tom-ainc/kitchen_bench_extension/51f2XC2JslL._SX522_.jpg

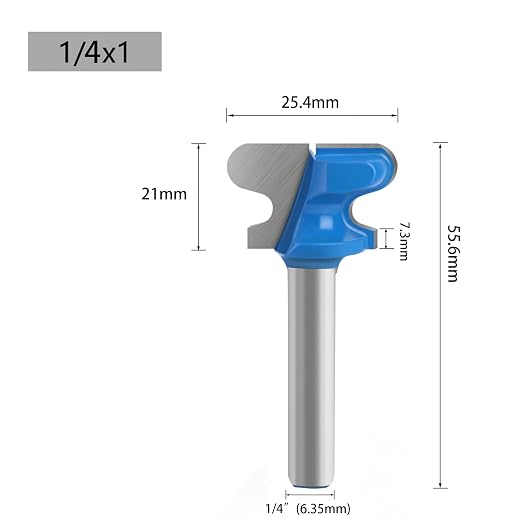
51f2XC2JslL._SX522_.jpg
