tom-ainc/kitchen_bench_extension/golf_project/golf_out/v0004_pose_clip_on_bracket/renders/r001/sheet.png

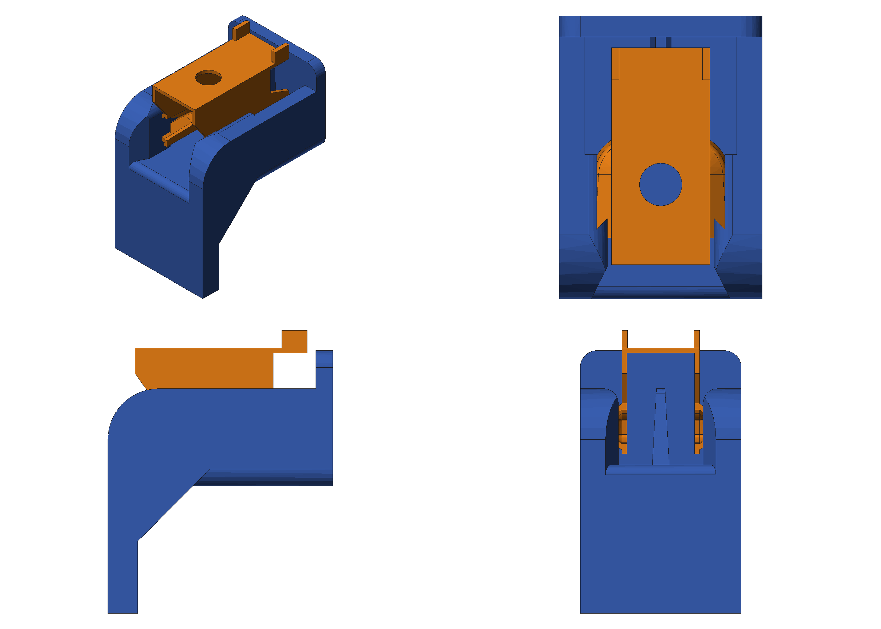
golf_project/golf_out/v0004_pose_clip_on_bracket/renders/r001/sheet.png
