tom-ainc/kitchen_bench_extension/golf_project/golf_out/v0008_option2_screws_flush/renders/r001/sheet.png

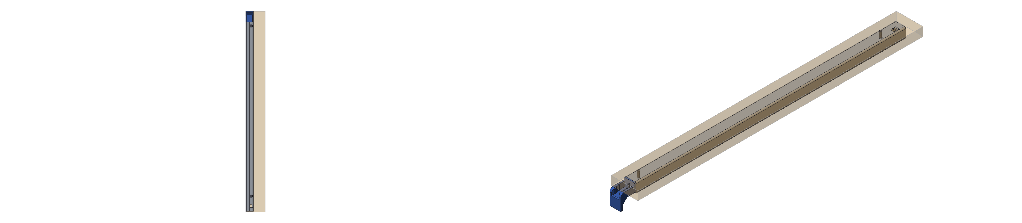
golf_project/golf_out/v0008_option2_screws_flush/renders/r001/sheet.png
