tom-ainc/kitchen_bench_extension/golf_project/golf_out/v0009_option1_closeup/renders/r001/sheet.png

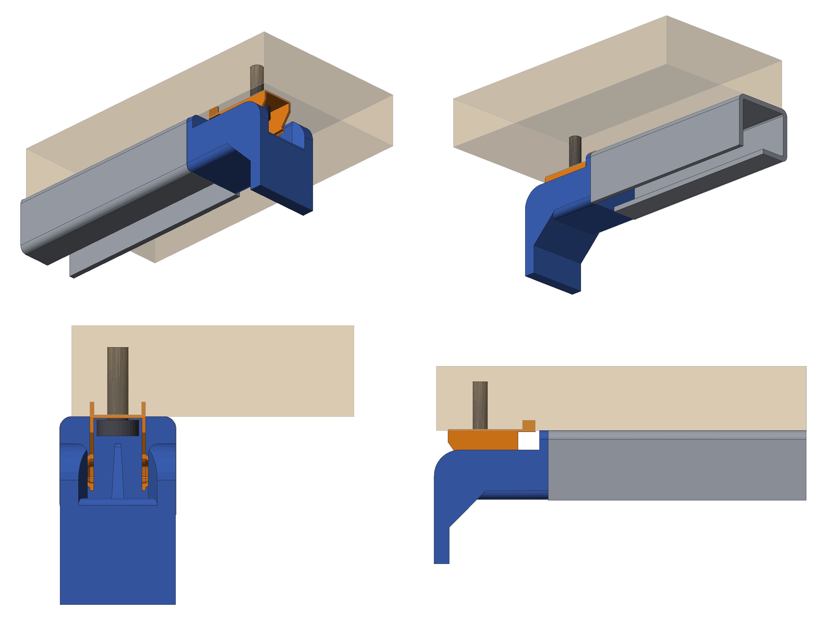
golf_project/golf_out/v0009_option1_closeup/renders/r001/sheet.png
