tom-ainc/kitchen_bench_extension/golf_project/golf_out/v0011_drawbar_boxes_opt1_notch/renders/r001/sheet.png

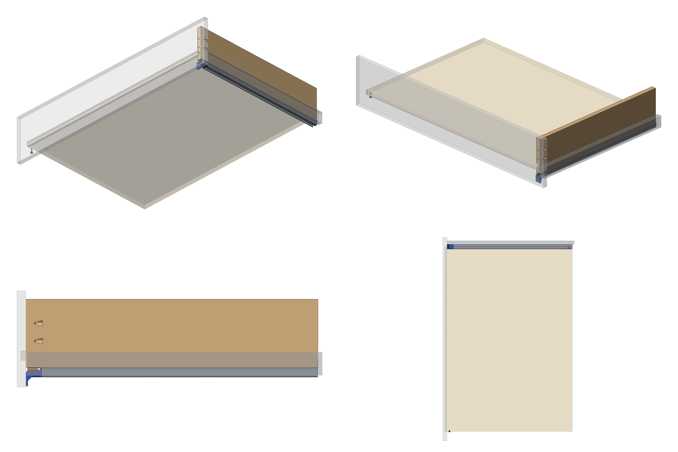
golf_project/golf_out/v0011_drawbar_boxes_opt1_notch/renders/r001/sheet.png
