tom-ainc/kitchen_bench_extension/golf_project/golf_out/v0016_pack_base_clip/renders/r001/sheet.png

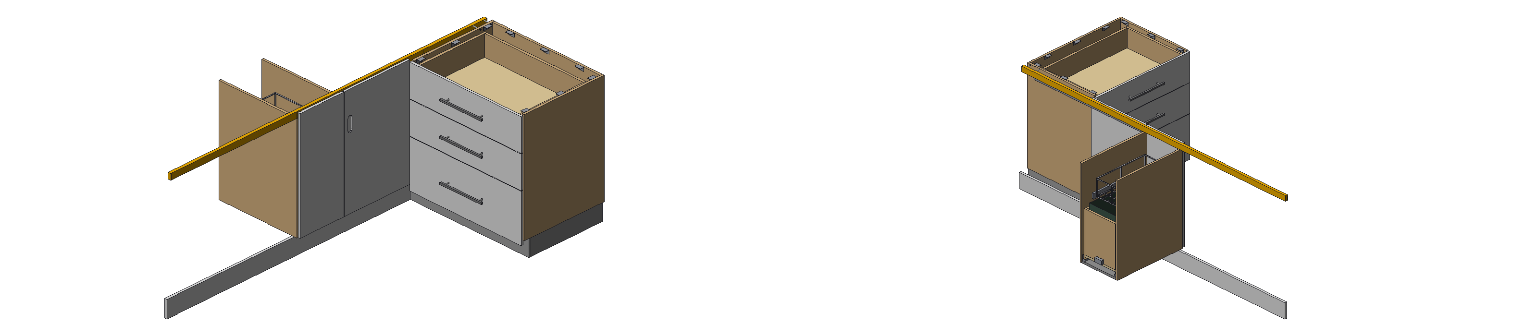
golf_project/golf_out/v0016_pack_base_clip/renders/r001/sheet.png
