tom-ainc/kitchen_bench_extension/golf_project/golf_out/v0017_detail_opt1_front/renders/r001/view_1__1.0__1.2__0.9_.png

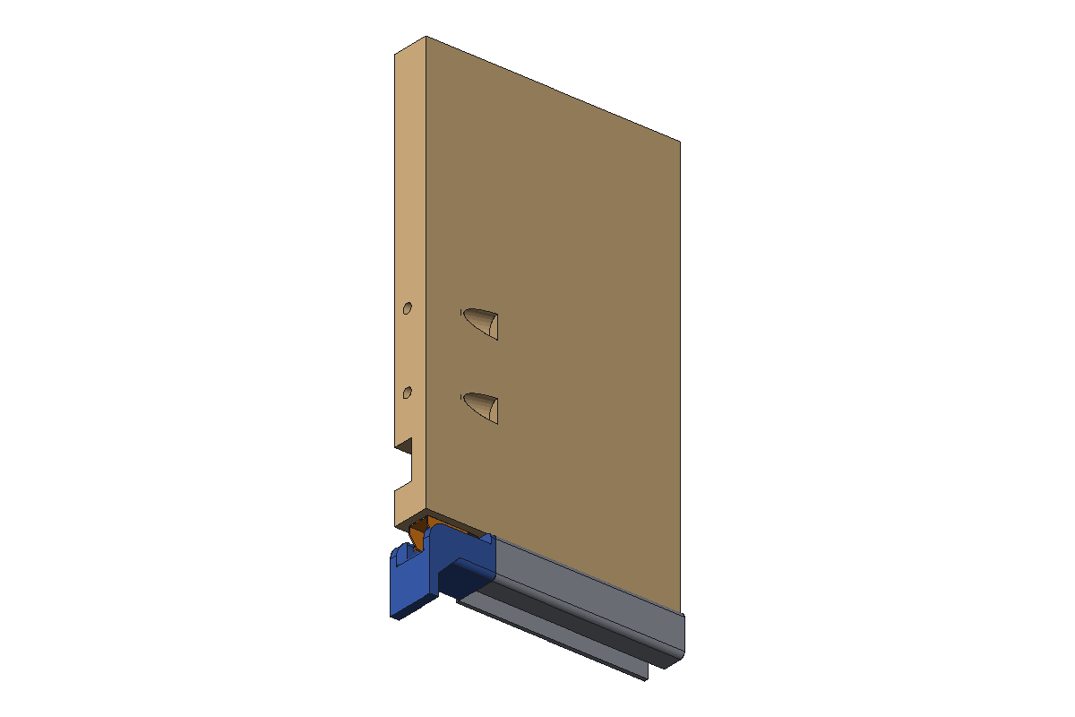
golf_project/golf_out/v0017_detail_opt1_front/renders/r001/view_1__1.0__1.2__0.9_.png
