tom-ainc/kitchen_bench_extension/golf_project/golf_out/v0023_cove_pull_r9_5/renders/r002/view_1_right.png

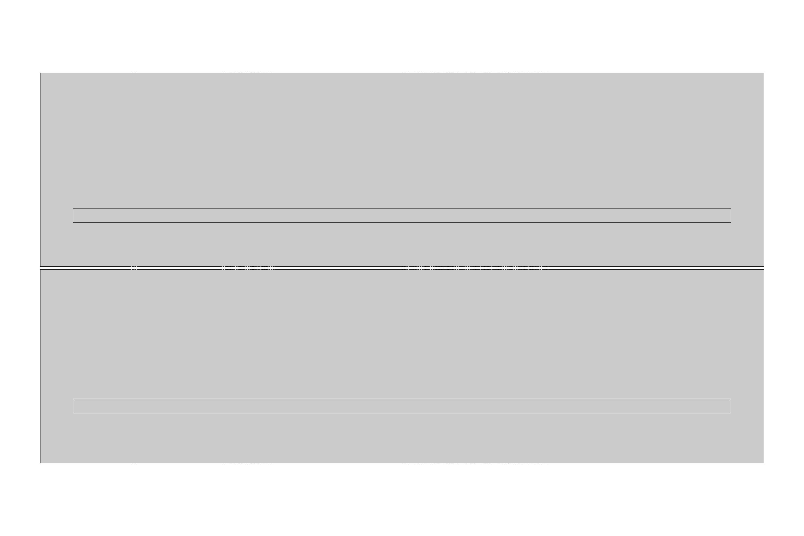
golf_project/golf_out/v0023_cove_pull_r9_5/renders/r002/view_1_right.png
