tom-ainc/kitchen_bench_extension/golf_project/golf_out/v0027_pull_back_cove_view/renders/r001/view_1_front.png

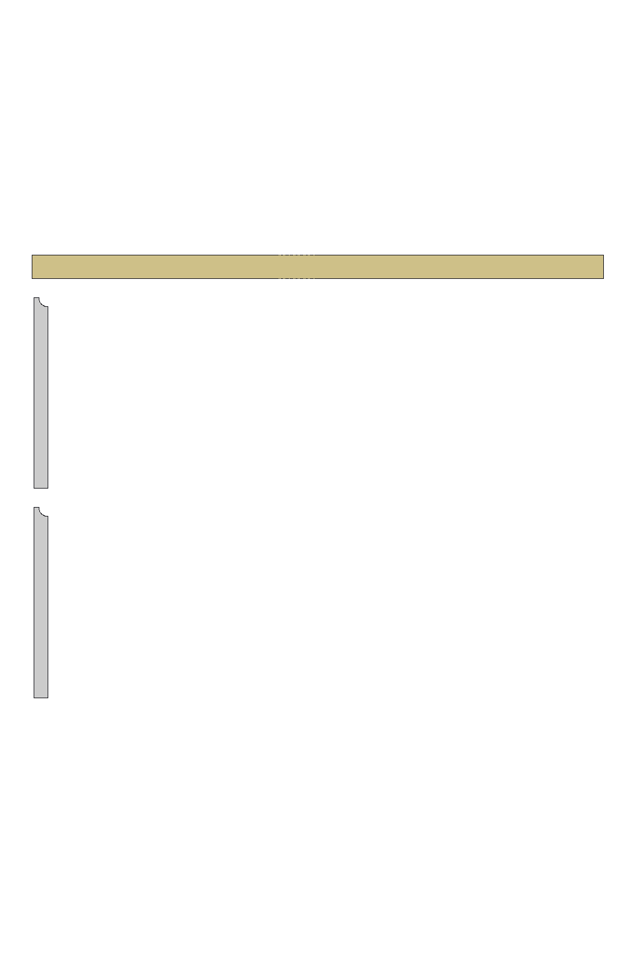
golf_project/golf_out/v0027_pull_back_cove_view/renders/r001/view_1_front.png
