tom-ainc/kitchen_bench_extension/golf_project/golf_out/v0028_pull_groove/renders/r001/sheet.png

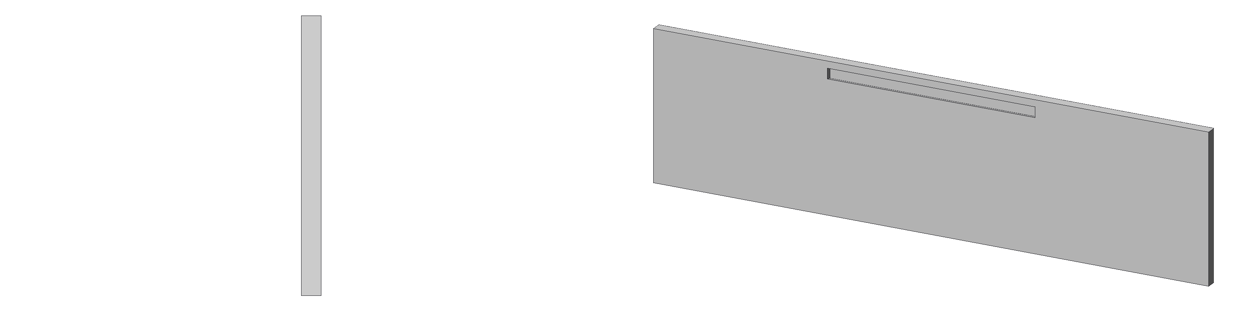
golf_project/golf_out/v0028_pull_groove/renders/r001/sheet.png
