tom-ainc/kitchen_bench_extension/golf_project/golf_out/v0035_pull_rebate/renders/r001/view_2_right.png

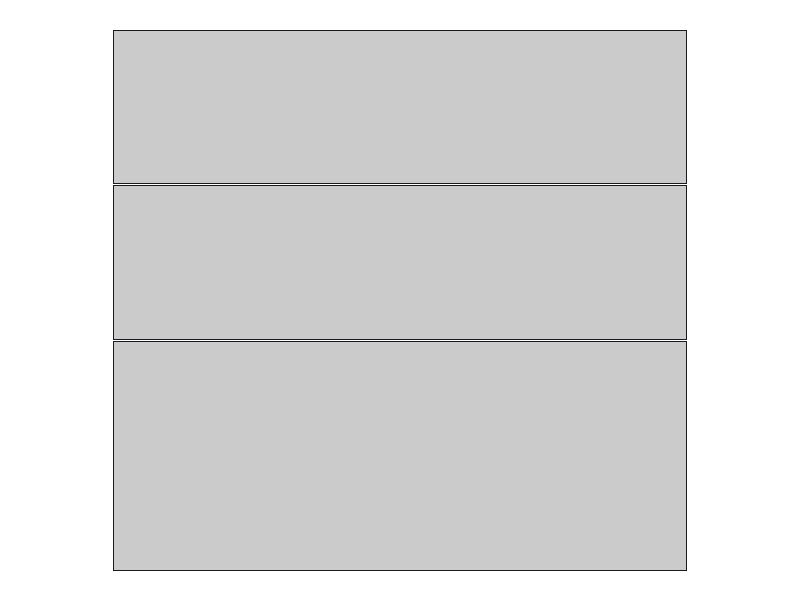
golf_project/golf_out/v0035_pull_rebate/renders/r001/view_2_right.png
