tom-ainc/kitchen_bench_extension/golf_project/golf_out/v0056_pocket_bore_through_face/renders/r001/view_1_bottom.png

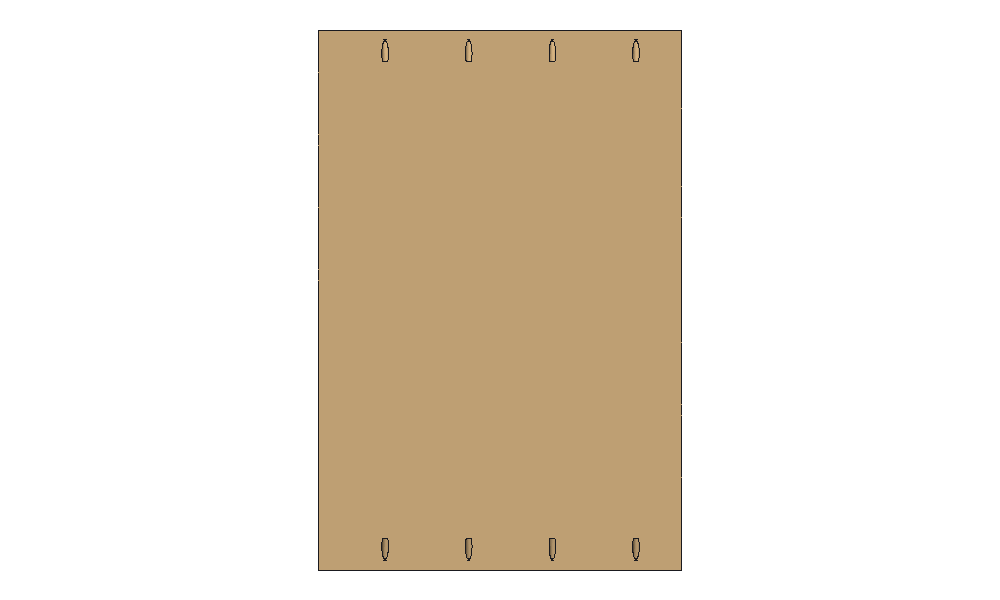
golf_project/golf_out/v0056_pocket_bore_through_face/renders/r001/view_1_bottom.png
