tom-ainc/kitchen_bench_extension/golf_project/golf_out/v0057_pocket_bore_clears_face/renders/r001/sheet.png

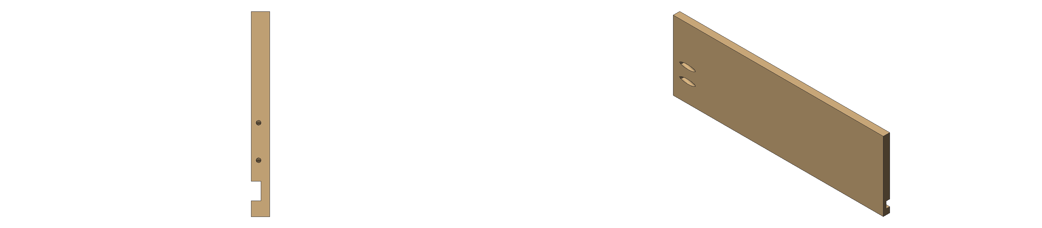
golf_project/golf_out/v0057_pocket_bore_clears_face/renders/r001/sheet.png
