tom-ainc/kitchen_bench_extension/golf_project/golf_out/v0059_ext/renders/r001/view_1__1.0__1.0__-0.8_.png

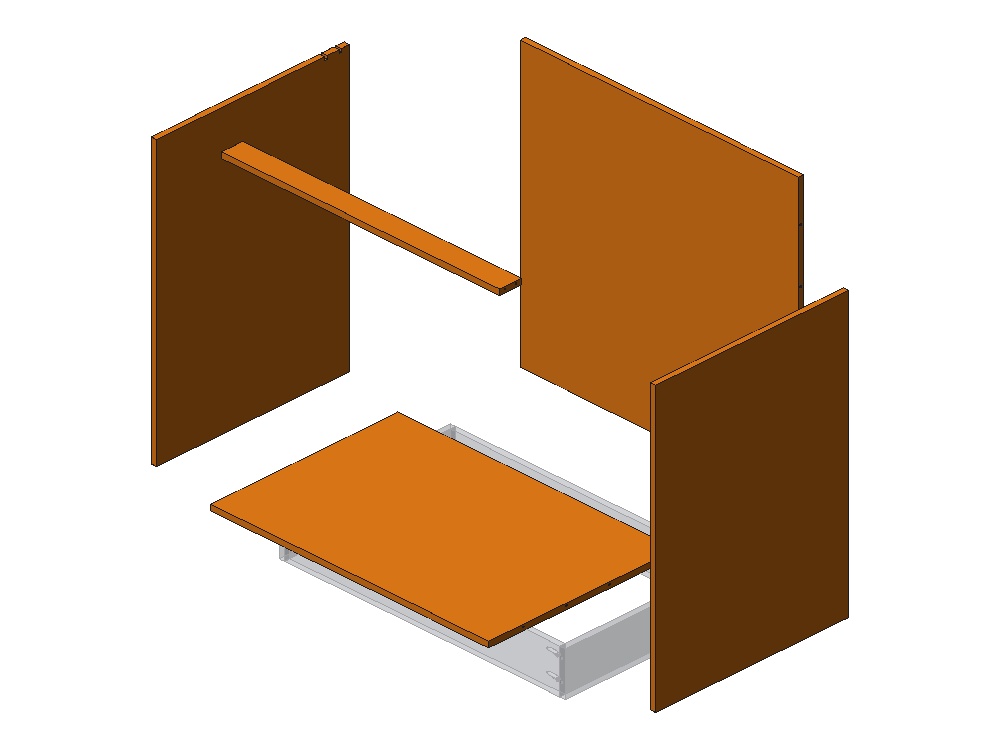
golf_project/golf_out/v0059_ext/renders/r001/view_1__1.0__1.0__-0.8_.png
