tom-ainc/kitchen_bench_extension/golf_project/golf_out/v0102_ext/renders/r003/view_1_iso.png

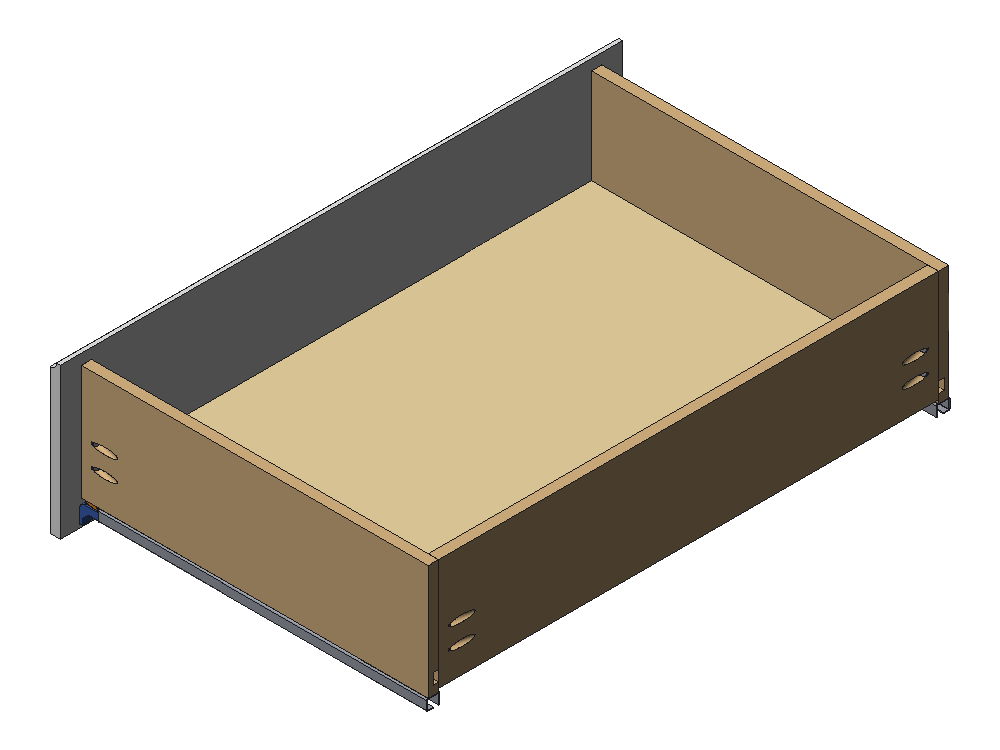
golf_project/golf_out/v0102_ext/renders/r003/view_1_iso.png
