tom-ainc/kitchen_bench_extension/golf_project/golf_out/v0128_ext/renders/r001/view_1__1.0__-1.0__-0.8_.png

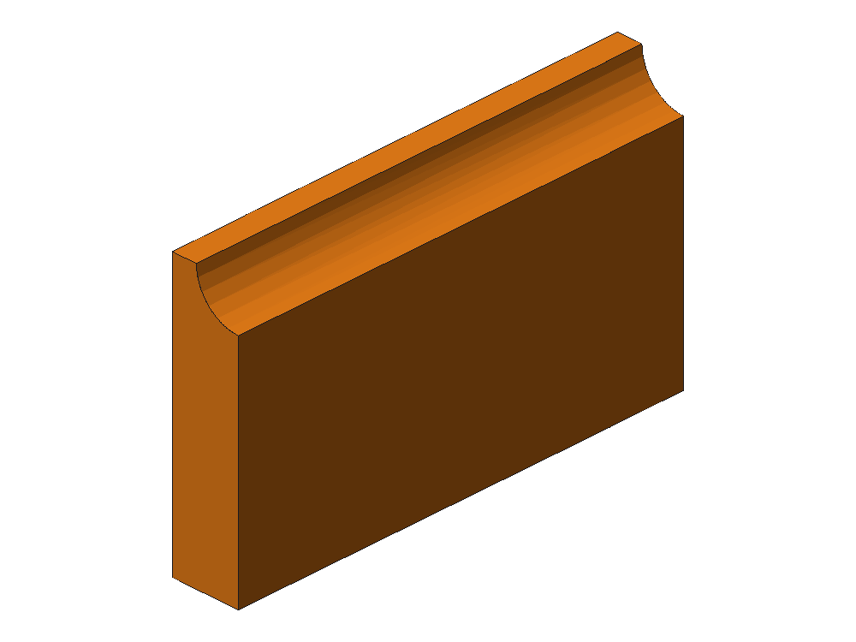
golf_project/golf_out/v0128_ext/renders/r001/view_1__1.0__-1.0__-0.8_.png
