tom-ainc/kitchen_bench_extension/golf_project/golf_out/v0133_overview_renders/renders/r005/view_1__1.0__0.55__-0.6_.png

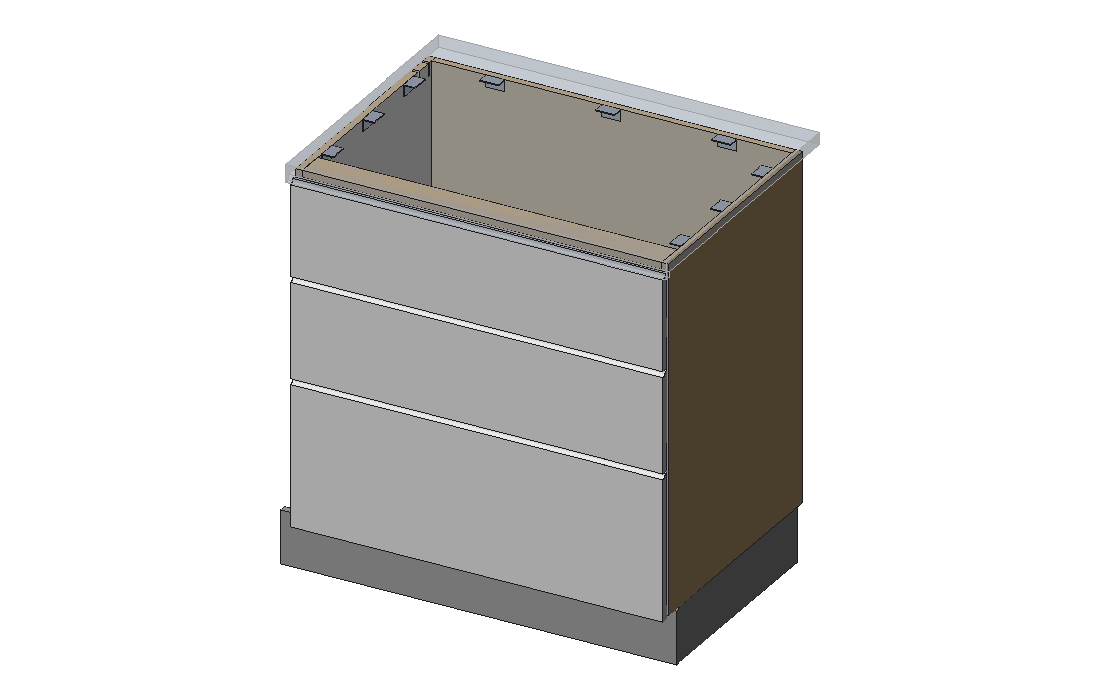
golf_project/golf_out/v0133_overview_renders/renders/r005/view_1__1.0__0.55__-0.6_.png
