tom-ainc/kitchen_bench_extension/golf_project/golf_out/v0135_mitre_pull/renders/r001/sheet.png

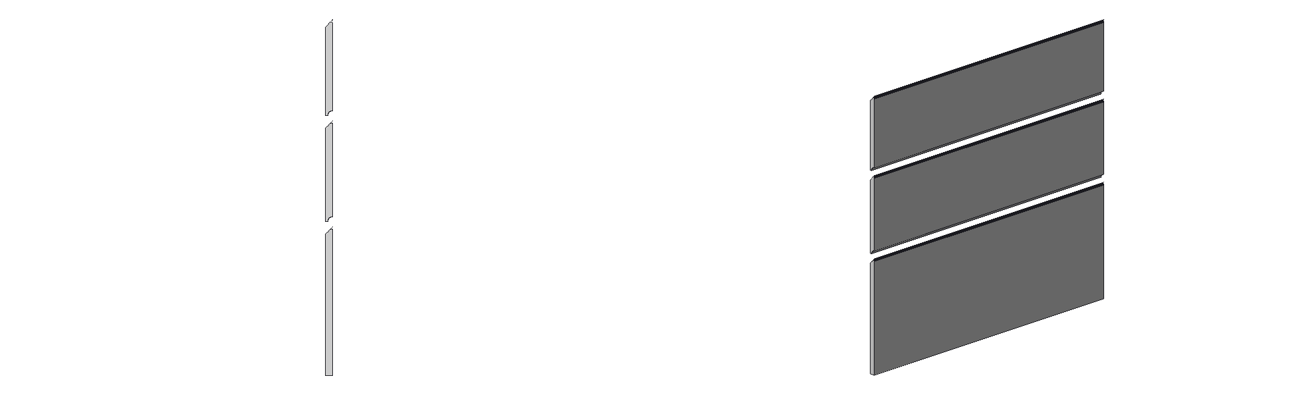
golf_project/golf_out/v0135_mitre_pull/renders/r001/sheet.png
