tom-ainc/kitchen_bench_extension/golf_project/golf_out/v0137_mitre_single_cutter/renders/r001/sheet.png

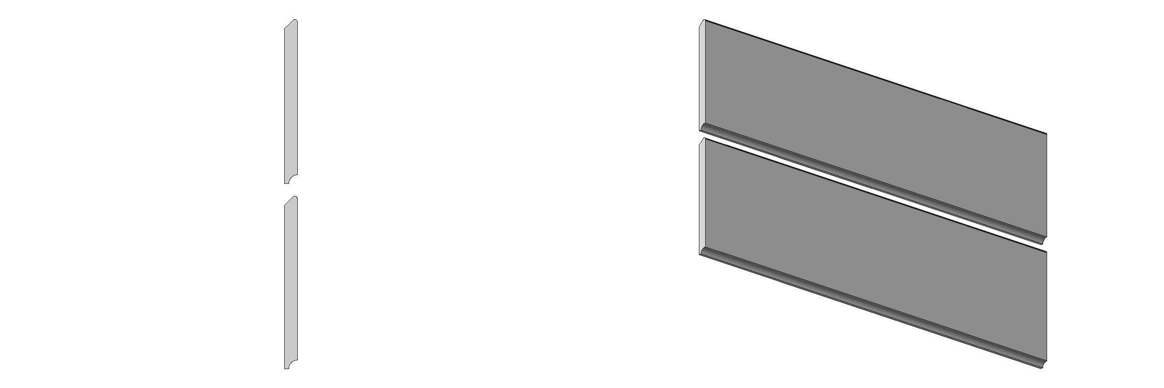
golf_project/golf_out/v0137_mitre_single_cutter/renders/r001/sheet.png
