tom-ainc/kitchen_bench_extension/golf_project/golf_out/v0138_mitre_d1_215/renders/r001/view_1__1.0__-0.6__-0.1_.png

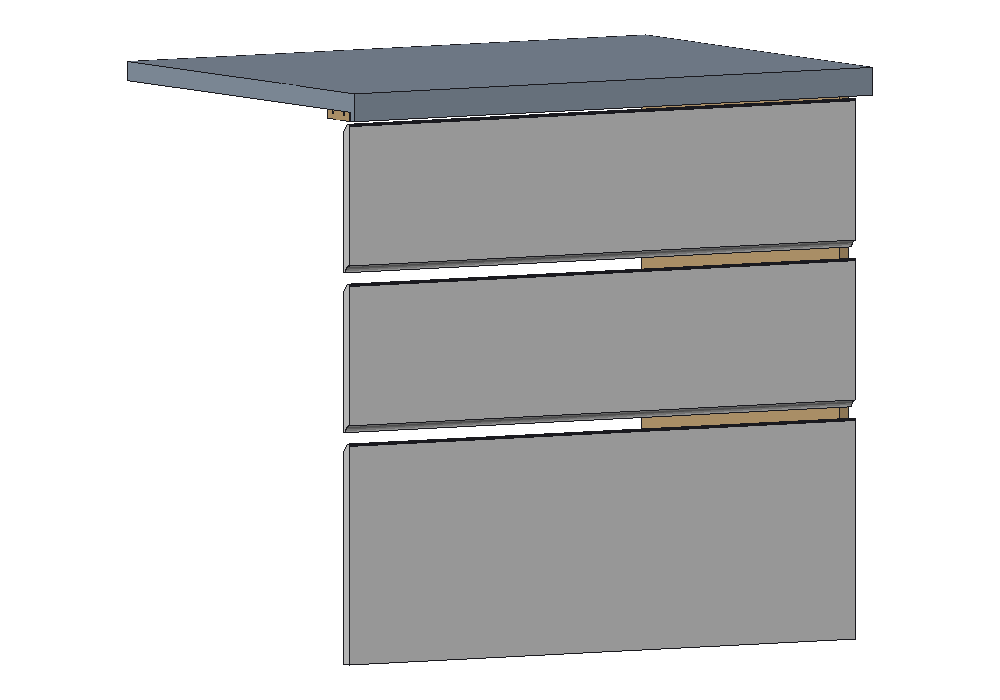
golf_project/golf_out/v0138_mitre_d1_215/renders/r001/view_1__1.0__-0.6__-0.1_.png
