tom-ainc/kitchen_bench_extension/golf_project/golf_out/v0140_mitre_all_cover1/renders/r001/sheet.png

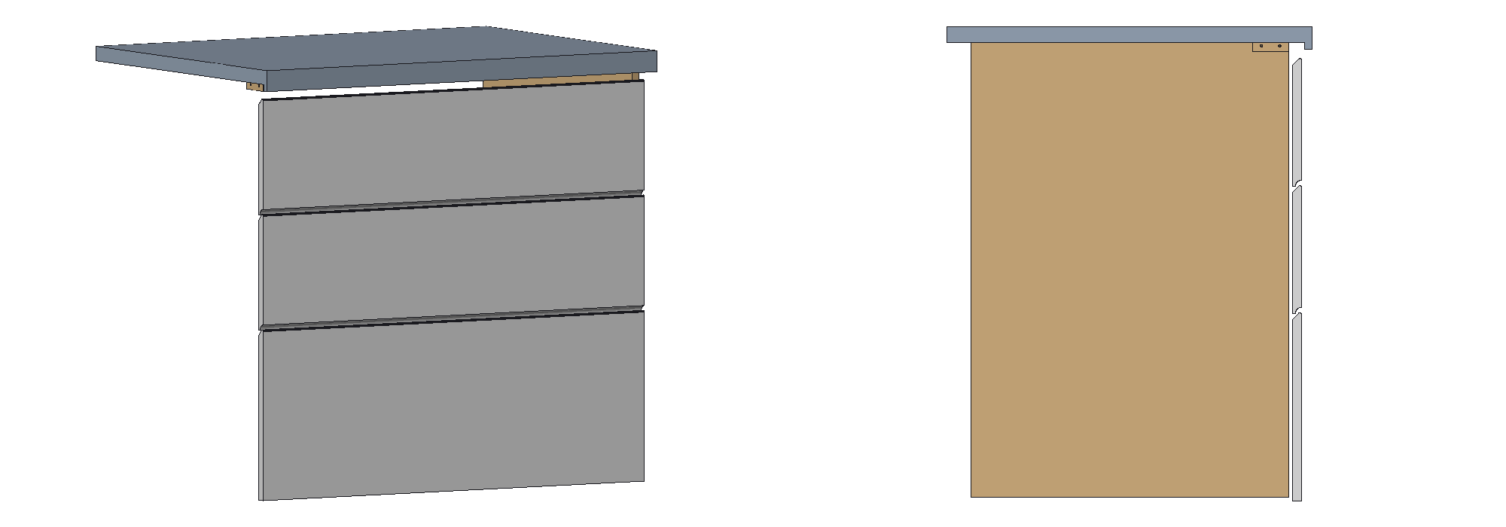
golf_project/golf_out/v0140_mitre_all_cover1/renders/r001/sheet.png
