tom-ainc/kitchen_bench_extension/golf_project/golf_out/v0154_ext/renders/r004/view_1__1.0__1.0__-0.5_.png

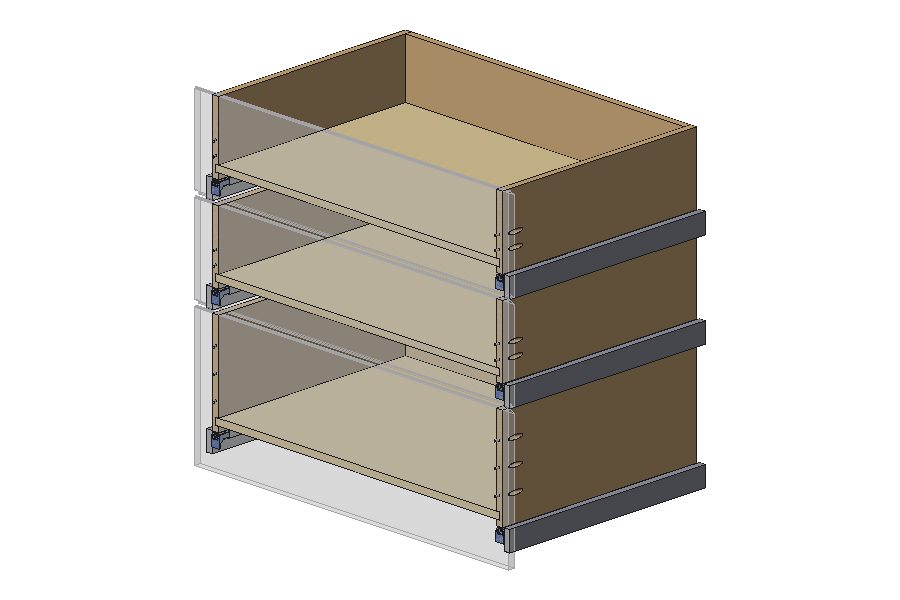
golf_project/golf_out/v0154_ext/renders/r004/view_1__1.0__1.0__-0.5_.png
