tom-ainc/kitchen_bench_extension/golf_project/golf_out/v0155_ext/renders/r001/view_1__0.35__-1.0__-0.55_.png

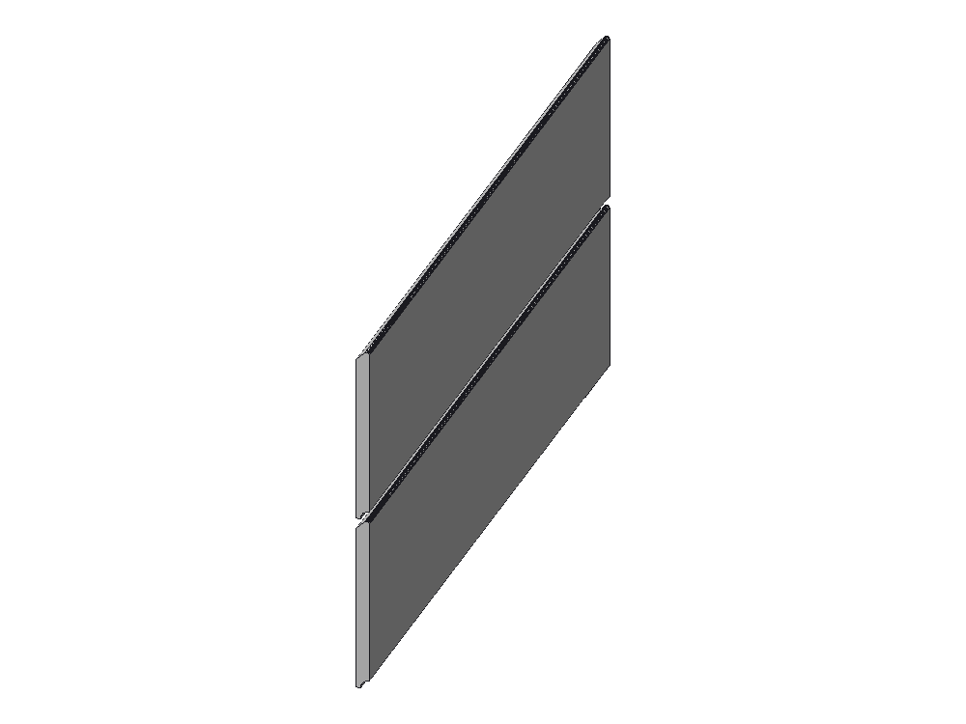
golf_project/golf_out/v0155_ext/renders/r001/view_1__0.35__-1.0__-0.55_.png
