tom-ainc/kitchen_bench_extension/golf_project/golf_out/v0157_bit_edge/renders/r001/view_2__0.35__-1.0__-0.55_.png

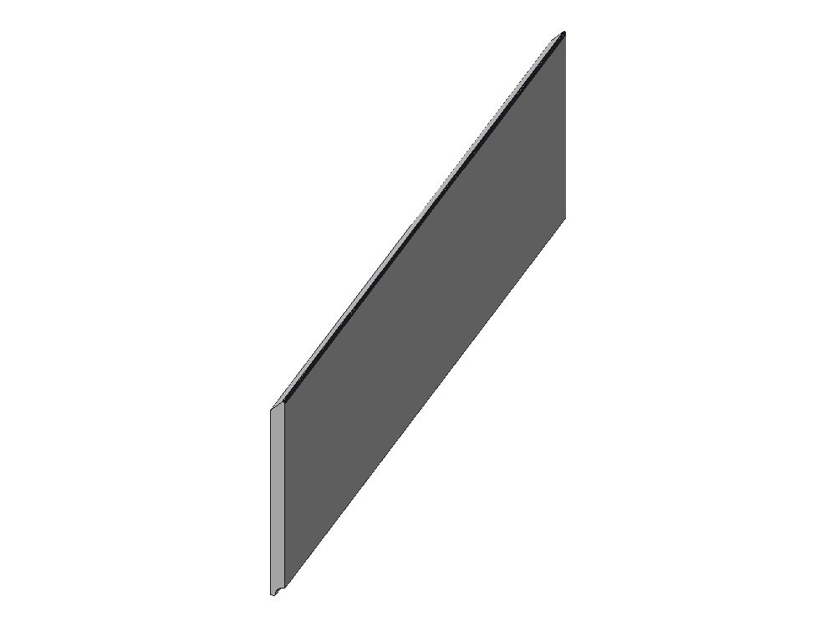
golf_project/golf_out/v0157_bit_edge/renders/r001/view_2__0.35__-1.0__-0.55_.png
