tom-ainc/kitchen_bench_extension/golf_project/golf_out/v0163_top_strip/renders/r001/view_1__1.0__0.55__-0.6_.png

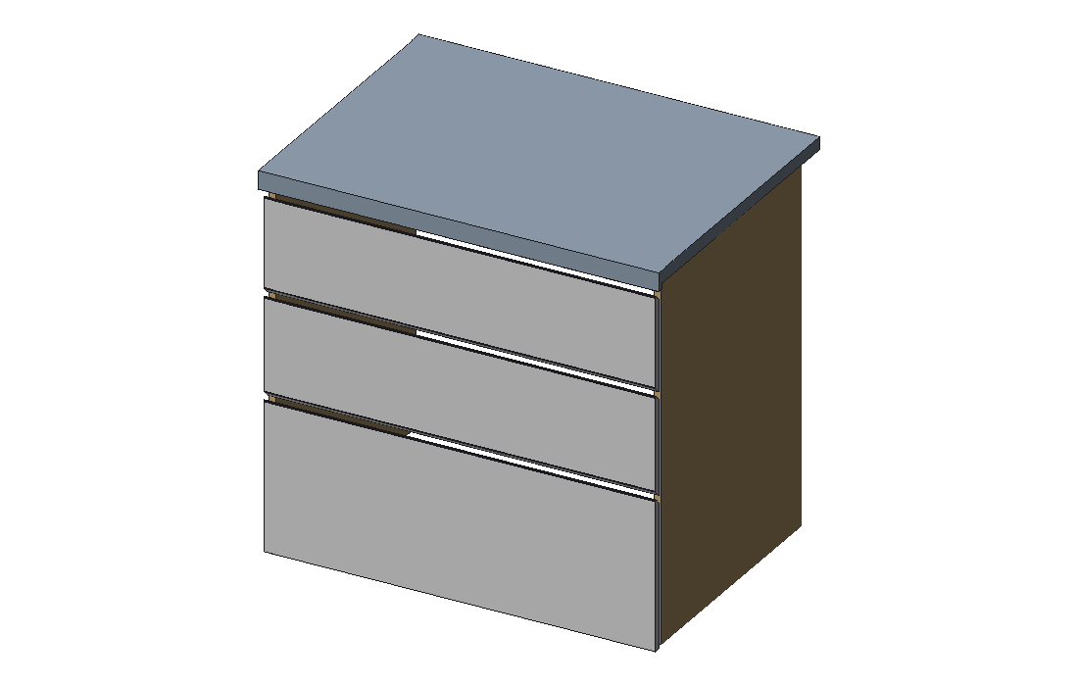
golf_project/golf_out/v0163_top_strip/renders/r001/view_1__1.0__0.55__-0.6_.png
