tom-ainc/kitchen_bench_extension/golf_project/golf_projects/kitchen_bench_extension-1/golf_out/v0034_ext/renders/r003/view_2__1.0__-1.0__-0.6_.png

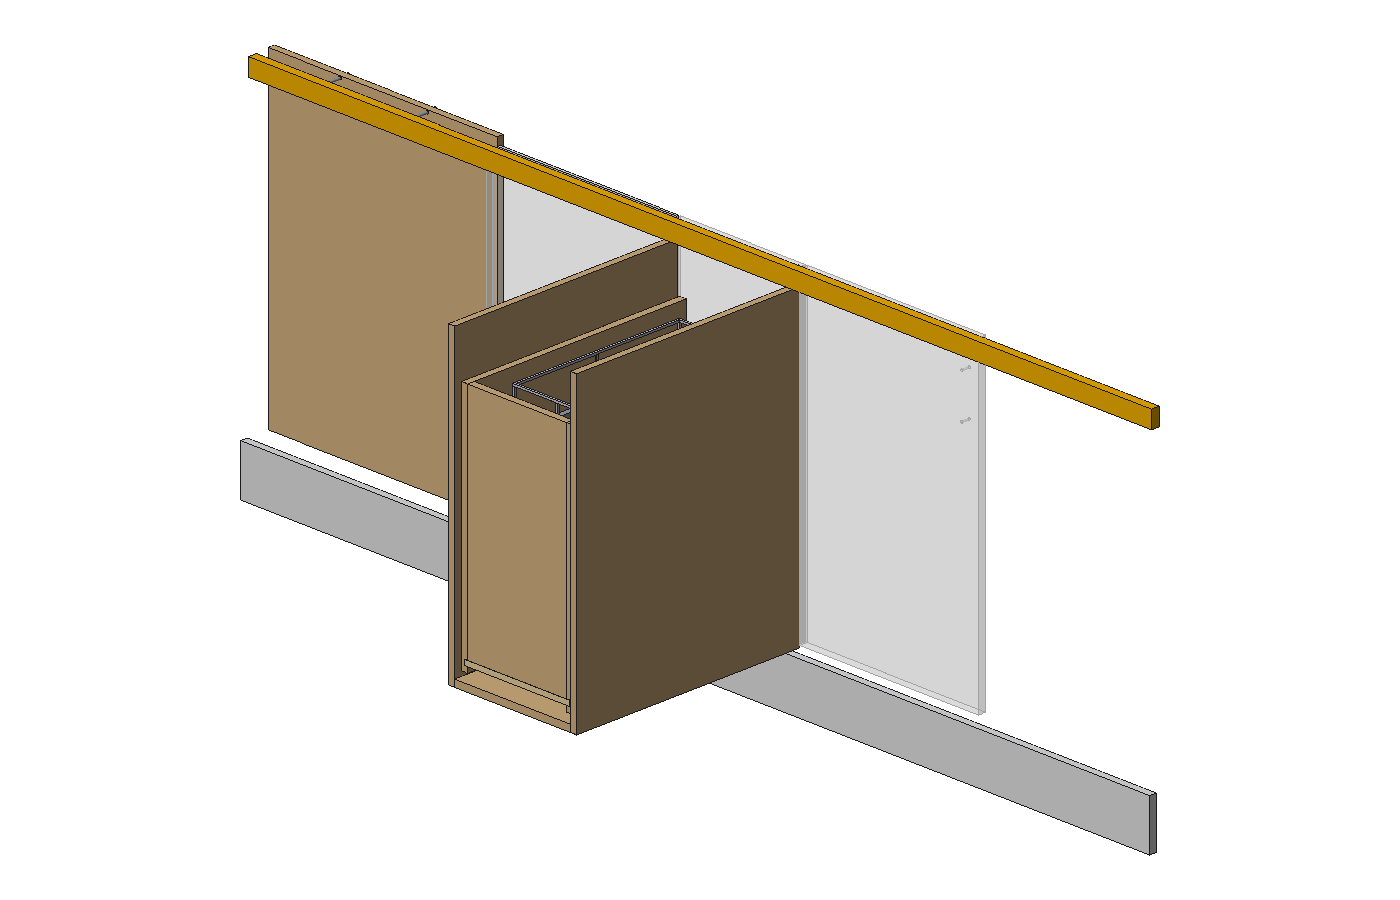
golf_project/golf_projects/kitchen_bench_extension-1/golf_out/v0034_ext/renders/r003/view_2__1.0__-1.0__-0.6_.png
