tom-ainc/kitchen_bench_extension/golf_project/golf_projects/kitchen_bench_extension-1/golf_out/v0034_ext/renders/r004/view_1_top.png

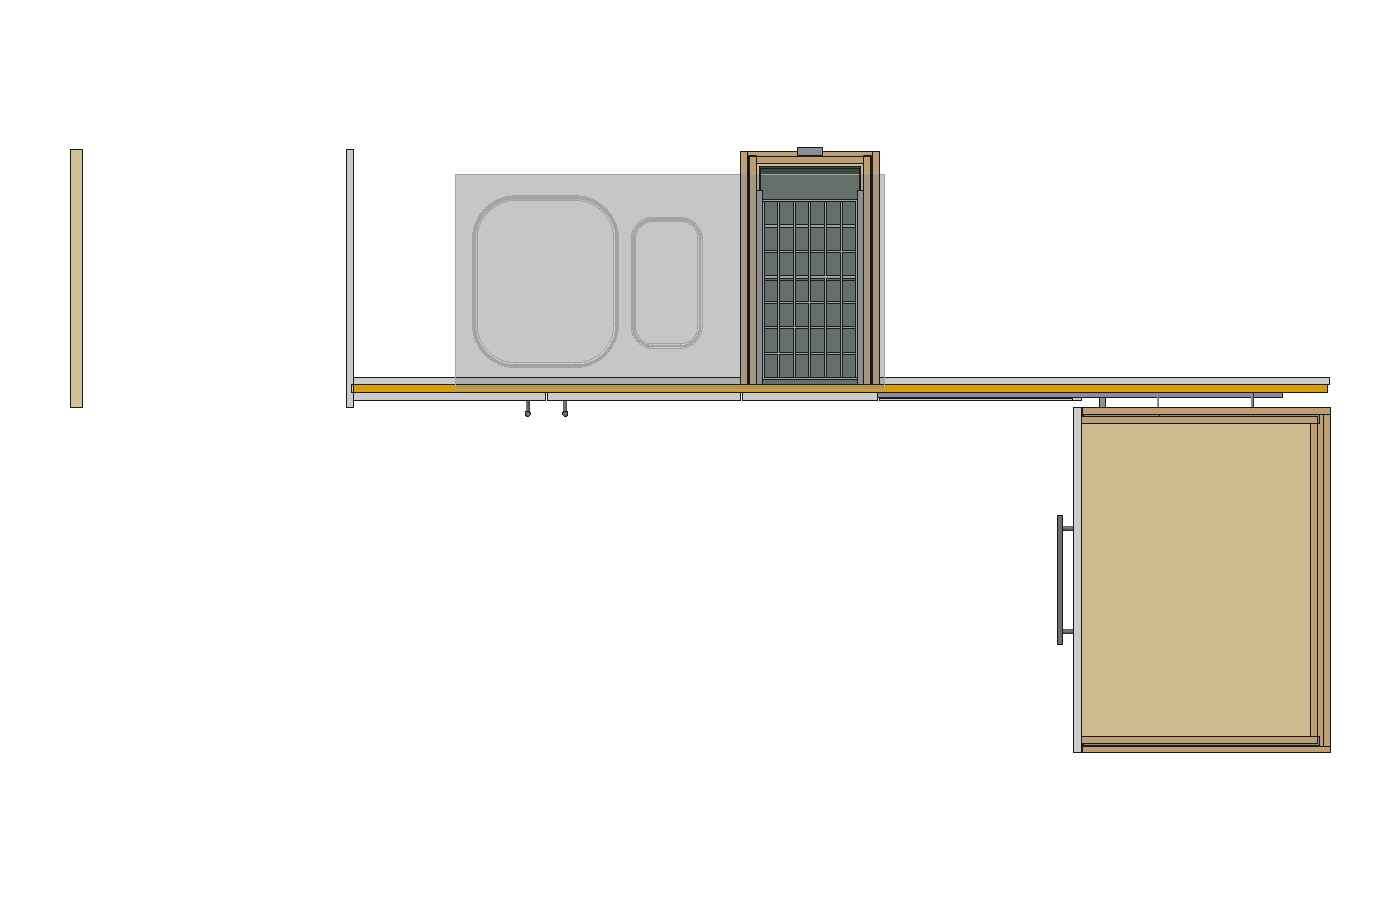
golf_project/golf_projects/kitchen_bench_extension-1/golf_out/v0034_ext/renders/r004/view_1_top.png
