tom-ainc/kitchen_bench_extension/golf_project/golf_projects/kitchen_bench_extension-1/golf_out/v0036_ext/renders/r001/view_2_left.png

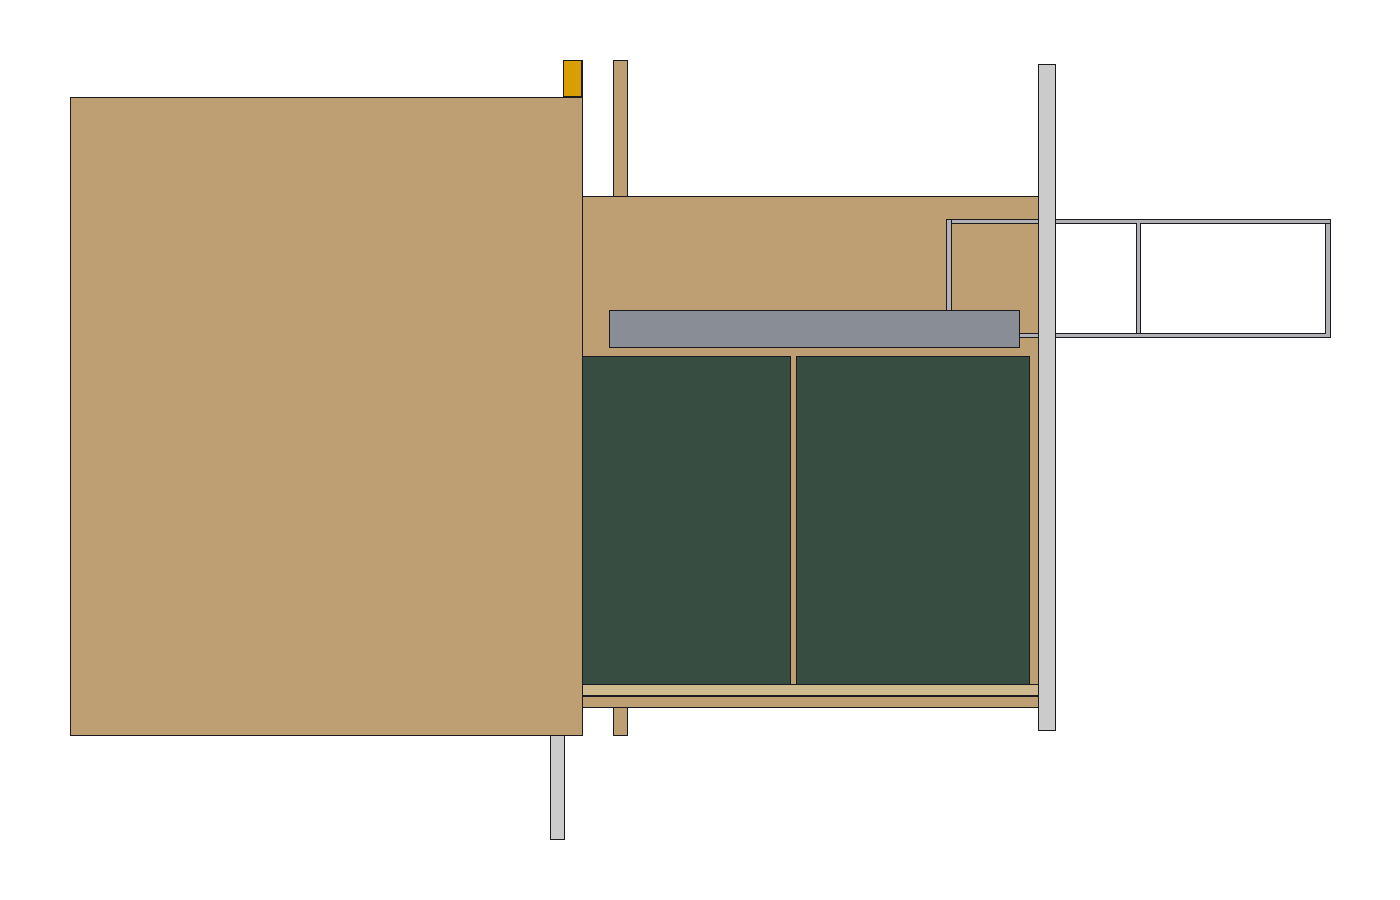
golf_project/golf_projects/kitchen_bench_extension-1/golf_out/v0036_ext/renders/r001/view_2_left.png
