tom-ainc/kitchen_bench_extension/golf_project/golf_projects/kitchen_bench_extension-1/golf_out/v0042_ext/renders/r001/view_1__0.0__-1.0__0.0_.png

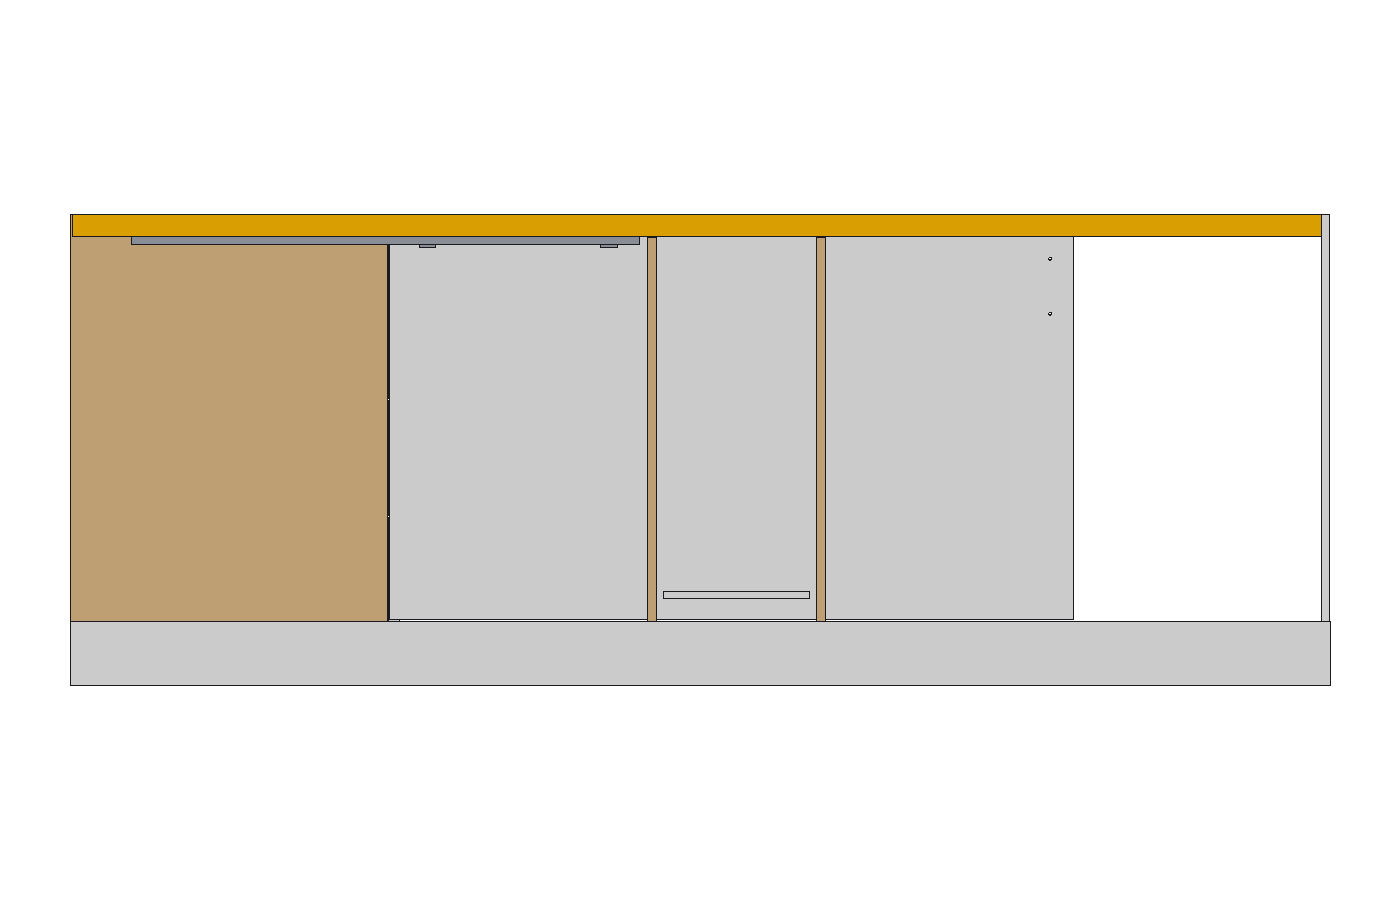
golf_project/golf_projects/kitchen_bench_extension-1/golf_out/v0042_ext/renders/r001/view_1__0.0__-1.0__0.0_.png
