tom-ainc/kitchen_bench_extension/golf_project/golf_projects/kitchen_bench_extension-1/golf_out/v0043_ext/renders/r001/view_2__-1.0__-1.0__-0.5_.png

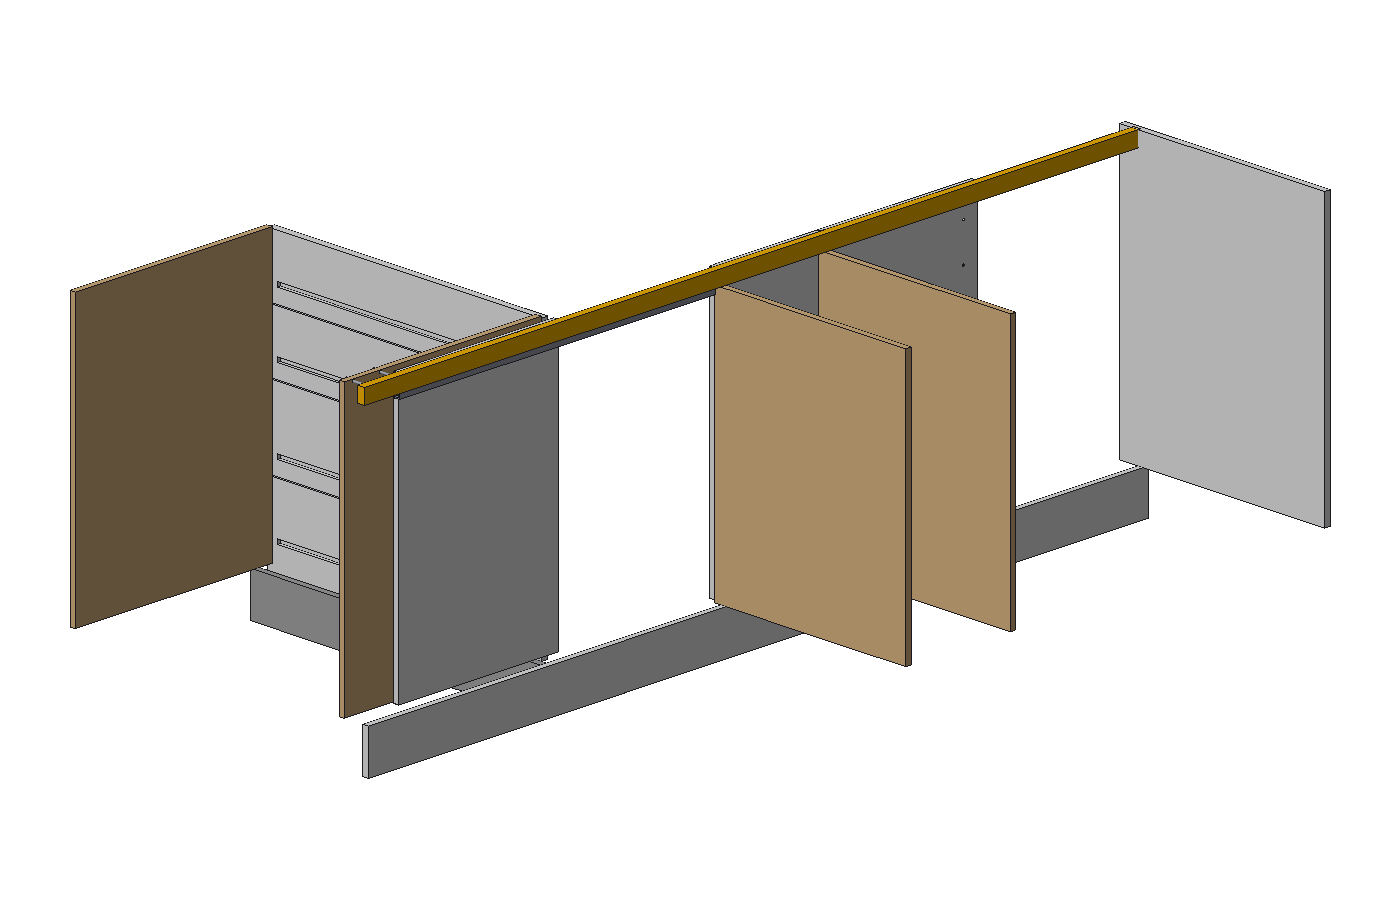
golf_project/golf_projects/kitchen_bench_extension-1/golf_out/v0043_ext/renders/r001/view_2__-1.0__-1.0__-0.5_.png
