tom-ainc/kitchen_bench_extension/golf_project/golf_projects/kitchen_bench_extension-1/golf_out/v0049_ext/renders/r001/view_1_iso.png

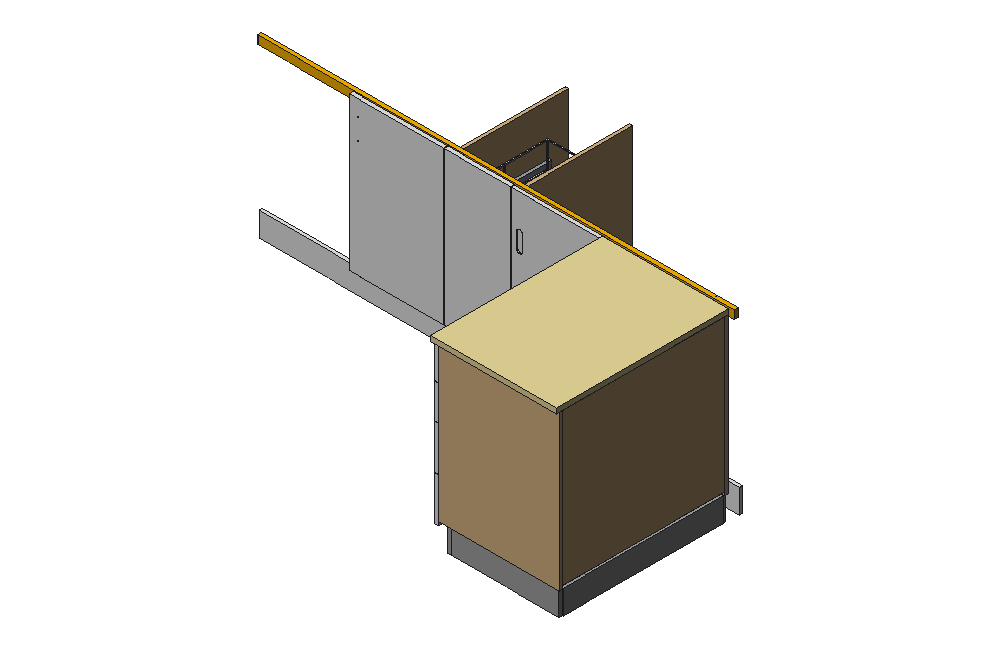
golf_project/golf_projects/kitchen_bench_extension-1/golf_out/v0049_ext/renders/r001/view_1_iso.png
