tom-ainc/kitchen_bench_extension/golf_project/golf_projects/kitchen_bench_extension-1/golf_out/v0055_alto_86_204/renders/r005/view_1__1.0__1.0__-0.5_.png

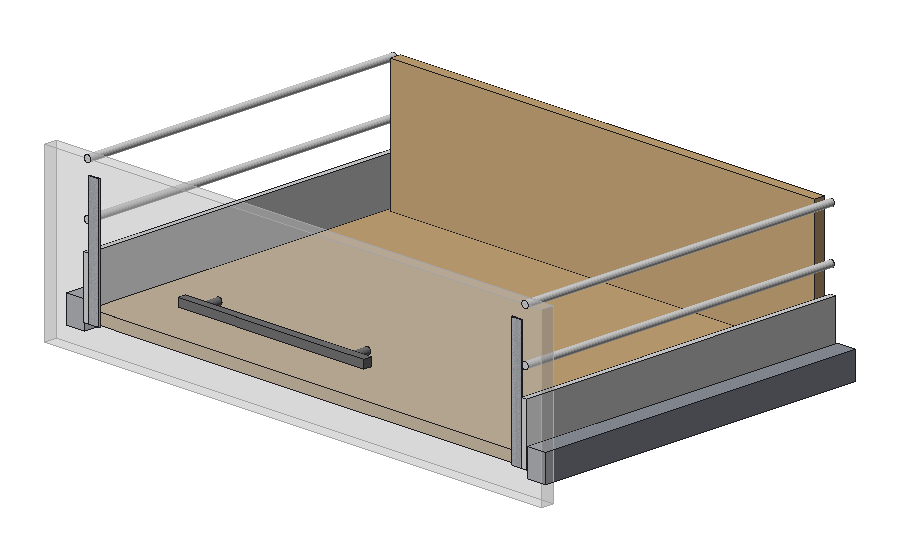
golf_project/golf_projects/kitchen_bench_extension-1/golf_out/v0055_alto_86_204/renders/r005/view_1__1.0__1.0__-0.5_.png
