tom-ainc/kitchen_bench_extension/media/2.0 pre_router_jig.jpg

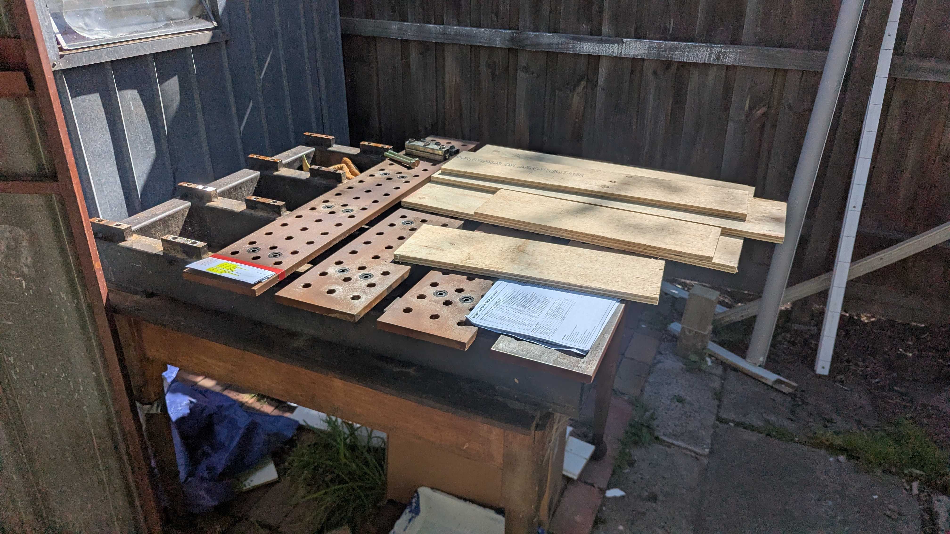
media/2.0 pre_router_jig.jpg
