tom-ainc/kitchen_bench_extension/media/3.1 router_jig.jpg

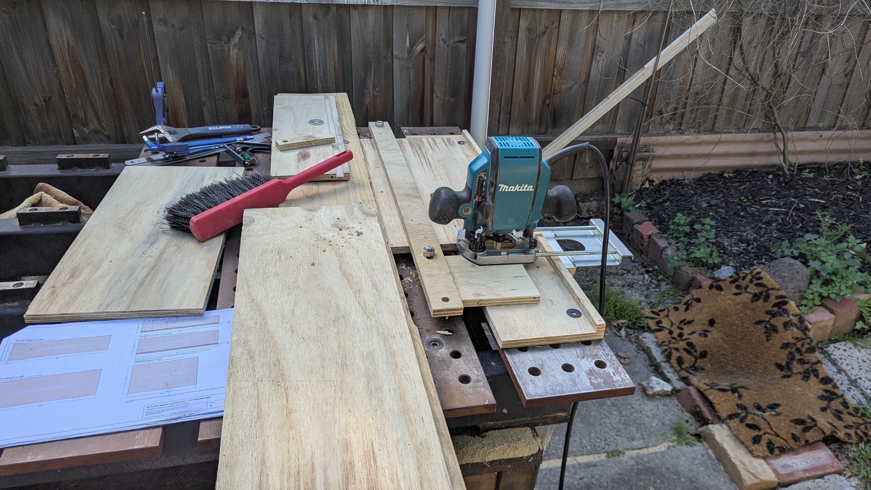
media/3.1 router_jig.jpg
