tom-ainc/kitchen_bench_extension/media/3.2 router_jig.jpg

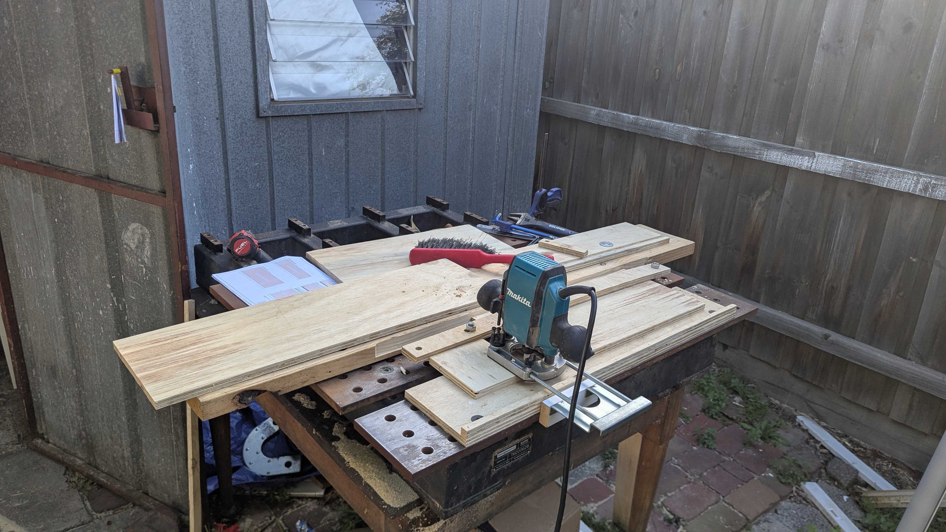
media/3.2 router_jig.jpg
