tom-ainc/kitchen_bench_extension/media/6.0 carcas_oiled.jpg

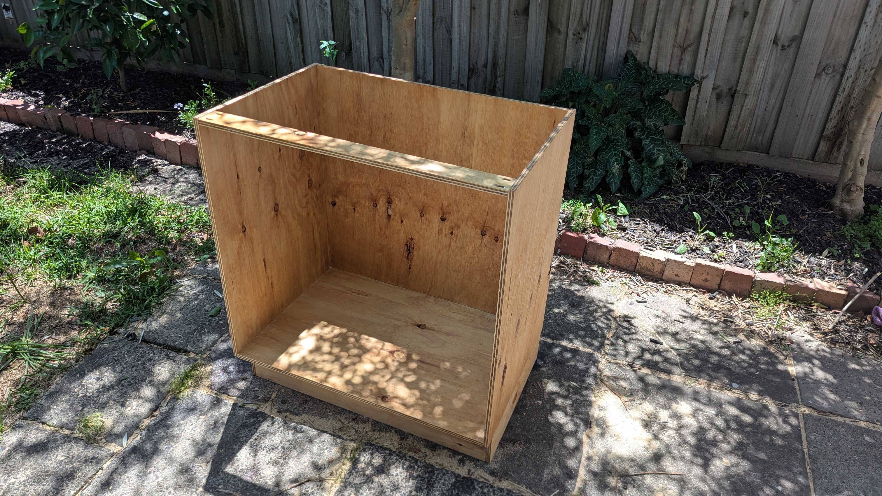
media/6.0 carcas_oiled.jpg
