tom-ainc/kitchen_bench_extension/runner front view.jpeg

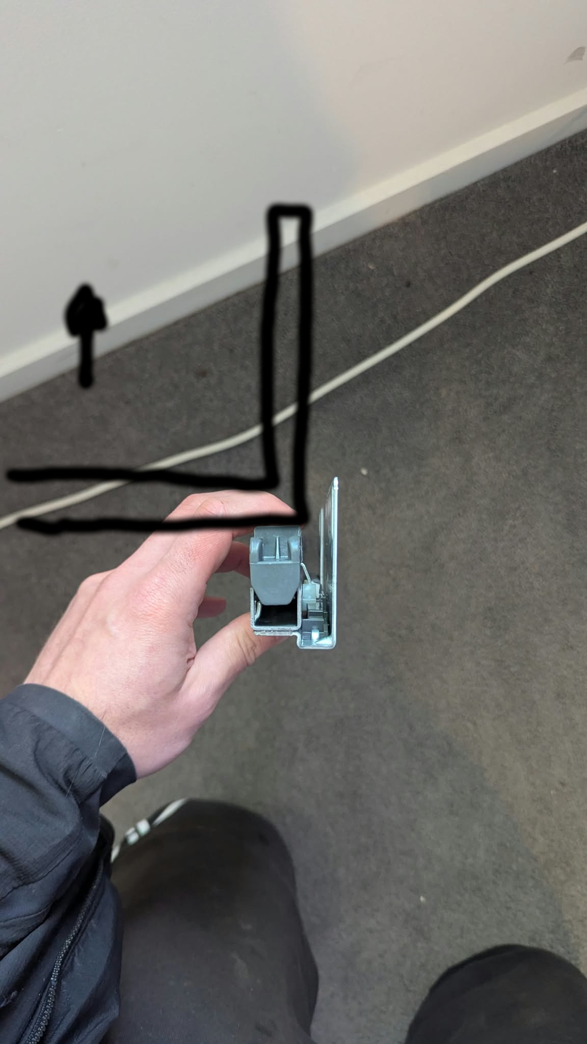
runner front view.jpeg
