tom-ainc/kitchen_bench_extension/runner side view.jpeg

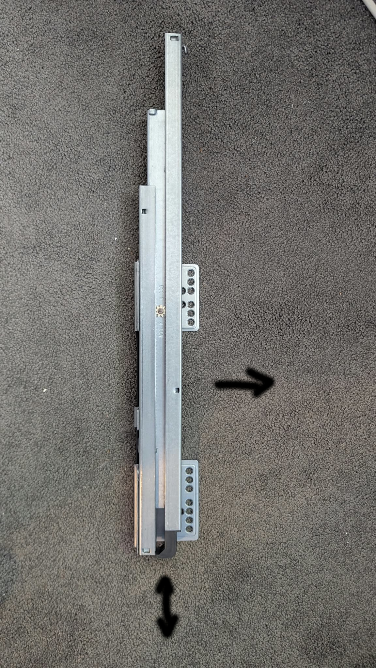
runner side view.jpeg
