tom-ainc/kitchen_bench_extension/golf_project/golf_out/v0009_option1_closeup/parts/assembly.step

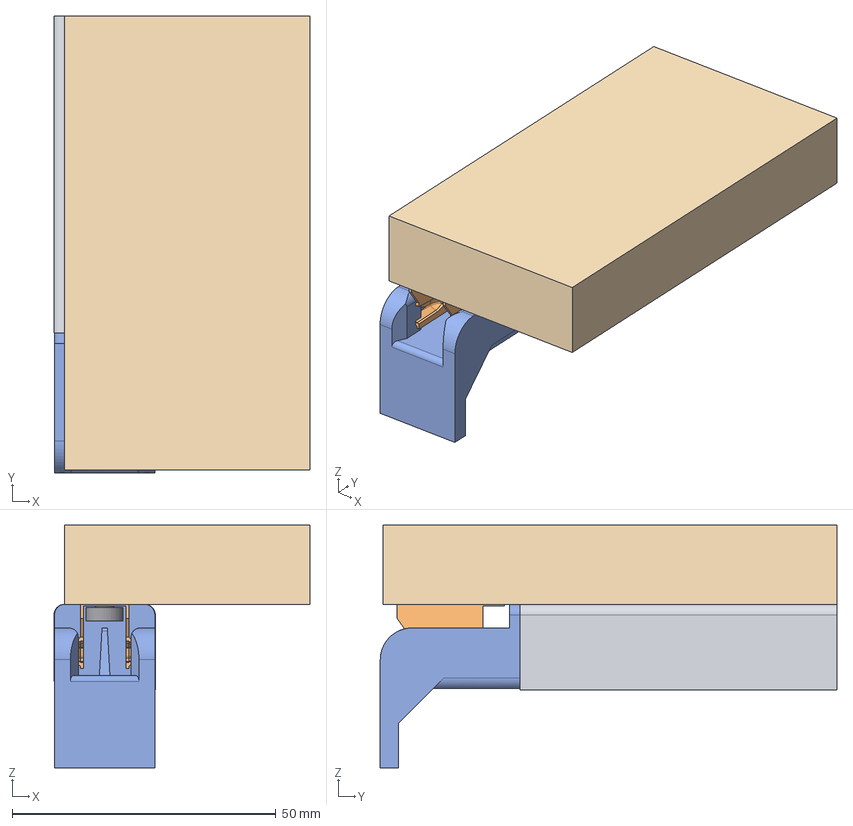
[picture p141: CAD file, 2026-11-10]
golf_project/golf_out/v0009_option1_closeup/parts/assembly.step
48.5 x 86.5 x 46.0 mm
base_15mm_ply
drawbar_L
front_bracket_L
screw_1
snap_clip
