tom-ainc/kitchen_bench_extension/golf_project/golf_out/v0018_detail_opt1_front_v2/parts/assembly.step

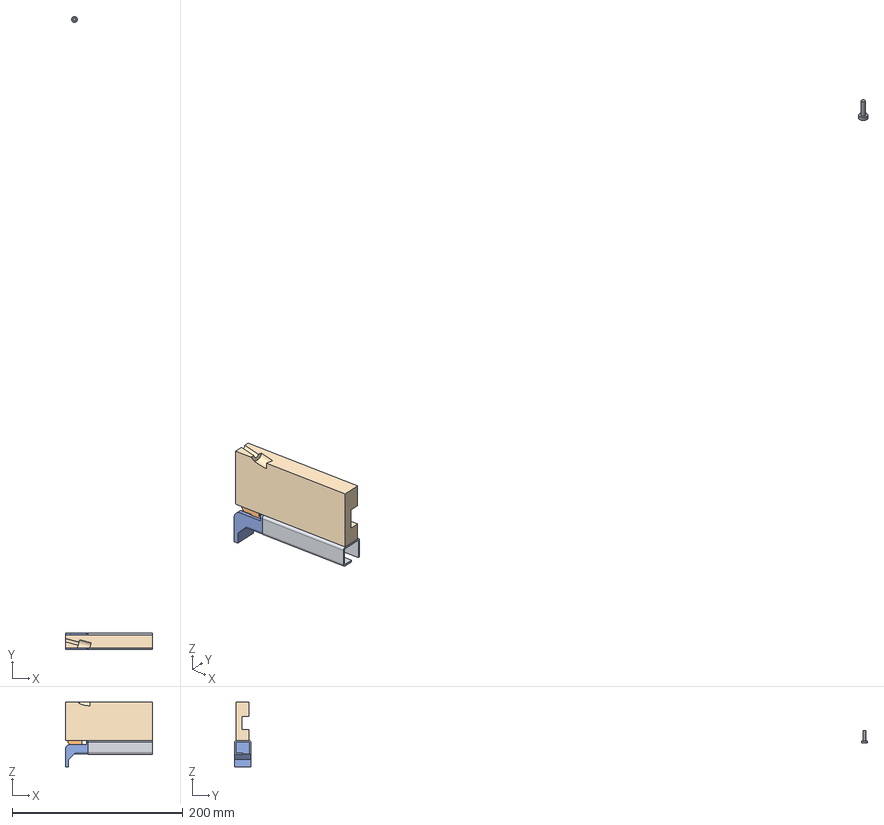
[picture p142: CAD file, 2026-11-10]
golf_project/golf_out/v0018_detail_opt1_front_v2/parts/assembly.step
102.1 x 740.9 x 76.0 mm
drawer1_side_L
drawer1_snap_clip_L
drawer1_drawbar_L
drawer1_drawbar_bracket_L
drawer1_fixing_screw_1
drawer1_fixing_screw_2
