tom-ainc/kitchen_bench_extension/golf_project/golf_out/v0058_ext/parts/assembly.step

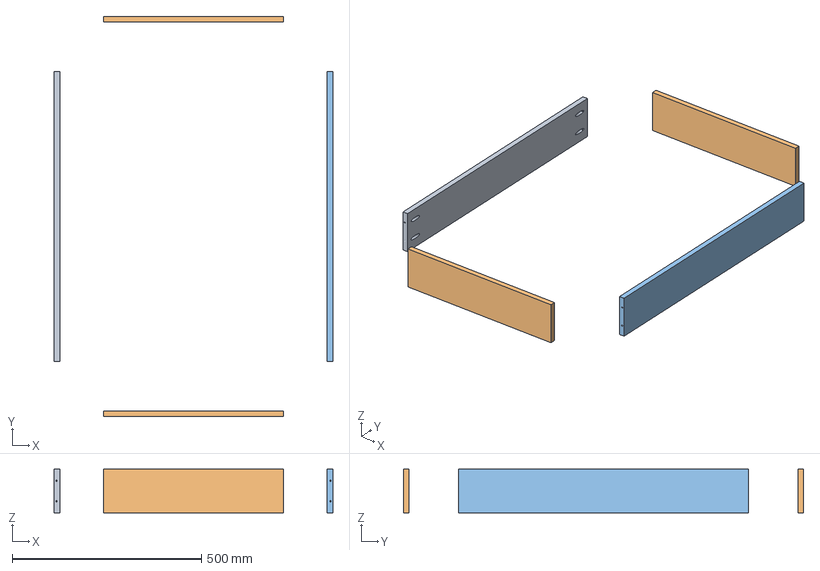
[picture p143: CAD file, 2026-11-10]
golf_project/golf_out/v0058_ext/parts/assembly.step
736.0 x 1057.0 x 115.0 mm
plinth_rail_front
plinth_return_free_end
plinth_rail_joint_end
plinth_rail_rear
