tom-ainc/kitchen_bench_extension/golf_project/golf_out/v0060_ext/parts/assembly.step

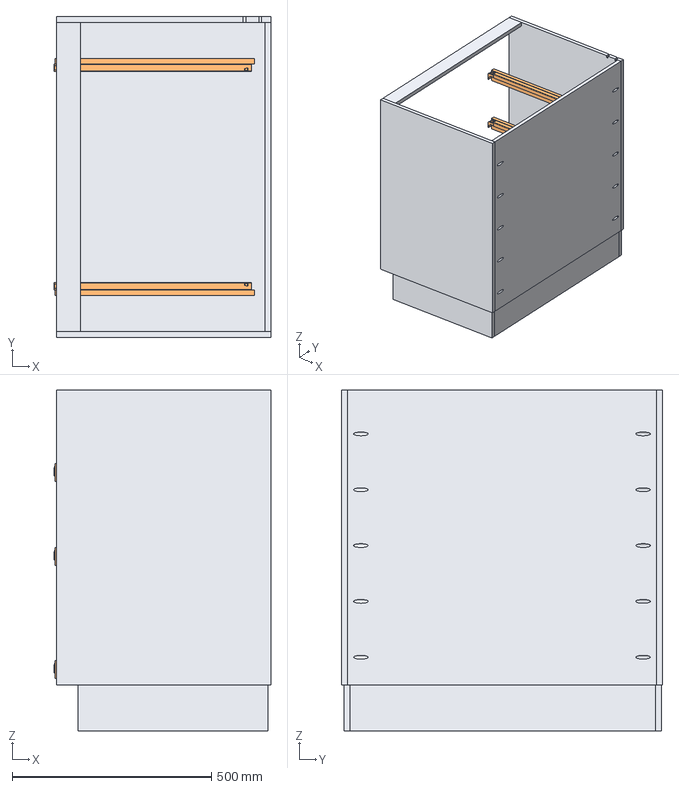
[picture p144: CAD file, 2026-11-10]
golf_project/golf_out/v0060_ext/parts/assembly.step
543.0 x 805.0 x 855.0 mm
side_free_end
carcass_bottom
carcass_back
top_rail_front
side_joint_end
drawer1_runner_L
drawer1_runner_R
drawer2_runner_L
drawer2_runner_R
drawer3_runner_L
drawer3_runner_R
drawer1_drawbar_L
drawer1_drawbar_bracket_L
drawer1_drawbar_R
drawer1_drawbar_bracket_R
drawer2_drawbar_L
drawer2_drawbar_bracket_L
drawer2_drawbar_R
drawer2_drawbar_bracket_R
drawer3_drawbar_L
drawer3_drawbar_bracket_L
drawer3_drawbar_R
drawer3_drawbar_bracket_R
plinth_rail_front
plinth_return_free_end
plinth_rail_joint_end
plinth_rail_rear
