tom-ainc/kitchen_bench_extension/golf_project/golf_out/v0073_ext/parts/assembly.step

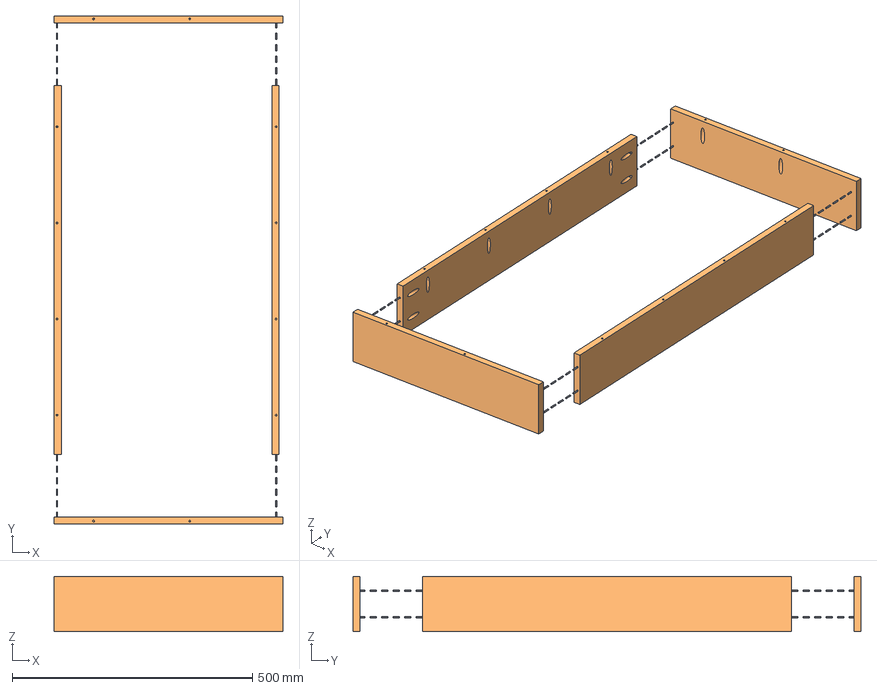
[picture p145: CAD file, 2026-11-10]
golf_project/golf_out/v0073_ext/parts/assembly.step
476.0 x 1057.0 x 115.0 mm
av_assembly_lines
P1_front_rail
P3_side_rail_free_end
P4_side_rail_joint_end
P2_rear_rail
