tom-ainc/kitchen_bench_extension/golf_project/golf_out/v0074_ext/parts/av_assembly_lines.step

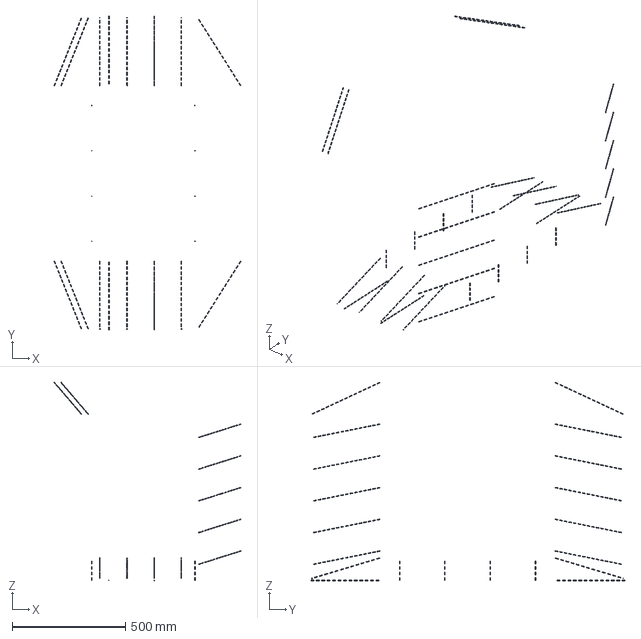
[picture p146: CAD file, 2026-11-10]
golf_project/golf_out/v0074_ext/parts/av_assembly_lines.step
825.7 x 1385.0 x 876.9 mm
