tom-ainc/kitchen_bench_extension/golf_project/golf_out/v0112_ext/parts/av_assembly_lines.step

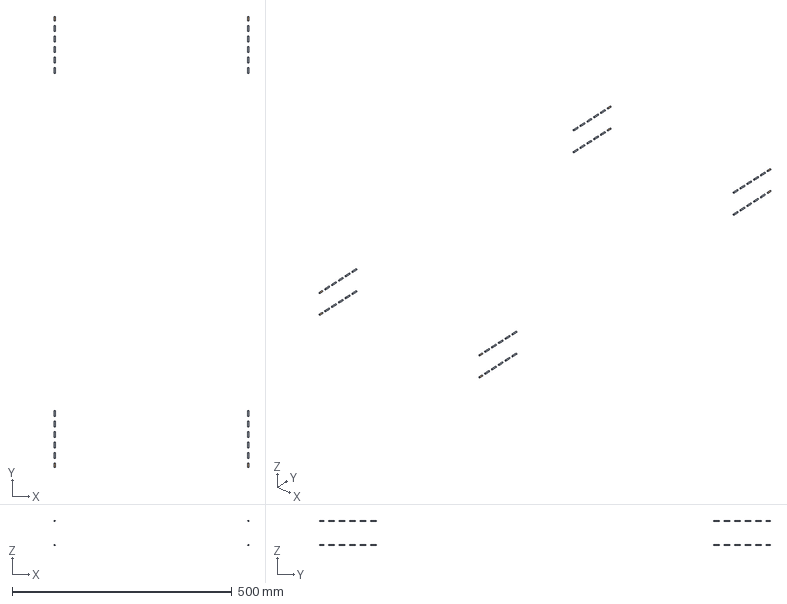
[picture p147: CAD file, 2026-11-10]
golf_project/golf_out/v0112_ext/parts/av_assembly_lines.step
444.0 x 1027.0 x 58.0 mm
