tom-ainc/kitchen_bench_extension/golf_project/golf_out/v0143_ext/parts/assembly.step

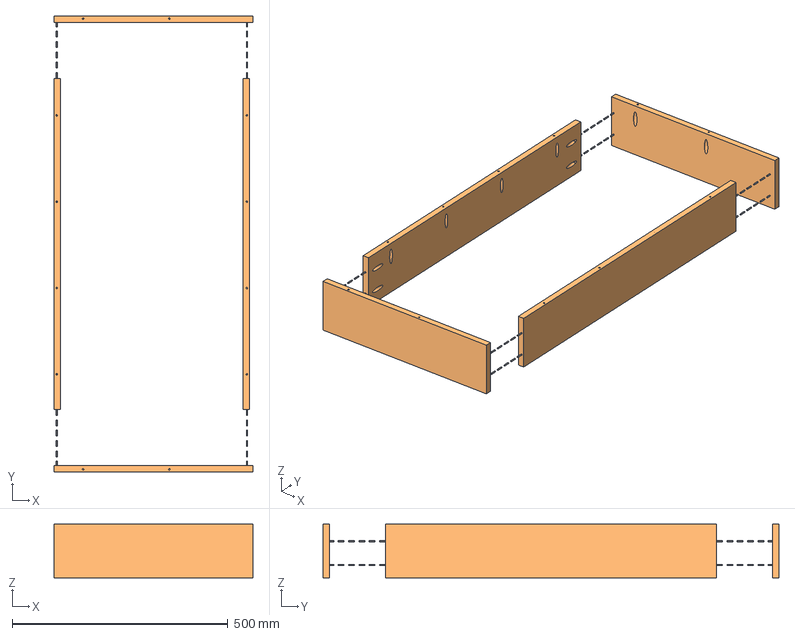
[picture p149: CAD file, 2026-11-10]
golf_project/golf_out/v0143_ext/parts/assembly.step
461.0 x 1057.0 x 125.0 mm
av_assembly_lines
P1_front_rail
P3_side_rail_free_end
P4_side_rail_joint_end
P2_rear_rail
