tom-ainc/kitchen_bench_extension/golf_project/golf_projects/kitchen_bench_extension-1/golf_out/v0007_fronts_140_140_444_final/parts/assembly.step

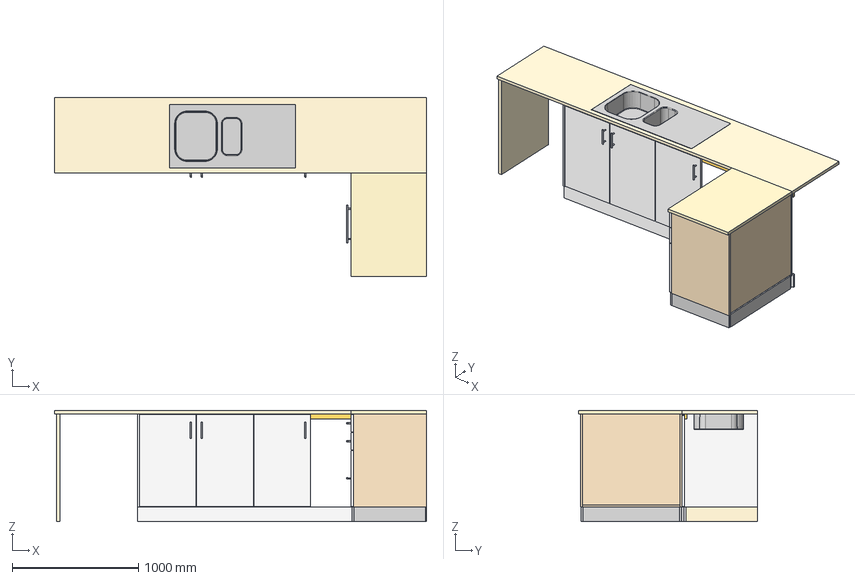
[picture p150: CAD file, 2026-11-10]
golf_project/golf_projects/kitchen_bench_extension-1/golf_out/v0007_fronts_140_140_444_final/parts/assembly.step
2950.0 x 1420.0 x 881.6 mm
side_free_end
carcass_bottom
carcass_back
stretcher_front
stretcher_rear
side_joint_end
drawer1_front
drawer1_side_L
drawer1_side_R
drawer1_back
drawer1_bottom
drawer1_handle
drawer1_pocket_screws
drawer2_front
drawer2_side_L
drawer2_side_R
drawer2_back
drawer2_bottom
drawer2_handle
drawer2_pocket_screws
drawer3_front
drawer3_side_L
drawer3_side_R
drawer3_back
drawer3_bottom
drawer3_handle
drawer3_pocket_screws
benchtop_screws
link_bolts_to_main_run
drawer1_runner_L
drawer1_runner_R
drawer2_runner_L
drawer2_runner_R
drawer3_runner_L
drawer3_runner_R
KickboardExt
plinth_return_free_end
plinth_rail_joint_end
plinth_rail_rear
ref_benchtop
ref_Kickboard
ref_framing
ref_BenchtopExt
ref_sink
ref_door-left
ref_left_support
ref_handle-grip
ref_handle-standoff
ref_handle-standoff_2
ref_door-left_2
ref_side
ref_handle-grip_2
ref_handle-standoff_3
ref_handle-standoff_4
ref_handle-grip_3
ref_handle-standoff_5
ref_handle-standoff_6
ref_door-right
