tom-ainc/kitchen_bench_extension/golf_project/golf_out/v0042_ext/parts/assembly.step

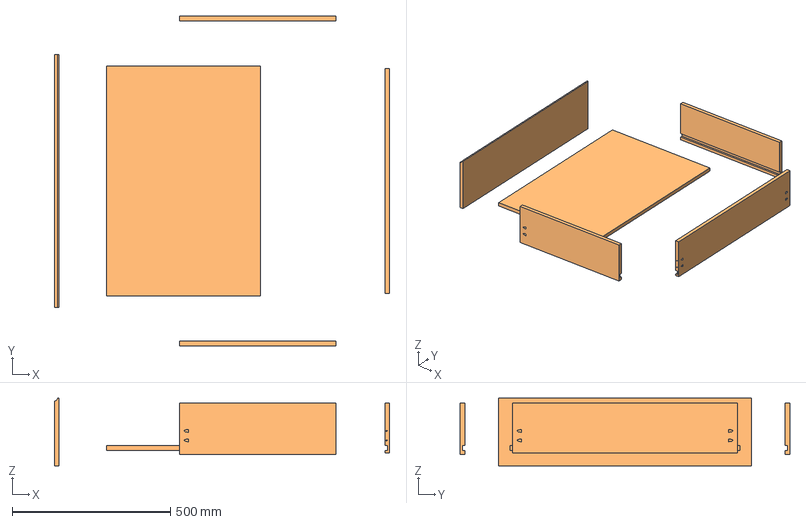
[picture p152: CAD file, 2026-11-10]
golf_project/golf_out/v0042_ext/parts/assembly.step
1060.0 x 1043.0 x 215.0 mm
drawer1_front
drawer1_side_L
drawer1_side_R
drawer1_back
drawer1_bottom
