tom-ainc/kitchen_bench_extension/golf_project/golf_projects/kitchen_bench_extension-1/golf_out/v0003_carcass_plinth/parts/assembly.step

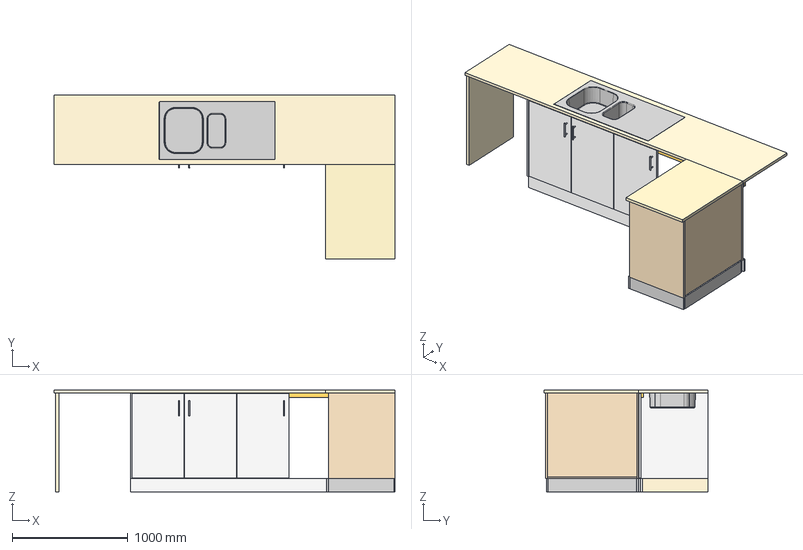
[picture p155: CAD file, 2026-11-10]
golf_project/golf_projects/kitchen_bench_extension-1/golf_out/v0003_carcass_plinth/parts/assembly.step
2950.0 x 1420.0 x 881.6 mm
side_free_end
side_joint_end
carcass_bottom
carcass_back
stretcher_front
stretcher_rear
KickboardExt
plinth_return_free_end
plinth_rail_joint_end
plinth_rail_rear
ref_benchtop
ref_Kickboard
ref_framing
ref_sink
ref_door-left
ref_left_support
ref_handle-grip
ref_handle-standoff
ref_handle-standoff_2
ref_door-left_2
ref_BenchtopExt
ref_side
ref_handle-grip_2
ref_handle-standoff_3
ref_handle-standoff_4
ref_handle-grip_3
ref_handle-standoff_5
ref_handle-standoff_6
ref_door-right
