tom-ainc/kitchen_bench_extension/golf_project/golf_projects/kitchen_bench_extension-1/golf_out/v0009_step1_plinth/parts/assembly.step

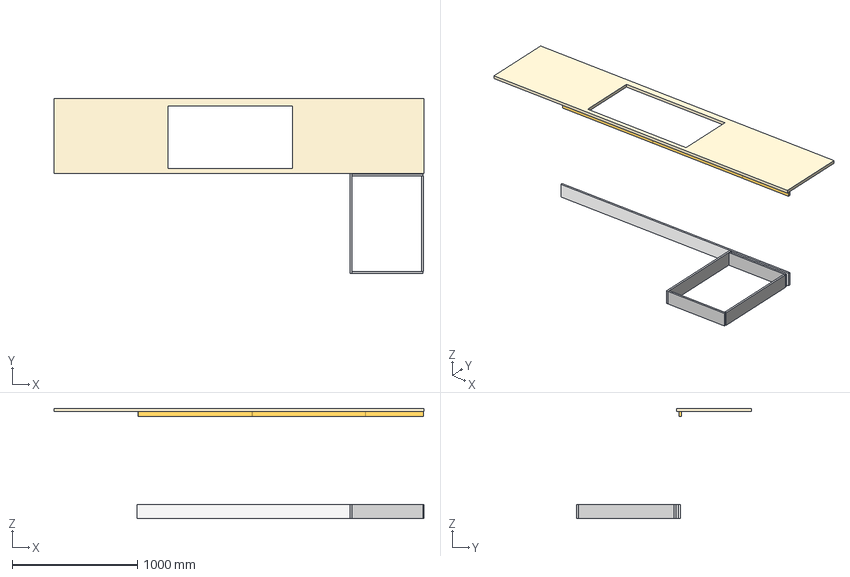
[picture p156: CAD file, 2026-11-10]
golf_project/golf_projects/kitchen_bench_extension-1/golf_out/v0009_step1_plinth/parts/assembly.step
2950.0 x 1399.0 x 880.0 mm
KickboardExt
plinth_return_free_end
plinth_rail_joint_end
plinth_rail_rear
ref_benchtop
ref_Kickboard
ref_framing
