tom-ainc/kitchen_bench_extension/golf_project/golf_projects/kitchen_bench_extension-1/golf_out/v0014_step5_base_slides_in/parts/assembly.step

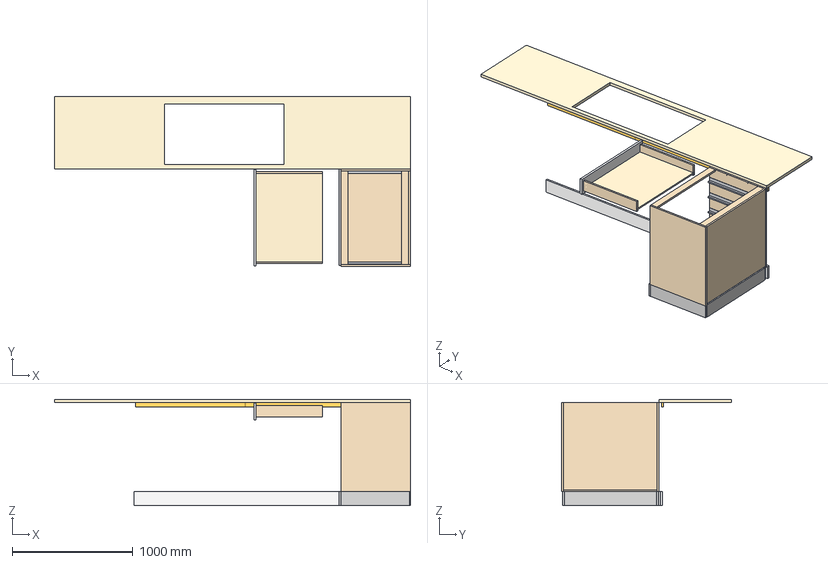
[picture p157: CAD file, 2026-11-10]
golf_project/golf_projects/kitchen_bench_extension-1/golf_out/v0014_step5_base_slides_in/parts/assembly.step
2950.0 x 1405.0 x 880.0 mm
side_free_end
carcass_bottom
carcass_back
stretcher_front
stretcher_rear
side_joint_end
drawer1_front
drawer1_side_L
drawer1_side_R
drawer1_bottom
drawer1_runner_L
drawer1_runner_R
drawer2_runner_L
drawer2_runner_R
drawer3_runner_L
drawer3_runner_R
drawer4_runner_L
drawer4_runner_R
KickboardExt
plinth_return_free_end
plinth_rail_joint_end
plinth_rail_rear
ref_benchtop
ref_Kickboard
ref_framing
