tom-ainc/kitchen_bench_extension/golf_project/golf_out/v0001_import_drawbars_clip/parts/assembly.step

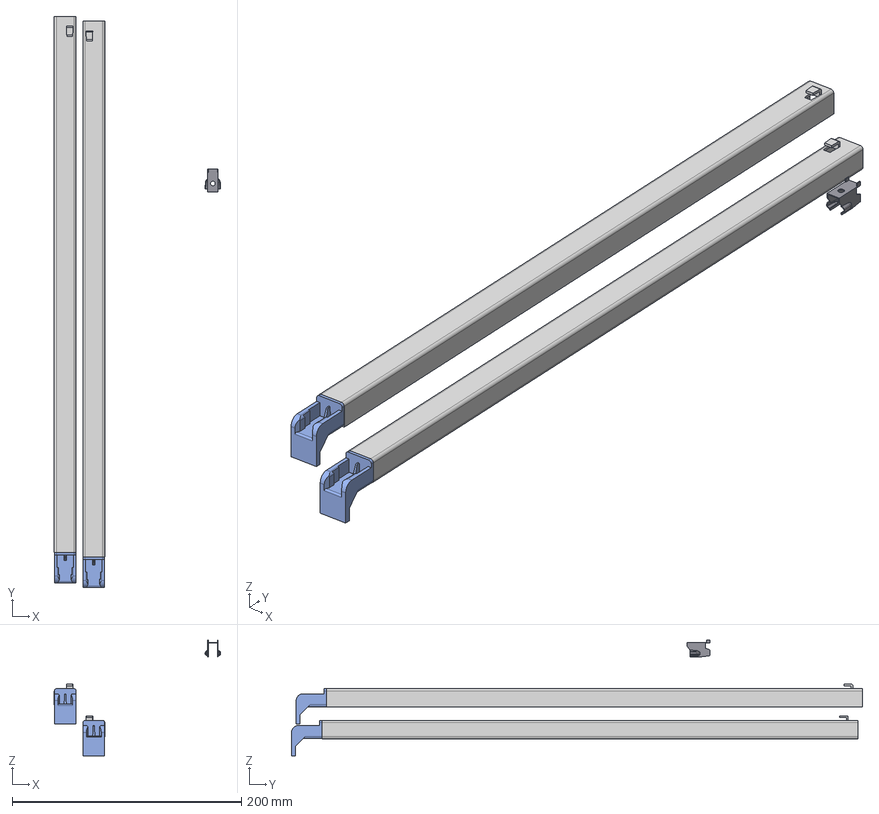
[picture p158: CAD file, 2026-11-10]
golf_project/golf_out/v0001_import_drawbars_clip/parts/assembly.step
145.4 x 498.5 x 101.1 mm
L0
L1
R0
R1
C0
