tom-ainc/kitchen_bench_extension/golf_project/golf_out/v0004_pose_clip_on_bracket/parts/assembly.step

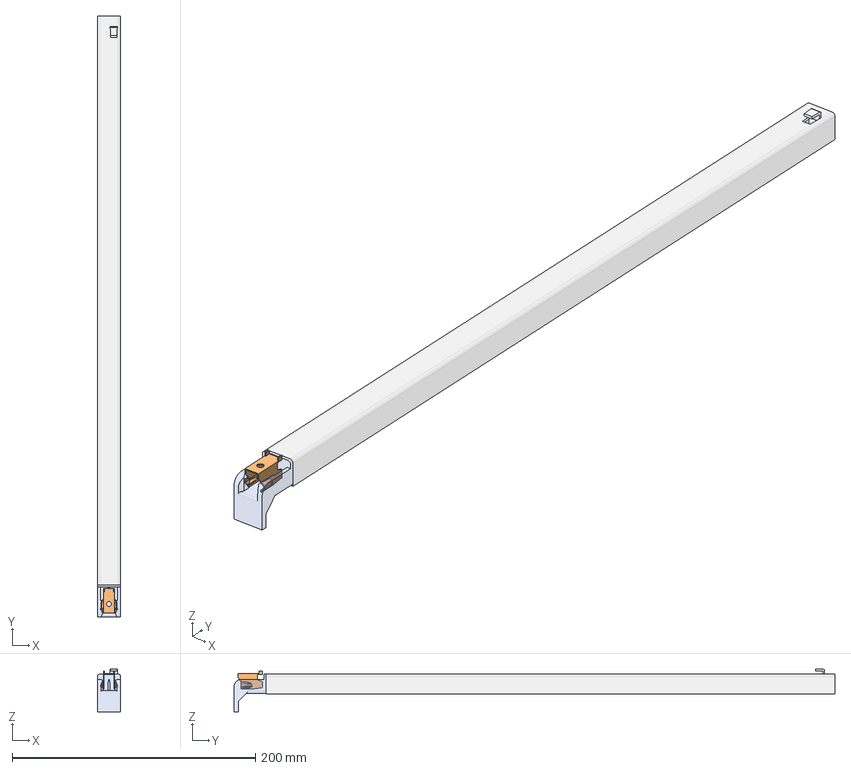
[picture p159: CAD file, 2026-11-10]
golf_project/golf_out/v0004_pose_clip_on_bracket/parts/assembly.step
19.2 x 494.5 x 35.0 mm
bracket
drawbar
clip
