tom-ainc/kitchen_bench_extension/golf_project/golf_out/v0005_option1_clip/parts/assembly.step

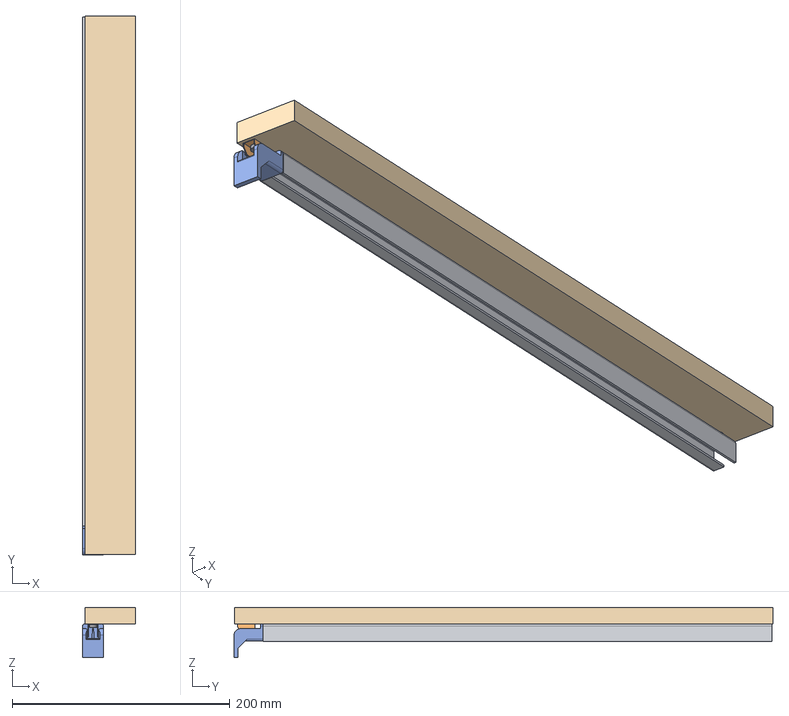
[picture p160: CAD file, 2026-11-10]
golf_project/golf_out/v0005_option1_clip/parts/assembly.step
48.5 x 495.5 x 46.0 mm
base_15mm_ply
drawbar_L
front_bracket_L
screw_1
snap_clip
