tom-ainc/kitchen_bench_extension/golf_project/golf_out/v0084_av1/parts/av_assembly_lines.step

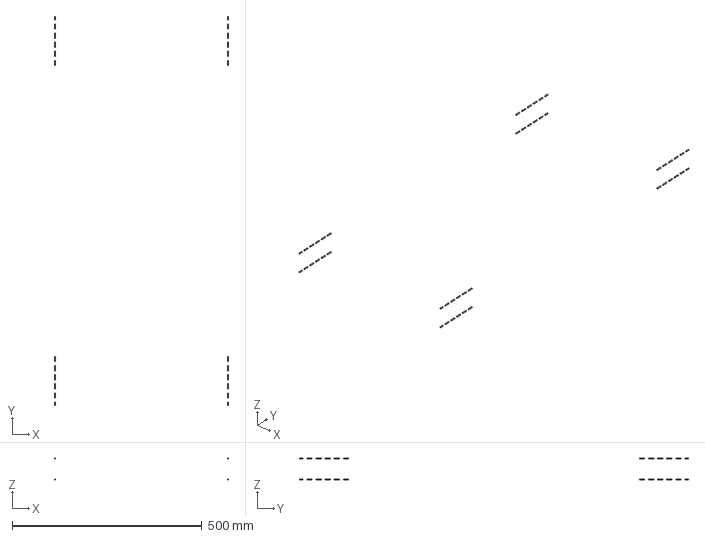
[picture p161: CAD file, 2026-11-10]
golf_project/golf_out/v0084_av1/parts/av_assembly_lines.step
459.0 x 1027.0 x 58.0 mm
