tom-ainc/kitchen_bench_extension/golf_project/golf_out/v0086_av3/parts/av_assembly_lines.step

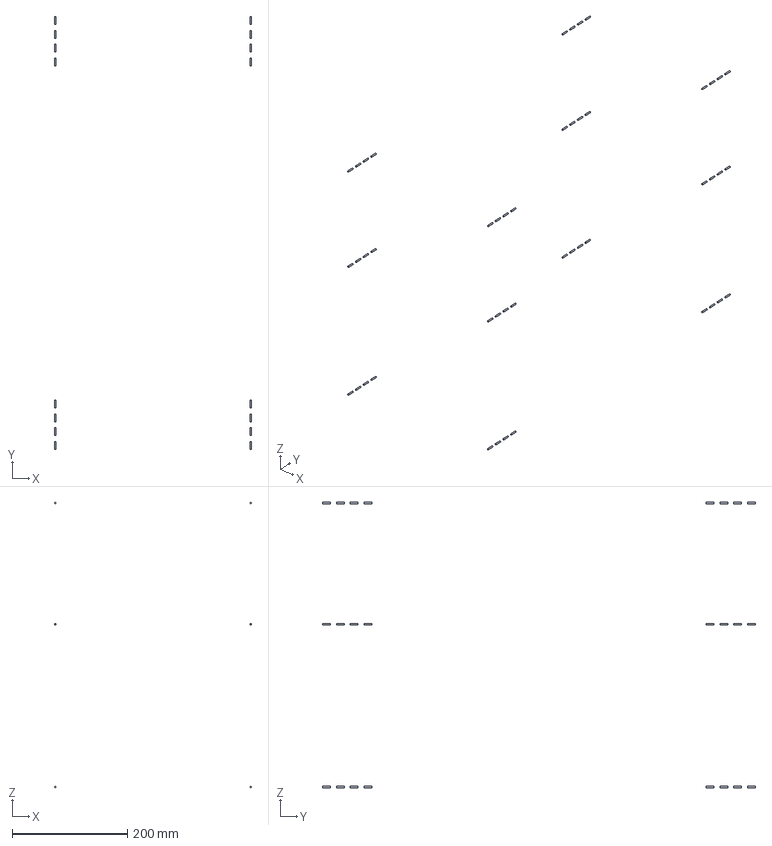
[picture p162: CAD file, 2026-11-10]
golf_project/golf_out/v0086_av3/parts/av_assembly_lines.step
343.0 x 753.0 x 497.0 mm
