tom-ainc/kitchen_bench_extension/golf_project/golf_out/v0144_ext/parts/av_assembly_lines.step

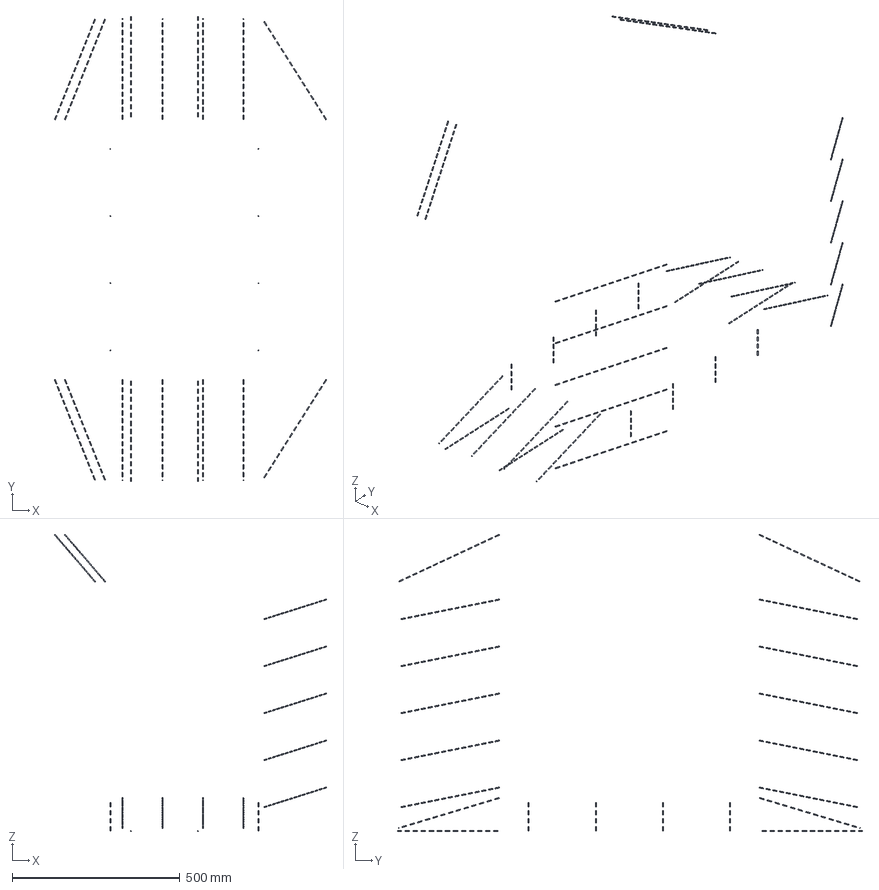
[picture p166: CAD file, 2026-11-10]
golf_project/golf_out/v0144_ext/parts/av_assembly_lines.step
810.7 x 1385.0 x 885.9 mm
