tom-ainc/kitchen_bench_extension/golf_project/golf_out/v0147_ext/parts/assembly.step

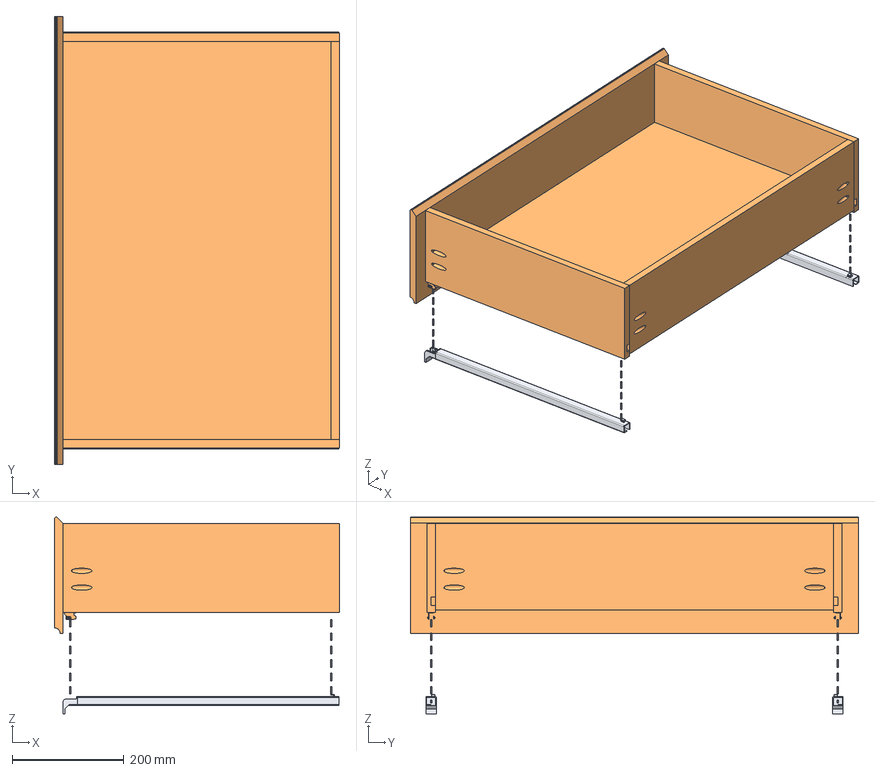
[picture p168: CAD file, 2026-11-10]
golf_project/golf_out/v0147_ext/parts/assembly.step
510.0 x 802.0 x 352.0 mm
drawer1_front
drawer1_side_L
drawer1_side_R
drawer1_back
drawer1_bottom
av_assembly_lines
drawer1_snap_clip_L
drawer1_drawbar_L
drawer1_drawbar_bracket_L
drawer1_snap_clip_R
drawer1_drawbar_R
drawer1_drawbar_bracket_R
