tom-ainc/kitchen_bench_extension/golf_project/golf_out/v0131_av8/parts/av_assembly_lines.step

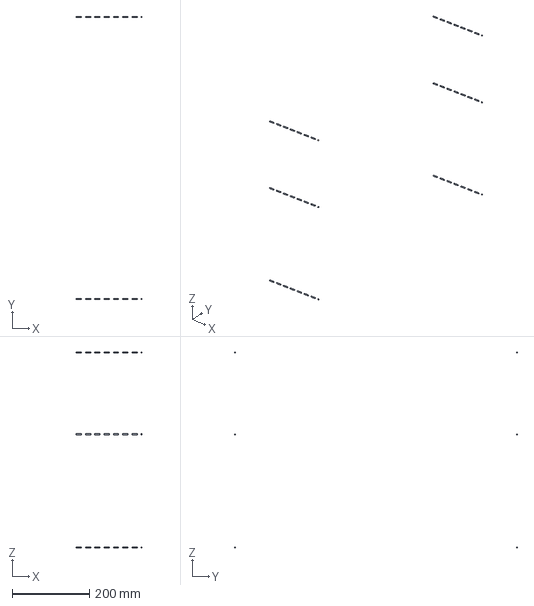
[picture p170: CAD file, 2026-11-10]
golf_project/golf_out/v0131_av8/parts/av_assembly_lines.step
170.0 x 730.8 x 506.0 mm
