tom-ainc/kitchen_bench_extension/golf_project/golf_out/v0146_ext/parts/av_assembly_lines.step

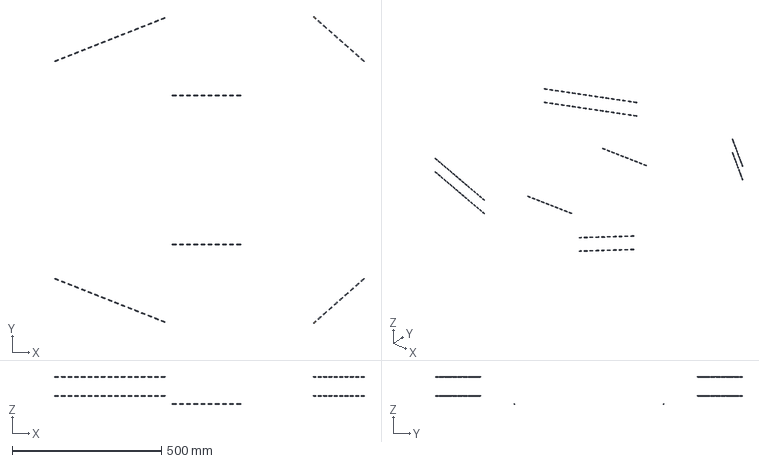
[picture p171: CAD file, 2026-11-10]
golf_project/golf_out/v0146_ext/parts/av_assembly_lines.step
1039.0 x 1030.2 x 94.5 mm
