tom-ainc/kitchen_bench_extension/golf_project/golf_out/v0039_av_step2_carcass/parts/assembly.step

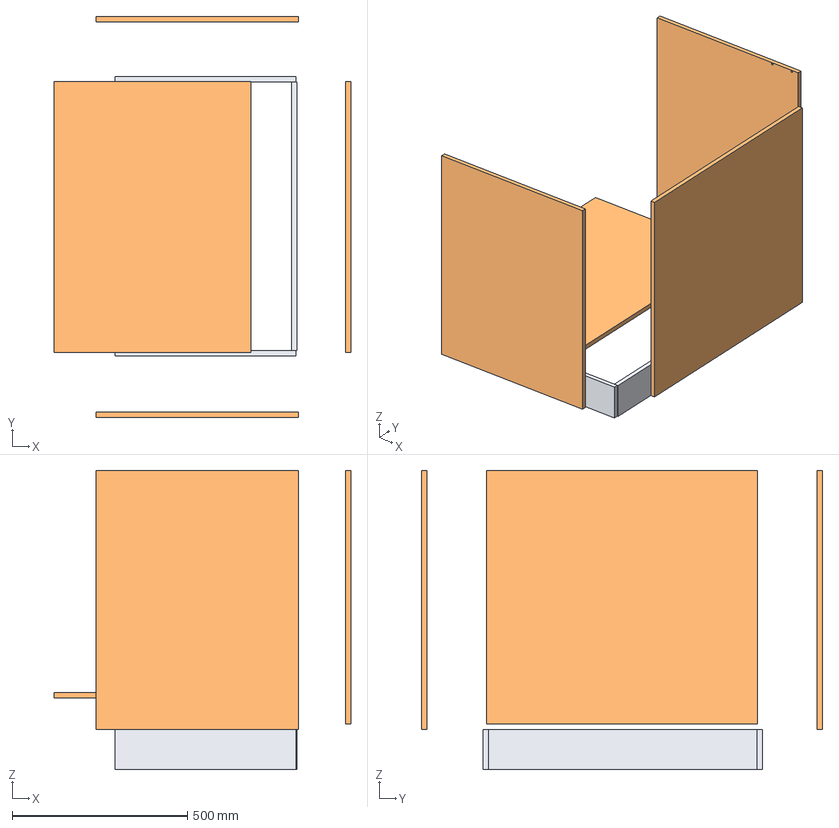
[picture p172: CAD file, 2026-11-10]
golf_project/golf_out/v0039_av_step2_carcass/parts/assembly.step
847.0 x 1145.0 x 855.0 mm
side_free_end
carcass_bottom
carcass_back
side_joint_end
plinth_rail_front
plinth_return_free_end
plinth_rail_joint_end
plinth_rail_rear
