tom-ainc/kitchen_bench_extension/golf_project/golf_out/v0059_ext/parts/assembly.step

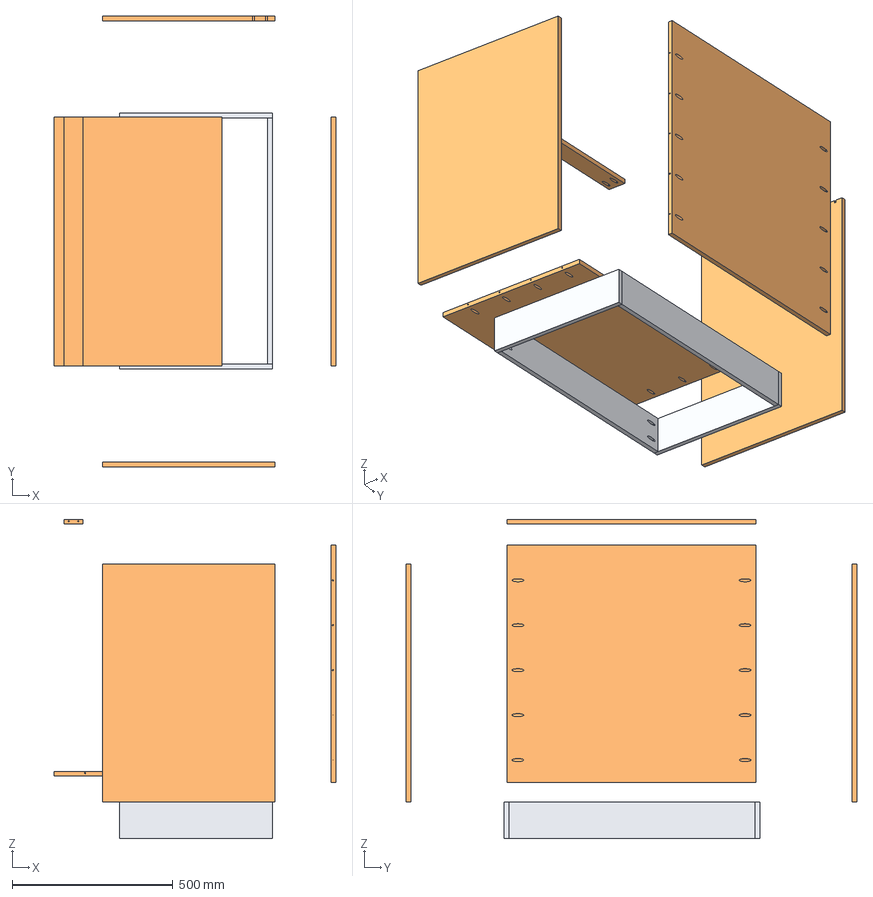
[picture p173: CAD file, 2026-11-10]
golf_project/golf_out/v0059_ext/parts/assembly.step
877.0 x 1405.0 x 995.0 mm
side_free_end
carcass_bottom
carcass_back
top_rail_front
side_joint_end
plinth_rail_front
plinth_return_free_end
plinth_rail_joint_end
plinth_rail_rear
