tom-ainc/kitchen_bench_extension/golf_project/golf_out/v0124_ext/parts/av_assembly_lines.step

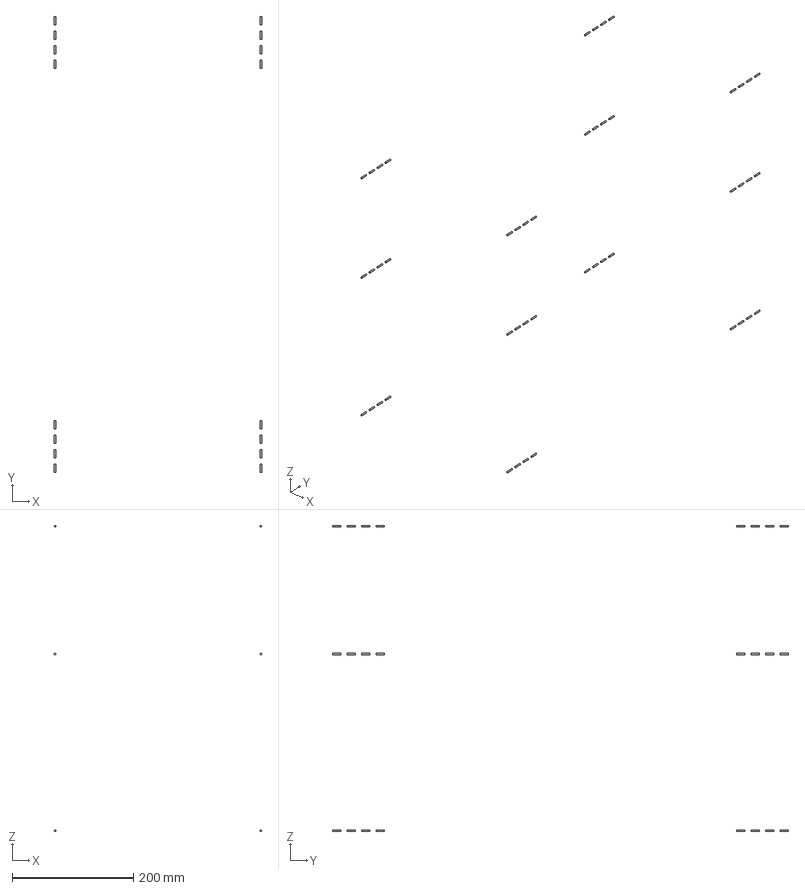
[picture p174: CAD file, 2026-11-10]
golf_project/golf_out/v0124_ext/parts/av_assembly_lines.step
343.0 x 753.0 x 506.0 mm
