tom-ainc/kitchen_bench_extension/golf_project/golf_out/v0148_ext/parts/av_assembly_lines.step

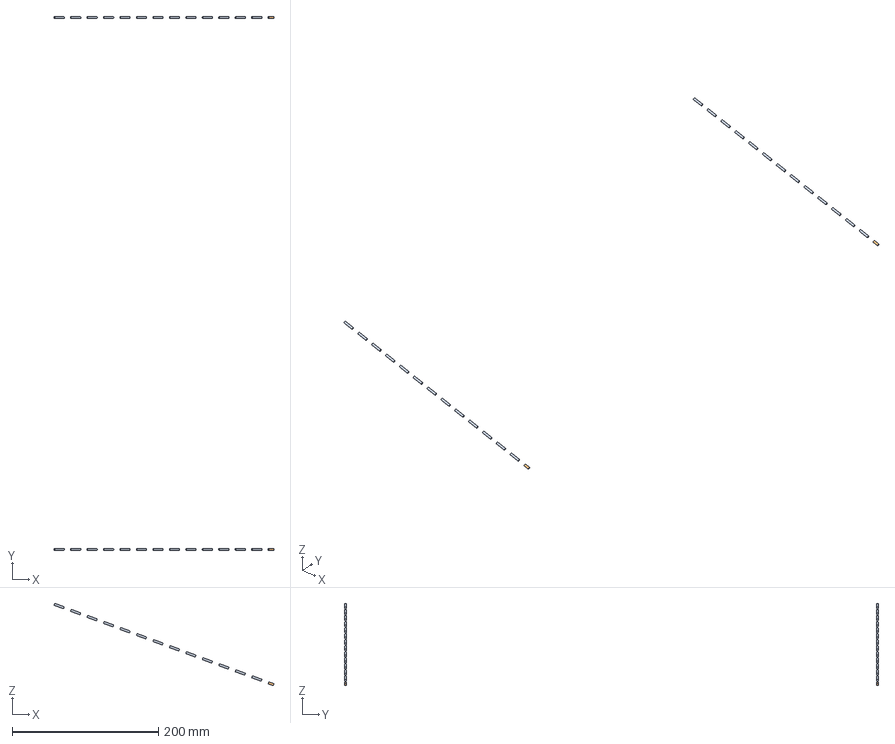
[picture p175: CAD file, 2026-11-10]
golf_project/golf_out/v0148_ext/parts/av_assembly_lines.step
301.0 x 730.8 x 112.8 mm
