tom-ainc/kitchen_bench_extension/golf_project/golf_out/v0088_av5/parts/av_assembly_lines.step

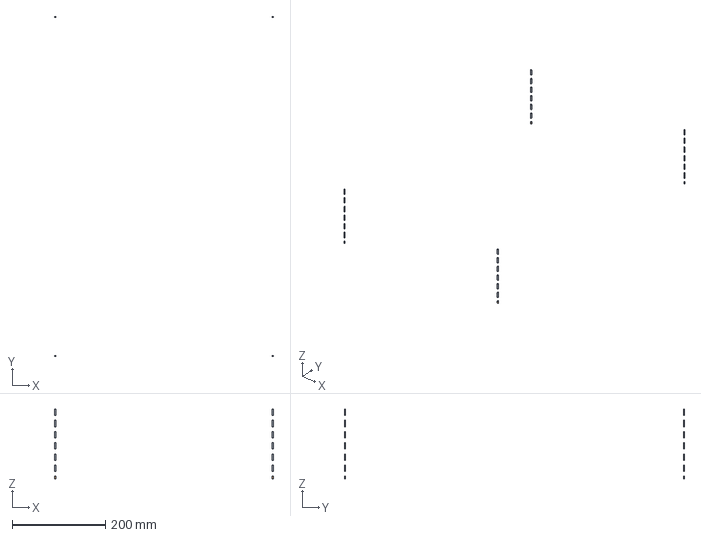
[picture p176: CAD file, 2026-11-10]
golf_project/golf_out/v0088_av5/parts/av_assembly_lines.step
470.1 x 730.8 x 150.0 mm
