tom-ainc/kitchen_bench_extension/golf_project/golf_out/v0152_ext/parts/av_assembly_lines.step

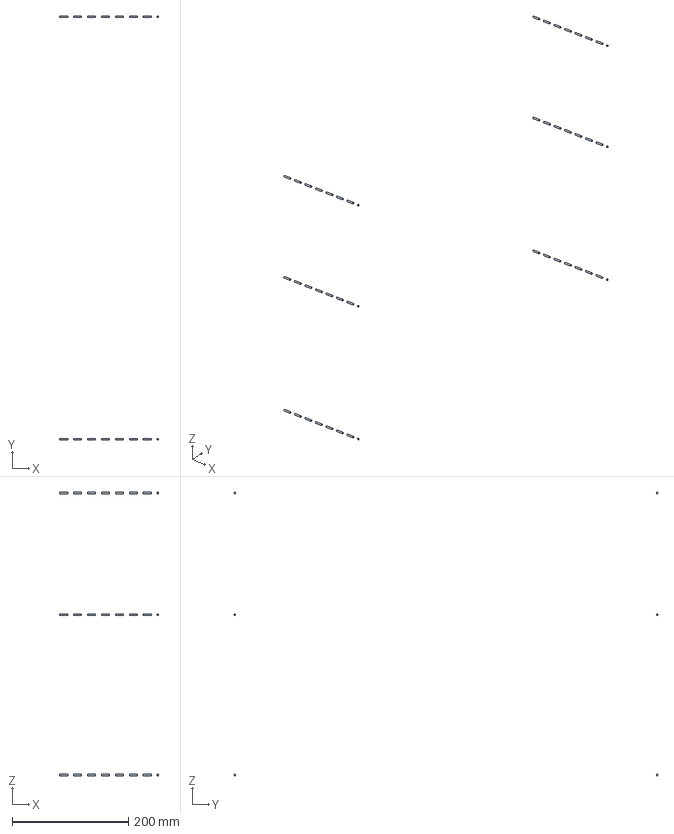
[picture p177: CAD file, 2026-11-10]
golf_project/golf_out/v0152_ext/parts/av_assembly_lines.step
170.0 x 730.8 x 489.0 mm
