tom-ainc/kitchen_bench_extension/golf_project/golf_out/v0040_av_step2b_carcass/parts/assembly.step

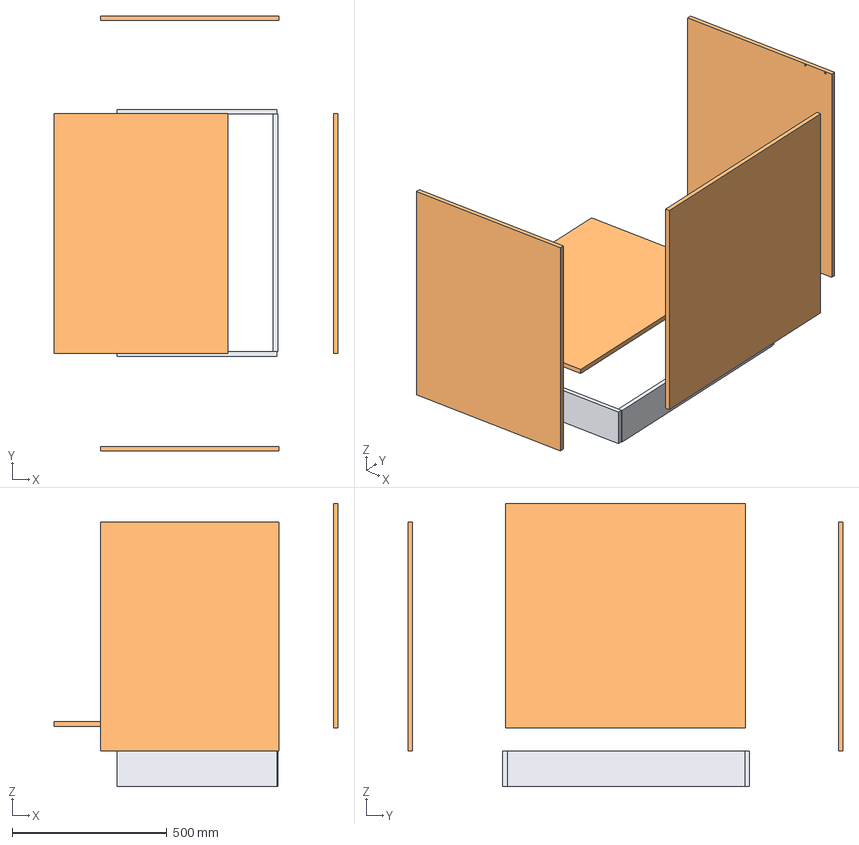
[picture p178: CAD file, 2026-11-10]
golf_project/golf_out/v0040_av_step2b_carcass/parts/assembly.step
917.0 x 1405.0 x 915.0 mm
side_free_end
carcass_bottom
carcass_back
side_joint_end
plinth_rail_front
plinth_return_free_end
plinth_rail_joint_end
plinth_rail_rear
