tom-ainc/kitchen_bench_extension/golf_project/golf_out/v0153_ext/parts/av_assembly_lines.step

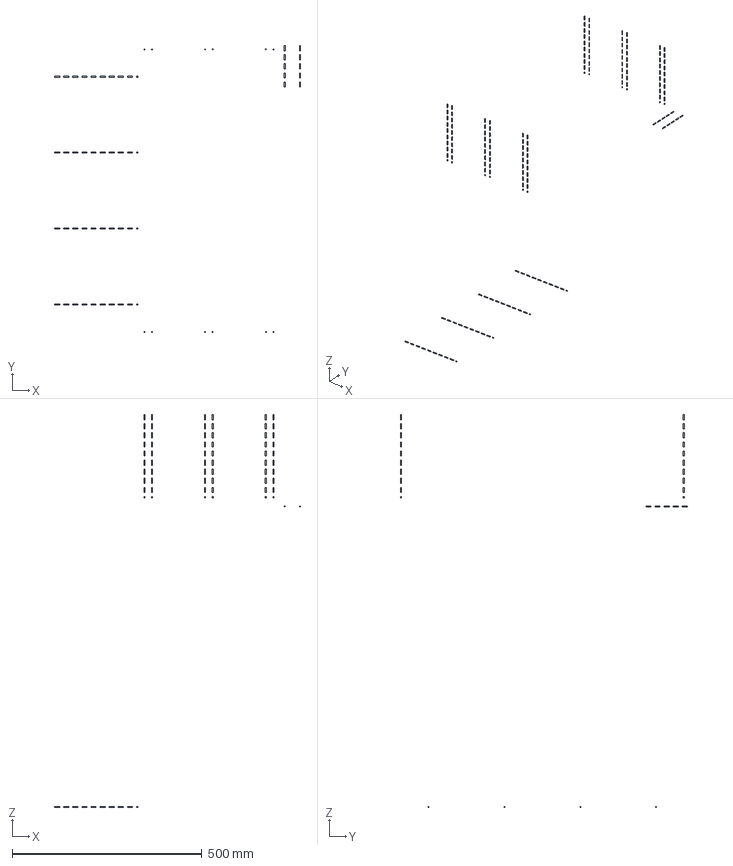
[picture p182: CAD file, 2026-11-10]
golf_project/golf_out/v0153_ext/parts/av_assembly_lines.step
648.6 x 756.5 x 1036.0 mm
