tom-ainc/kitchen_bench_extension/golf_project/golf_out/v0093_ext/parts/av_assembly_lines.step

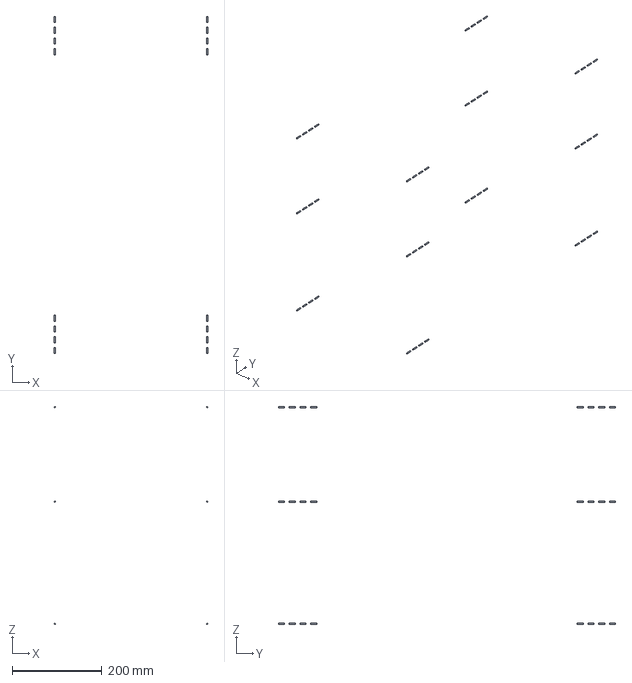
[picture p185: CAD file, 2026-11-10]
golf_project/golf_out/v0093_ext/parts/av_assembly_lines.step
343.0 x 753.0 x 487.0 mm
