tom-ainc/kitchen_bench_extension/golf_project/golf_out/v0101_ext/parts/av_assembly_lines.step

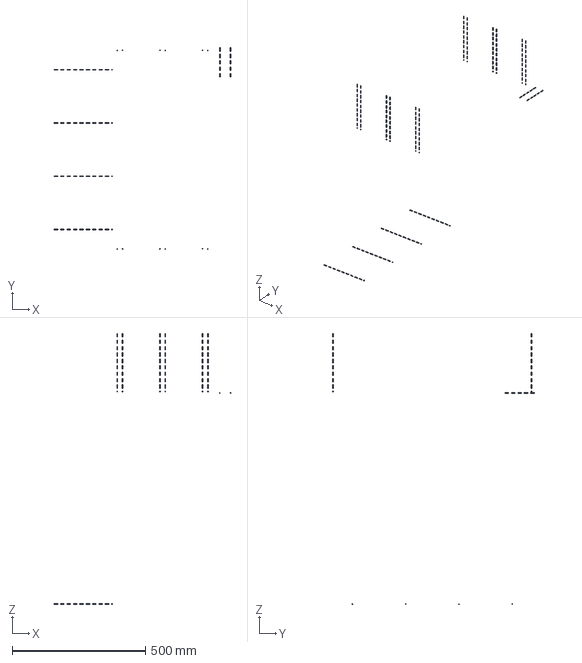
[picture p187: CAD file, 2026-11-10]
golf_project/golf_out/v0101_ext/parts/av_assembly_lines.step
663.6 x 756.5 x 1017.0 mm
