tom-ainc/kitchen_bench_extension/golf_project/golf_projects/kitchen_bench_extension-1/golf_out/v0018_step9_benchtop_on/parts/assembly.step

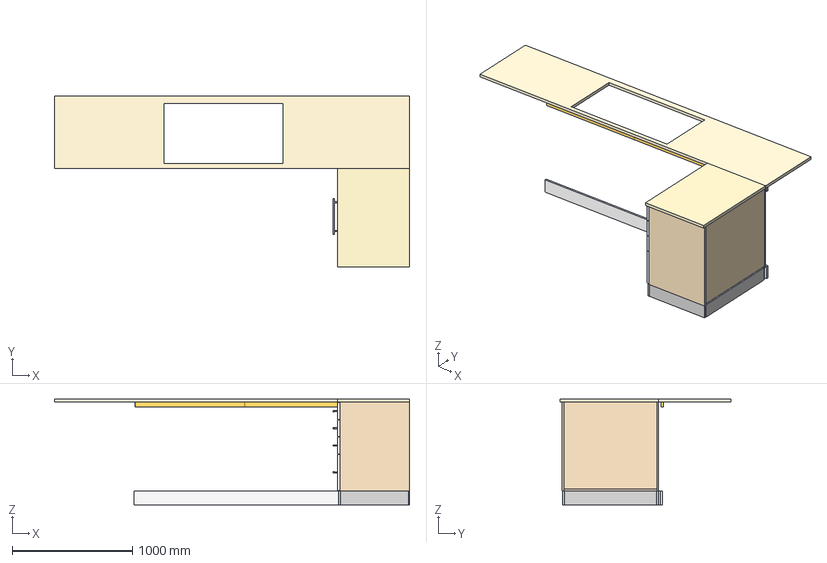
[picture p188: CAD file, 2026-11-10]
golf_project/golf_projects/kitchen_bench_extension-1/golf_out/v0018_step9_benchtop_on/parts/assembly.step
2950.0 x 1420.0 x 880.0 mm
side_free_end
carcass_bottom
carcass_back
stretcher_front
stretcher_rear
side_joint_end
drawer1_front
drawer1_side_L
drawer1_side_R
drawer1_back
drawer1_bottom
drawer1_handle
drawer1_pocket_screws
drawer2_front
drawer2_side_L
drawer2_side_R
drawer2_back
drawer2_bottom
drawer2_handle
drawer2_pocket_screws
drawer3_front
drawer3_side_L
drawer3_side_R
drawer3_back
drawer3_bottom
drawer3_handle
drawer3_pocket_screws
drawer4_front
drawer4_side_L
drawer4_side_R
drawer4_back
drawer4_bottom
drawer4_handle
drawer4_pocket_screws
benchtop_screws
drawer1_runner_L
drawer1_runner_R
drawer2_runner_L
drawer2_runner_R
drawer3_runner_L
drawer3_runner_R
drawer4_runner_L
drawer4_runner_R
KickboardExt
plinth_return_free_end
plinth_rail_joint_end
plinth_rail_rear
ref_benchtop
ref_Kickboard
ref_framing
ref_BenchtopExt
