tom-ainc/kitchen_bench_extension/golf_project/golf_out/v0001_import_drawbars_clip/parts/C0.step

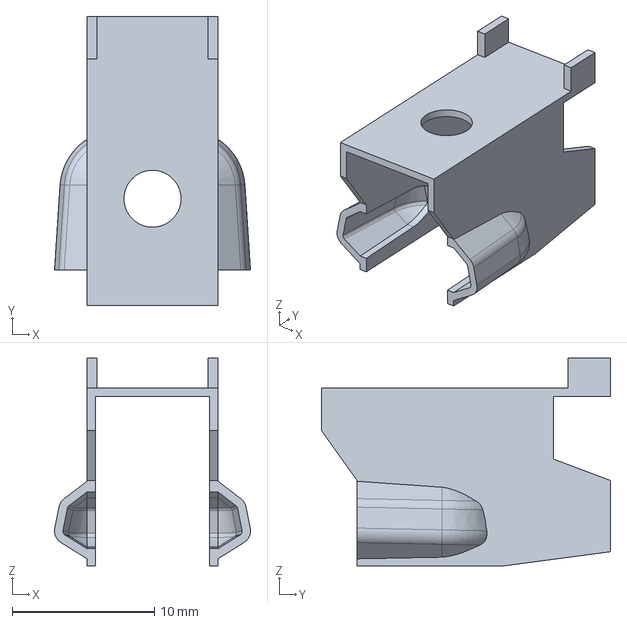
[picture p189: CAD file, 2026-11-10]
golf_project/golf_out/v0001_import_drawbars_clip/parts/C0.step
13.8 x 20.3 x 14.6 mm
