tom-ainc/kitchen_bench_extension/golf_project/golf_out/v0006_option1_clip_hole11/parts/front_bracket_L.step

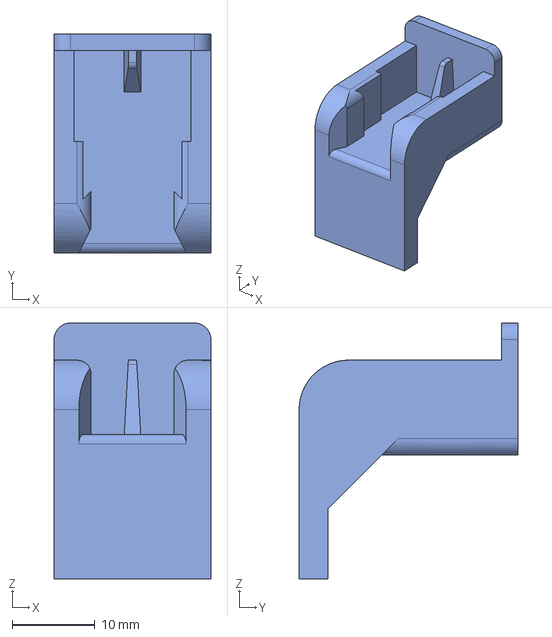
[picture p190: CAD file, 2026-11-10]
golf_project/golf_out/v0006_option1_clip_hole11/parts/front_bracket_L.step
19.0 x 26.5 x 31.0 mm
