tom-ainc/kitchen_bench_extension/golf_project/golf_out/v0010_drawbar_boxes_opt1/parts/bin_drawer_tipon_envelope.step

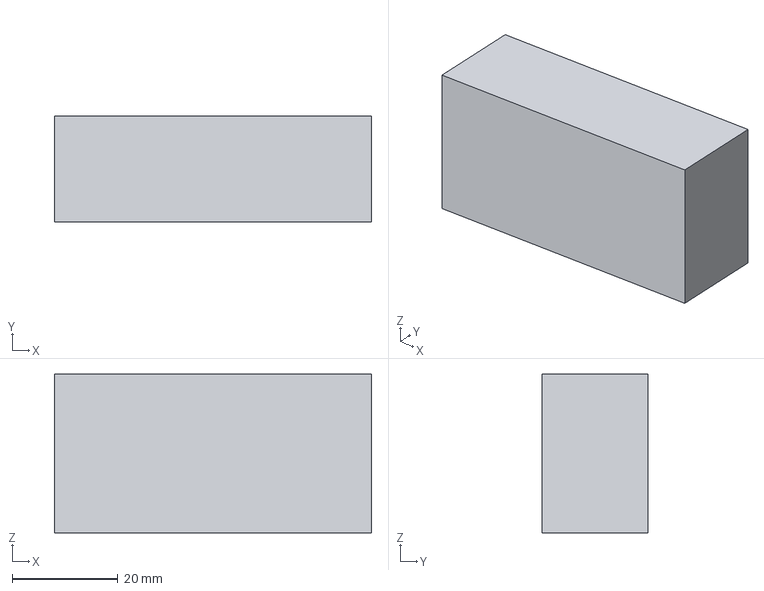
[picture p191: CAD file, 2026-11-10]
golf_project/golf_out/v0010_drawbar_boxes_opt1/parts/bin_drawer_tipon_envelope.step
60.0 x 20.0 x 30.0 mm
