tom-ainc/kitchen_bench_extension/golf_project/golf_out/v0011_drawbar_boxes_opt1_notch/parts/drawer1_handle.step

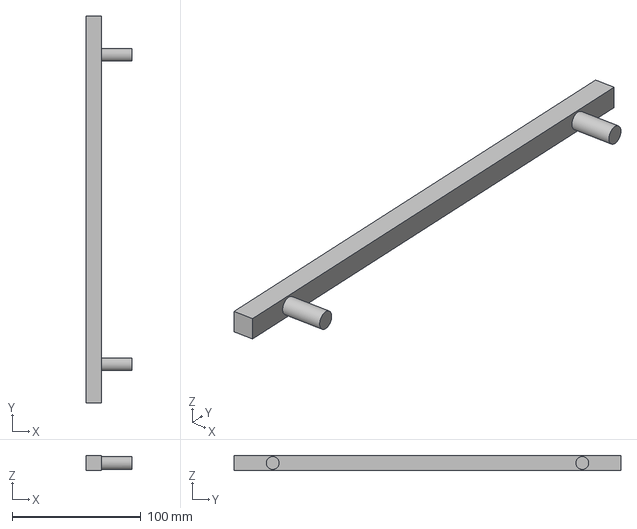
[picture p192: CAD file, 2026-11-10]
golf_project/golf_out/v0011_drawbar_boxes_opt1_notch/parts/drawer1_handle.step
36.0 x 300.0 x 12.0 mm
