tom-ainc/kitchen_bench_extension/golf_project/golf_out/v0012_drawbar_boxes_opt2_invalid/parts/drawer2_runner_L.step

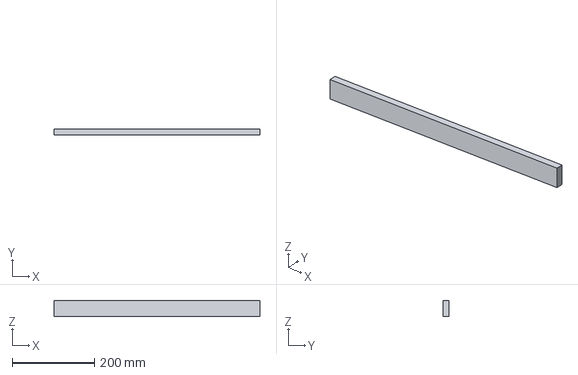
[picture p193: CAD file, 2026-11-10]
golf_project/golf_out/v0012_drawbar_boxes_opt2_invalid/parts/drawer2_runner_L.step
500.0 x 14.0 x 39.0 mm
