tom-ainc/kitchen_bench_extension/golf_project/golf_out/v0014_three_drawers_clip/parts/drawer2_front.step

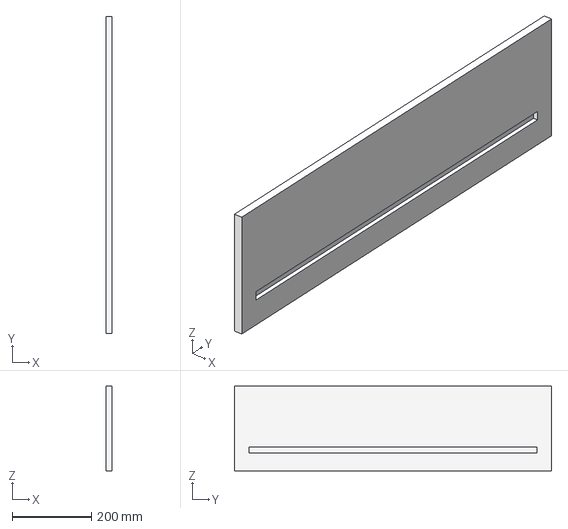
[picture p194: CAD file, 2026-11-10]
golf_project/golf_out/v0014_three_drawers_clip/parts/drawer2_front.step
15.0 x 802.0 x 215.0 mm
