tom-ainc/kitchen_bench_extension/golf_project/golf_out/v0016_pack_base_clip/parts/drawer3_side_R.step

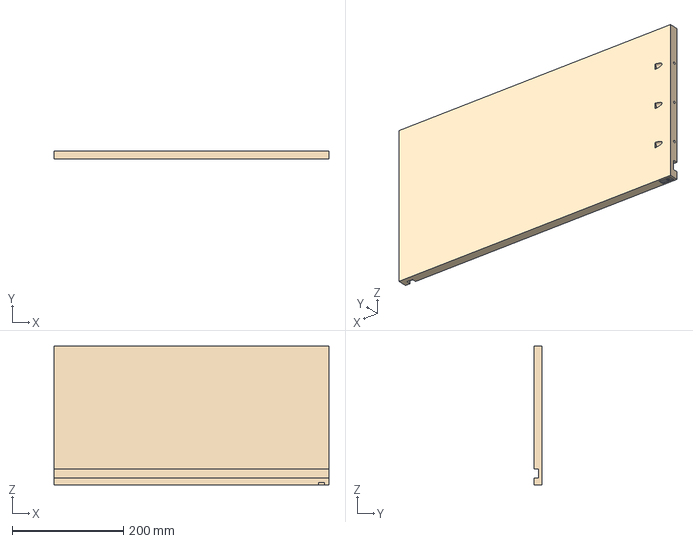
[picture p195: CAD file, 2026-11-10]
golf_project/golf_out/v0016_pack_base_clip/parts/drawer3_side_R.step
495.0 x 15.0 x 250.0 mm
