tom-ainc/kitchen_bench_extension/golf_project/golf_out/v0019_pack_full_clip/parts/ref_Kickboard.step

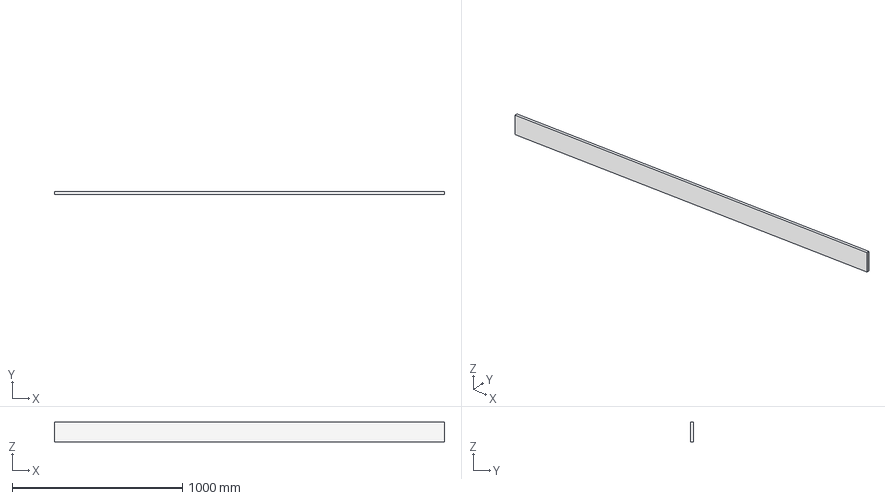
[picture p196: CAD file, 2026-11-10]
golf_project/golf_out/v0019_pack_full_clip/parts/ref_Kickboard.step
2290.0 x 16.0 x 115.0 mm
