tom-ainc/kitchen_bench_extension/golf_project/golf_out/v0022_pack_base_clip_v2/parts/plinth_rail_joint_end.step

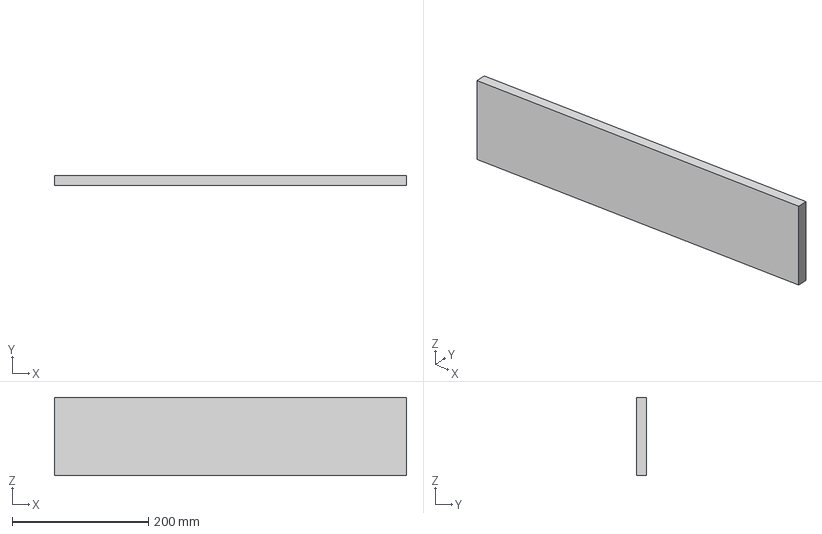
[picture p197: CAD file, 2026-11-10]
golf_project/golf_out/v0022_pack_base_clip_v2/parts/plinth_rail_joint_end.step
516.0 x 15.0 x 115.0 mm
