tom-ainc/kitchen_bench_extension/golf_project/golf_out/v0023_cove_pull_r9_5/parts/drawer1_side_R.step

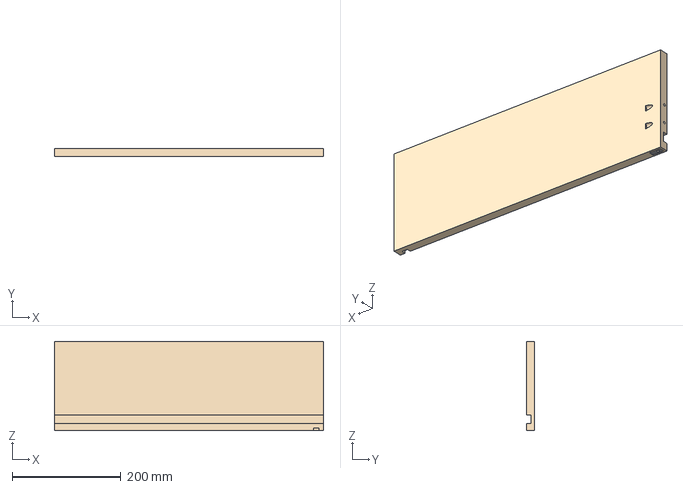
[picture p198: CAD file, 2026-11-10]
golf_project/golf_out/v0023_cove_pull_r9_5/parts/drawer1_side_R.step
495.0 x 15.0 x 164.0 mm
