tom-ainc/kitchen_bench_extension/golf_project/golf_out/v0024_pull_back_cove/parts/drawer3_runner_R.step

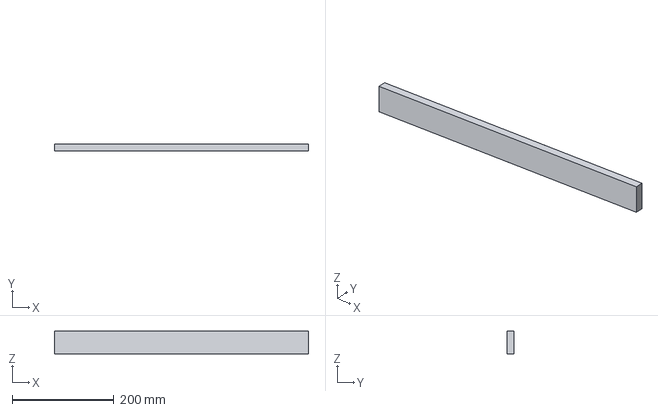
[picture p199: CAD file, 2026-11-10]
golf_project/golf_out/v0024_pull_back_cove/parts/drawer3_runner_R.step
500.0 x 14.0 x 45.0 mm
