tom-ainc/kitchen_bench_extension/golf_project/golf_out/v0025_pull_slot/parts/drawer1_front.step

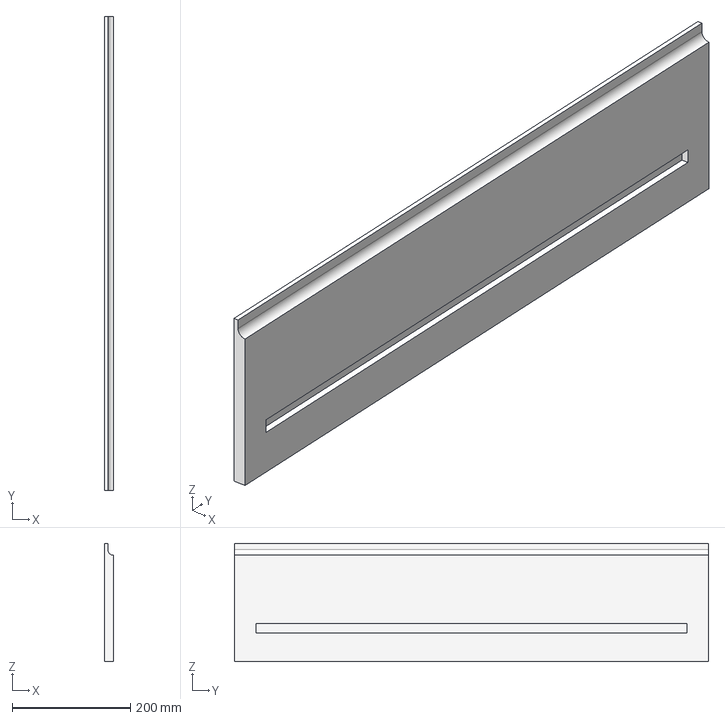
[picture p200: CAD file, 2026-11-10]
golf_project/golf_out/v0025_pull_slot/parts/drawer1_front.step
15.0 x 802.0 x 200.0 mm
