tom-ainc/kitchen_bench_extension/golf_project/golf_out/v0028_pull_groove/parts/bin_1.step

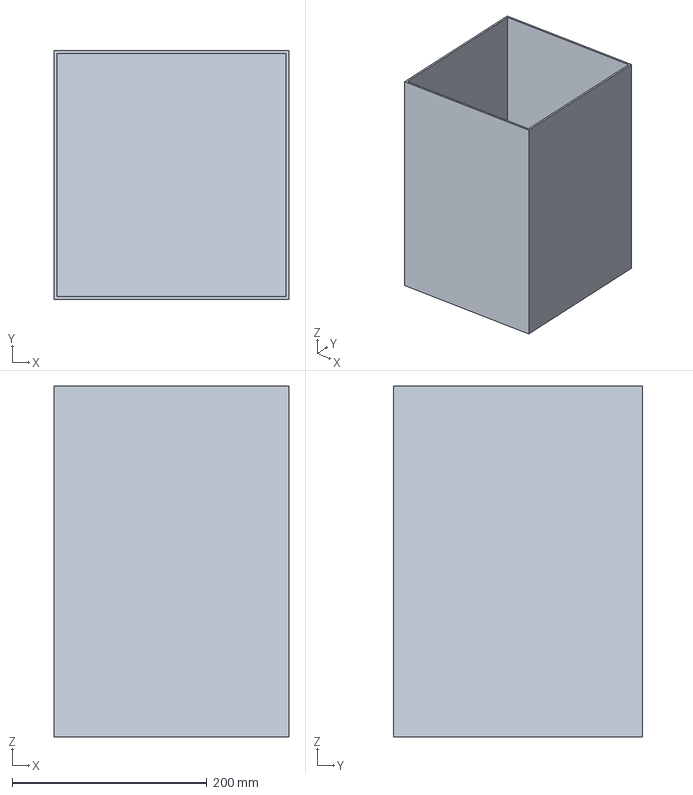
[picture p201: CAD file, 2026-11-10]
golf_project/golf_out/v0028_pull_groove/parts/bin_1.step
241.0 x 255.0 x 360.0 mm
