tom-ainc/kitchen_bench_extension/golf_project/golf_out/v0032_pull_groove_15_down/parts/bin_drawer_side_L.step

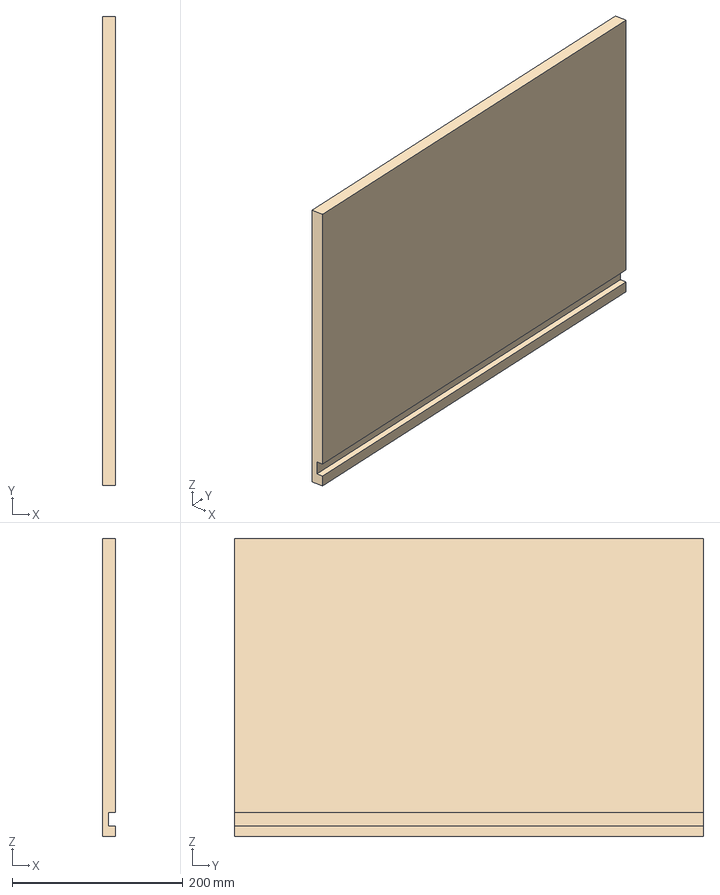
[picture p202: CAD file, 2026-11-10]
golf_project/golf_out/v0032_pull_groove_15_down/parts/bin_drawer_side_L.step
15.0 x 550.0 x 350.0 mm
