tom-ainc/kitchen_bench_extension/golf_project/golf_out/v0033_pull_groove_25_round3/parts/door_push_latch.step

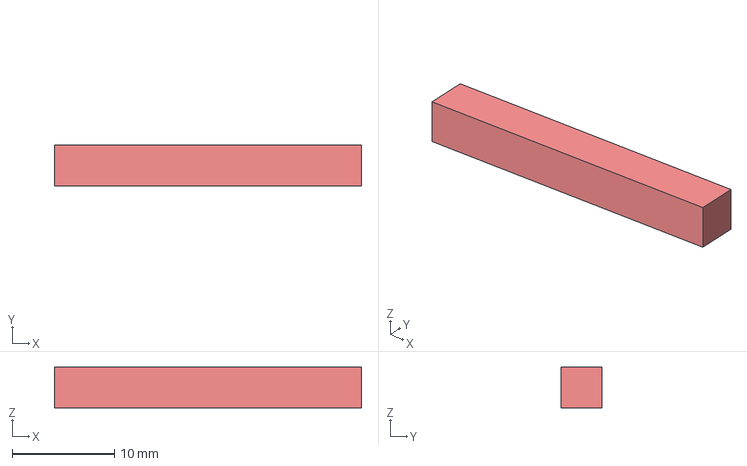
[picture p203: CAD file, 2026-11-10]
golf_project/golf_out/v0033_pull_groove_25_round3/parts/door_push_latch.step
30.0 x 4.00 x 4.00 mm
