tom-ainc/kitchen_bench_extension/golf_project/golf_out/v0036_pull_rebate_15/parts/plinth_rail_front.step

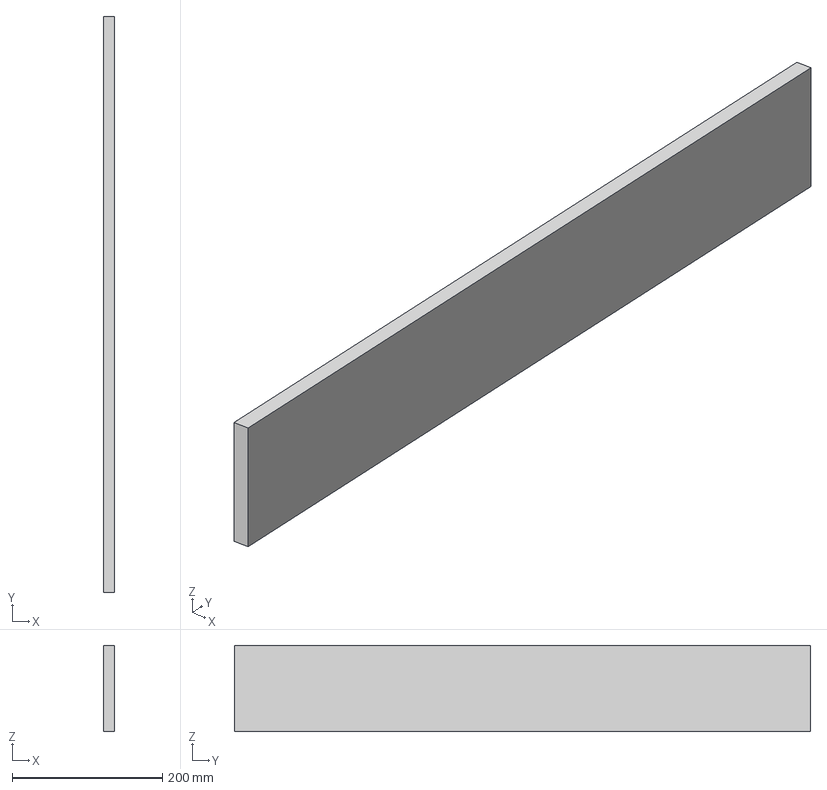
[picture p204: CAD file, 2026-11-10]
golf_project/golf_out/v0036_pull_rebate_15/parts/plinth_rail_front.step
15.0 x 767.0 x 115.0 mm
