tom-ainc/kitchen_bench_extension/golf_project/golf_out/v0037_assembly_guide_base/parts/drawer3_drawbar_L.step

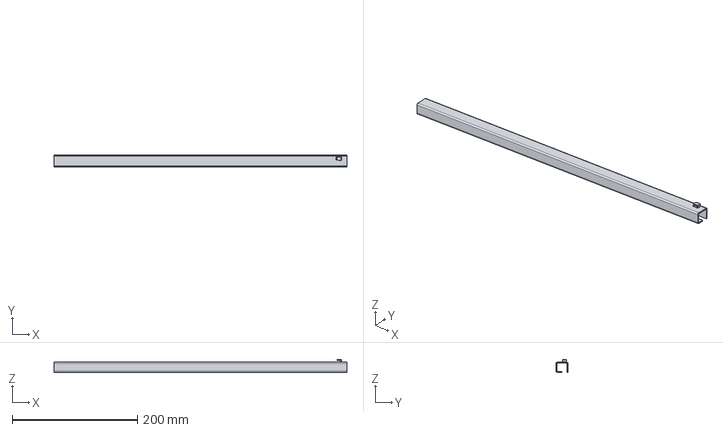
[picture p205: CAD file, 2026-11-10]
golf_project/golf_out/v0037_assembly_guide_base/parts/drawer3_drawbar_L.step
468.0 x 19.2 x 20.2 mm
