tom-ainc/kitchen_bench_extension/golf_project/golf_out/v0041_av_step3_runners/parts/side_joint_end.step

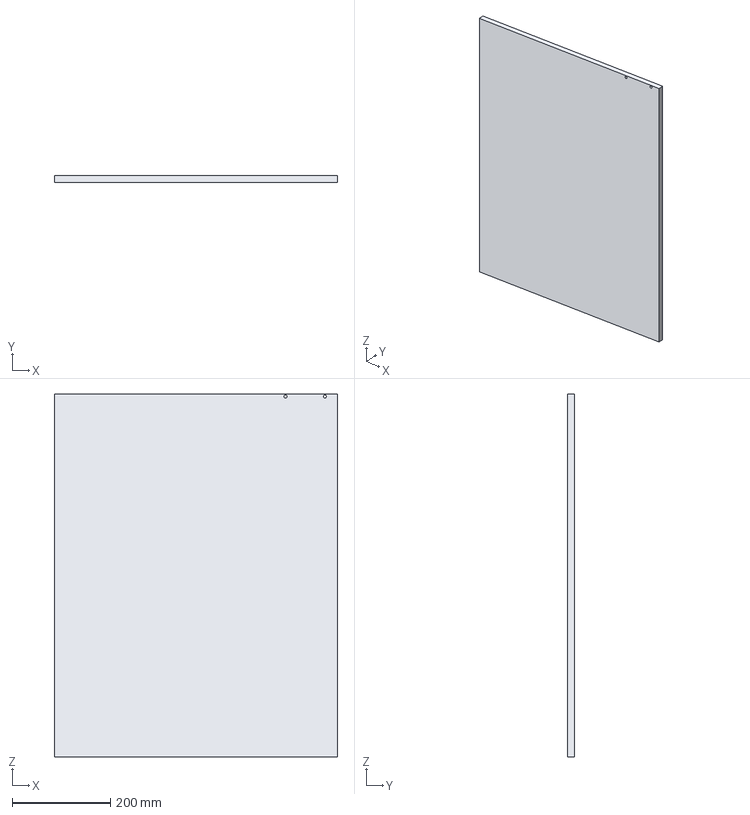
[picture p206: CAD file, 2026-11-10]
golf_project/golf_out/v0041_av_step3_runners/parts/side_joint_end.step
577.0 x 15.0 x 740.0 mm
