tom-ainc/kitchen_bench_extension/golf_project/golf_out/v0042_ext/parts/drawer1_bottom.step

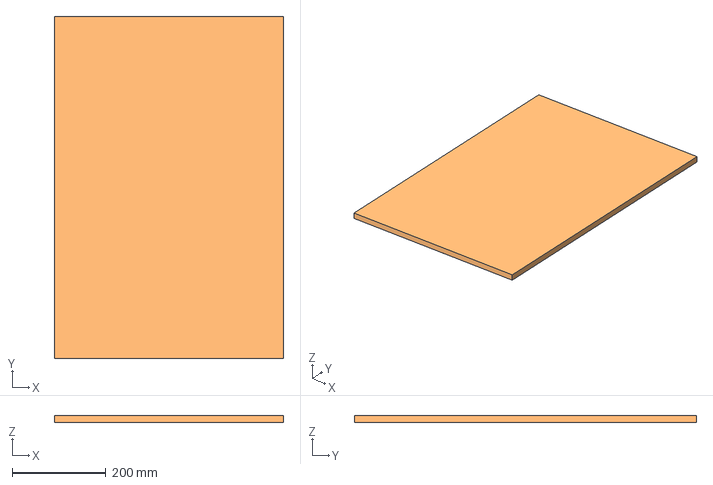
[picture p207: CAD file, 2026-11-10]
golf_project/golf_out/v0042_ext/parts/drawer1_bottom.step
487.5 x 728.5 x 15.0 mm
