tom-ainc/kitchen_bench_extension/golf_project/golf_out/v0046_ext/parts/drawer1_front.step

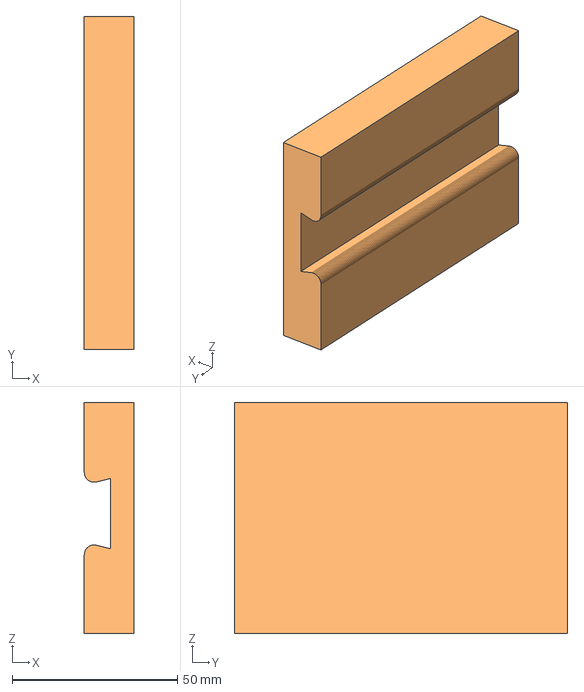
[picture p209: CAD file, 2026-11-10]
golf_project/golf_out/v0046_ext/parts/drawer1_front.step
15.0 x 101.0 x 70.0 mm
