tom-ainc/kitchen_bench_extension/golf_project/golf_out/v0050_rear_setback_30/parts/drawer1_back.step

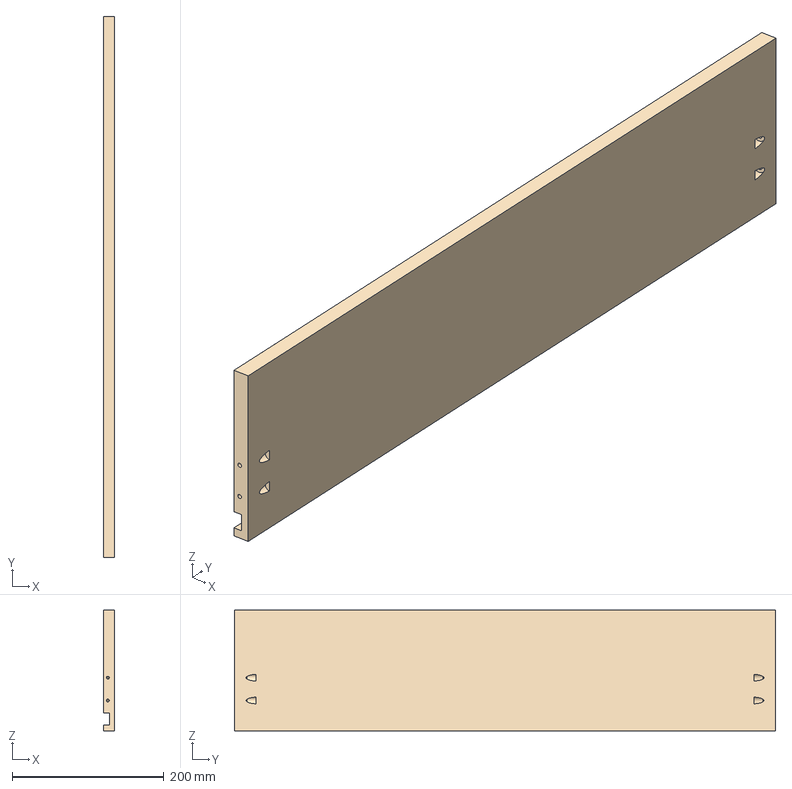
[picture p210: CAD file, 2026-11-10]
golf_project/golf_out/v0050_rear_setback_30/parts/drawer1_back.step
15.0 x 713.0 x 159.0 mm
