tom-ainc/kitchen_bench_extension/golf_project/golf_out/v0052_review_c4_full_top_rail/parts/ref_BenchtopExt.step

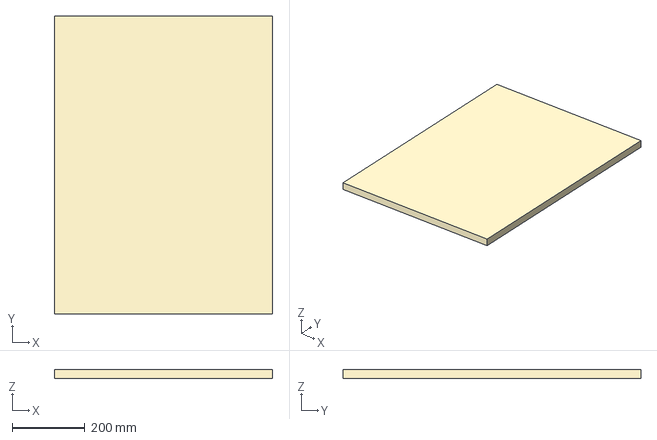
[picture p211: CAD file, 2026-11-10]
golf_project/golf_out/v0052_review_c4_full_top_rail/parts/ref_BenchtopExt.step
600.0 x 820.0 x 25.0 mm
