tom-ainc/kitchen_bench_extension/golf_project/golf_out/v0053_review_fix_brackets_slots/parts/bay_base.step

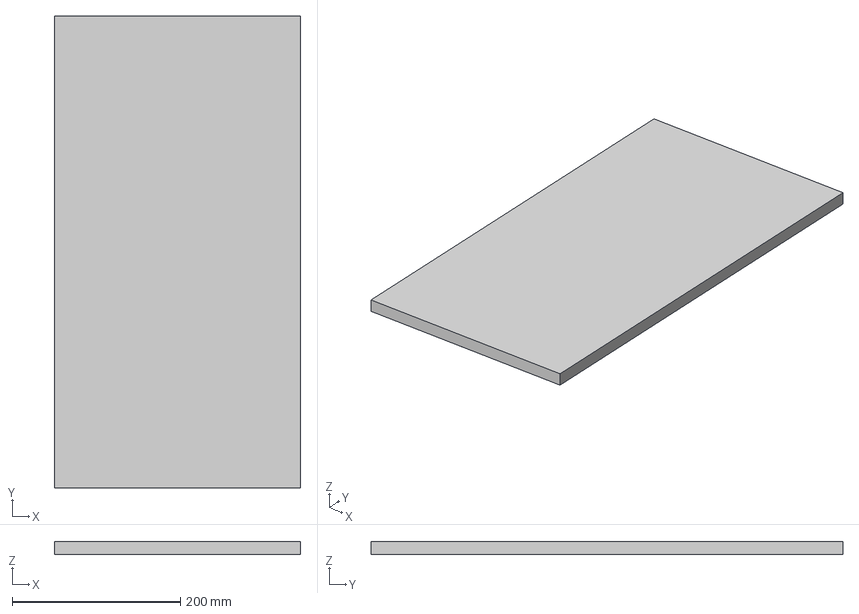
[picture p212: CAD file, 2026-11-10]
golf_project/golf_out/v0053_review_fix_brackets_slots/parts/bay_base.step
293.0 x 561.4 x 16.0 mm
