tom-ainc/kitchen_bench_extension/golf_project/golf_out/v0056_pocket_bore_through_face/parts/ref_framing.step

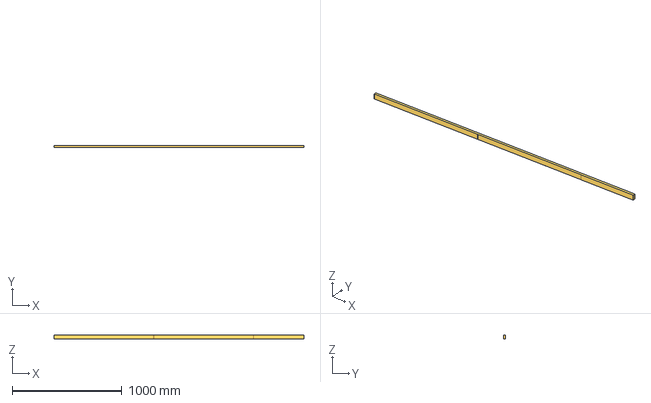
[picture p213: CAD file, 2026-11-10]
golf_project/golf_out/v0056_pocket_bore_through_face/parts/ref_framing.step
2274.0 x 20.0 x 40.0 mm
