tom-ainc/kitchen_bench_extension/golf_project/golf_out/v0059_ext/parts/side_joint_end.step

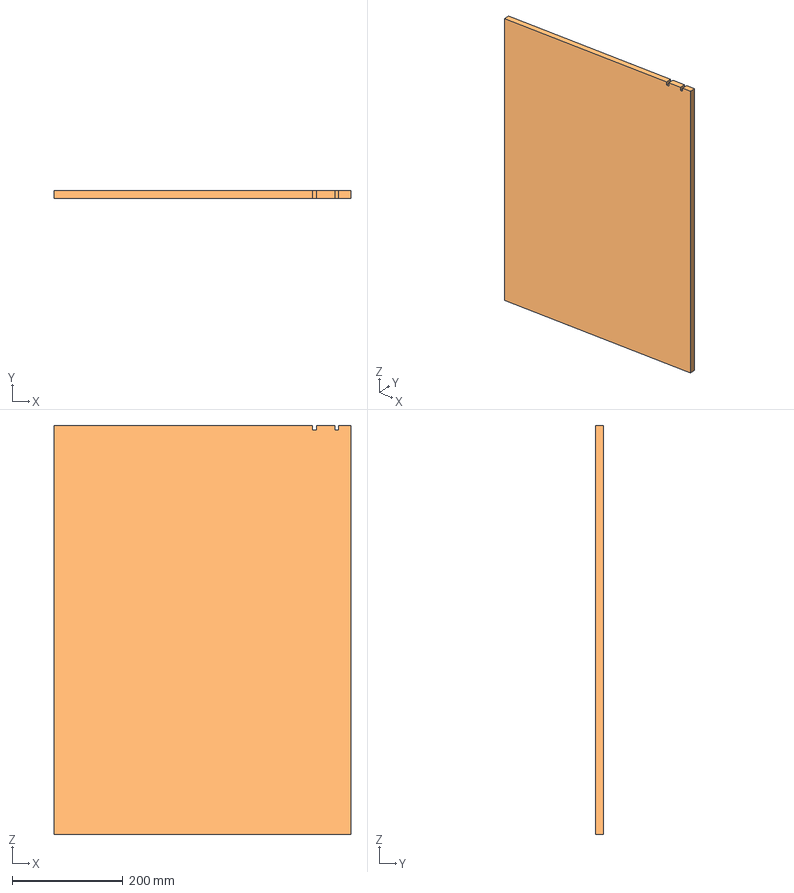
[picture p214: CAD file, 2026-11-10]
golf_project/golf_out/v0059_ext/parts/side_joint_end.step
537.0 x 15.0 x 740.0 mm
