tom-ainc/kitchen_bench_extension/(list of files, cad)

Other CAD files:
golf_project/golf_out/v0094_ext/parts/assembly.step
golf_project/golf_out/v0061_ext/parts/assembly.step
golf_project/golf_out/v0076_ext/parts/assembly.step
golf_project/golf_out/v0087_av4/parts/av_assembly_lines.step
golf_project/golf_out/v0006_option1_clip_hole11/parts/assembly.step
golf_project/golf_out/v0087_av4/parts/assembly.step
golf_project/golf_out/v0076_ext/parts/av_assembly_lines.step
golf_project/golf_out/v0086_av3/parts/assembly.step
golf_project/golf_out/v0094_ext/parts/av_assembly_lines.step
golf_project/golf_out/v0043_ext/parts/assembly.step
golf_project/golf_out/v0126_ext/parts/assembly.step
golf_project/golf_out/v0093_ext/parts/assembly.step
golf_project/golf_out/v0126_ext/parts/av_assembly_lines.step
golf_project/golf_out/v0147_ext/parts/av_assembly_lines.step
golf_project/golf_out/v0062_ext/parts/assembly.step
golf_project/golf_out/v0078_ext/parts/av_assembly_lines.step
golf_project/golf_out/v0127_ext/parts/av_assembly_lines.step
golf_project/golf_out/v0075_ext/parts/assembly.step
golf_project/golf_projects/kitchen_bench_extension-1/golf_out/v0002_read_bench/parts/assembly.step
golf_project/golf_projects/kitchen_bench_extension-1/golf_out/v0012_step4_box_front_sides/parts/assembly.step
golf_project/golf_out/v0145_ext/parts/av_assembly_lines.step
golf_project/golf_out/v0096_ext/parts/av_assembly_lines.step
golf_project/golf_out/v0100_ext/parts/av_assembly_lines.step
golf_project/golf_out/v0089_av6/parts/av_assembly_lines.step
golf_project/golf_out/v0124_ext/parts/assembly.step
golf_project/golf_projects/kitchen_bench_extension-1/golf_out/v0004_drawers_v1/parts/assembly.step
golf_project/golf_projects/kitchen_bench_extension-1/golf_out/v0006_fixings/parts/assembly.step
bench.step
golf_project/golf_out/v0002_probe_clip_bracket/parts/clip.step
golf_project/golf_out/v0003_scan_clip_vs_bracket/parts/clip.step
golf_project/golf_out/v0004_pose_clip_on_bracket/parts/clip.step
golf_project/golf_out/v0005_option1_clip/parts/snap_clip.step
golf_project/golf_out/v0017_detail_opt1_front/parts/drawer1_drawbar_bracket_L.step
golf_project/golf_out/v0020_runner_below_drawbar_clip/parts/drawer2_drawbar_bracket_R.step
golf_project/golf_out/v0026_pull_front_cove/parts/drawer2_drawbar_bracket_R.step
golf_project/golf_out/v0029_pull_groove_full_width/parts/drawer1_snap_clip_L.step
golf_project/golf_out/v0030_base_slot_in_back/parts/drawer3_runner_L.step
golf_project/golf_out/v0034_pull_groove_span25/exports/drawer1_drawbar_bracket_R.step
golf_project/golf_out/v0038_av_step1_plinth/parts/plinth_rail_rear.step
golf_project/golf_out/v0039_av_step2_carcass/parts/plinth_rail_joint_end.step
golf_project/golf_out/v0040_av_step2b_carcass/parts/plinth_return_free_end.step
golf_project/golf_out/v0043_ext/parts/drawer1_drawbar_L.step
golf_project/golf_out/v0044_ext/parts/drawer1_snap_clip_L.step
golf_project/golf_out/v0047_ext/parts/drawer1_front.step
golf_project/golf_out/v0048_ext/parts/plinth_return_free_end.step
golf_project/golf_out/v0051_rear_setback_40/parts/drawer3_drawbar_bracket_L.step
golf_project/golf_out/v0061_ext/parts/drawer1_back.step
golf_project/golf_out/v0062_ext/parts/drawer1_drawbar_L.step
golf_project/golf_out/v0063_ext/parts/drawer3_drawbar_L.step
golf_project/golf_out/v0066_ext/parts/drawer1_front.step
golf_project/golf_out/v0068_ext/parts/drawer1_runner_R.step
Drawer Mounting Hardware - Snap Clip.step
Left Runner Drawbar.step
Right Runner Drawbar.step
golf_project/golf_out/v0001_import_drawbars_clip/parts/L0.step
golf_project/golf_out/v0001_import_drawbars_clip/parts/L1.step
golf_project/golf_out/v0001_import_drawbars_clip/parts/R0.step
golf_project/golf_out/v0001_import_drawbars_clip/parts/R1.step
golf_project/golf_out/v0004_pose_clip_on_bracket/parts/bracket.step
golf_project/golf_out/v0004_pose_clip_on_bracket/parts/drawbar.step
golf_project/golf_out/v0005_option1_clip/parts/base_15mm_ply.step
golf_project/golf_out/v0005_option1_clip/parts/drawbar_L.step
golf_project/golf_out/v0005_option1_clip/parts/screw_1.step
golf_project/golf_out/v0006_option1_clip_hole11/parts/base_15mm_ply.step
golf_project/golf_out/v0006_option1_clip_hole11/parts/drawbar_L.step
golf_project/golf_out/v0006_option1_clip_hole11/parts/screw_1.step
golf_project/golf_out/v0006_option1_clip_hole11/parts/snap_clip.step
golf_project/golf_out/v0007_option2_screws/parts/assembly.step
golf_project/golf_out/v0007_option2_screws/parts/base_15mm_ply.step
golf_project/golf_out/v0007_option2_screws/parts/drawbar_L.step
golf_project/golf_out/v0007_option2_screws/parts/screw_1.step
golf_project/golf_out/v0007_option2_screws/parts/screw_2.step
golf_project/golf_out/v0008_option2_screws_flush/parts/assembly.step
golf_project/golf_out/v0008_option2_screws_flush/parts/base_15mm_ply.step
golf_project/golf_out/v0008_option2_screws_flush/parts/drawbar_L.step
golf_project/golf_out/v0008_option2_screws_flush/parts/screw_1.step
golf_project/golf_out/v0008_option2_screws_flush/parts/screw_2.step
golf_project/golf_out/v0009_option1_closeup/parts/base_15mm_ply.step
golf_project/golf_out/v0009_option1_closeup/parts/drawbar_L.step
golf_project/golf_out/v0009_option1_closeup/parts/screw_1.step
golf_project/golf_out/v0009_option1_closeup/parts/snap_clip.step
golf_project/golf_out/v0010_drawbar_boxes_opt1/parts/KickboardExt.step
golf_project/golf_out/v0010_drawbar_boxes_opt1/parts/basket_runner_L.step
golf_project/golf_out/v0010_drawbar_boxes_opt1/parts/basket_runner_R.step
golf_project/golf_out/v0010_drawbar_boxes_opt1/parts/bay_side_L.step
golf_project/golf_out/v0010_drawbar_boxes_opt1/parts/bay_side_R.step
golf_project/golf_out/v0010_drawbar_boxes_opt1/parts/benchtop_brackets.step
golf_project/golf_out/v0010_drawbar_boxes_opt1/parts/bin_2.step
golf_project/golf_out/v0010_drawbar_boxes_opt1/parts/bin_drawer_back.step
golf_project/golf_out/v0010_drawbar_boxes_opt1/parts/bin_drawer_bottom.step
golf_project/golf_out/v0010_drawbar_boxes_opt1/parts/bin_drawer_front.step
golf_project/golf_out/v0010_drawbar_boxes_opt1/parts/bin_drawer_runner_L.step
golf_project/golf_out/v0010_drawbar_boxes_opt1/parts/bin_drawer_runner_R.step
golf_project/golf_out/v0010_drawbar_boxes_opt1/parts/bin_drawer_side_R.step
golf_project/golf_out/v0010_drawbar_boxes_opt1/parts/carcass_back.step
golf_project/golf_out/v0010_drawbar_boxes_opt1/parts/carcass_bottom.step
golf_project/golf_out/v0010_drawbar_boxes_opt1/parts/door_hangers.step
golf_project/golf_out/v0010_drawbar_boxes_opt1/parts/door_top_track.step
golf_project/golf_out/v0010_drawbar_boxes_opt1/parts/drawer1_back.step
golf_project/golf_out/v0010_drawbar_boxes_opt1/parts/drawer1_bottom.step
golf_project/golf_out/v0010_drawbar_boxes_opt1/parts/drawer1_drawbar_L.step
golf_project/golf_out/v0010_drawbar_boxes_opt1/parts/drawer1_drawbar_R.step
golf_project/golf_out/v0010_drawbar_boxes_opt1/parts/drawer1_drawbar_bracket_L.step
golf_project/golf_out/v0010_drawbar_boxes_opt1/parts/drawer1_drawbar_bracket_R.step
golf_project/golf_out/v0010_drawbar_boxes_opt1/parts/drawer1_fixing_screws.step
golf_project/golf_out/v0010_drawbar_boxes_opt1/parts/drawer1_front.step
golf_project/golf_out/v0010_drawbar_boxes_opt1/parts/drawer1_pocket_screws.step
golf_project/golf_out/v0010_drawbar_boxes_opt1/parts/drawer1_runner_L.step
golf_project/golf_out/v0010_drawbar_boxes_opt1/parts/drawer1_runner_R.step
golf_project/golf_out/v0010_drawbar_boxes_opt1/parts/drawer1_side_L.step
golf_project/golf_out/v0010_drawbar_boxes_opt1/parts/drawer1_side_R.step
golf_project/golf_out/v0010_drawbar_boxes_opt1/parts/drawer1_snap_clip_L.step
golf_project/golf_out/v0010_drawbar_boxes_opt1/parts/drawer1_snap_clip_R.step
golf_project/golf_out/v0010_drawbar_boxes_opt1/parts/drawer2_back.step
golf_project/golf_out/v0010_drawbar_boxes_opt1/parts/drawer2_bottom.step
golf_project/golf_out/v0010_drawbar_boxes_opt1/parts/drawer2_drawbar_L.step
golf_project/golf_out/v0010_drawbar_boxes_opt1/parts/drawer2_drawbar_R.step
golf_project/golf_out/v0010_drawbar_boxes_opt1/parts/drawer2_drawbar_bracket_L.step
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
