tom-ainc/kitchen_bench_extension/assembly/ASSEMBLY_GUIDE.md

# Kitchen Bench Extension: Assembly Guide

_Three-drawer base unit: 15 mm plywood carcass, plinth and drawers on Hafele Alto runner drawbars_

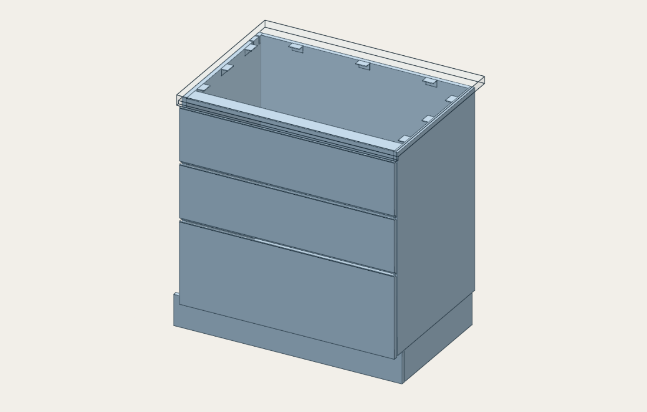
[picture p216: assembly/img/s_final.png]
The finished unit


Solid parts are added in that step; see-through parts are already built. Dashed lines show where each fastener goes.

## Step 1: Plinth frame

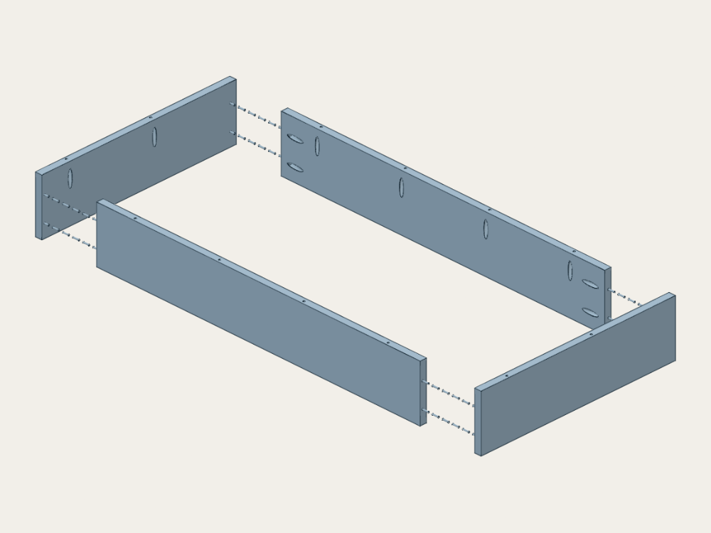
[picture p217: assembly/img/s01_plinth.png]
Plinth frame


**Parts:** 1x P3 side rail, free end  461 x 125; 1x P4 side rail, joint end  461 x 125; 1x P1 front rail  767 x 125; 1x P2 rear rail  767 x 125

1. Rails P1 and P2 go between the side rails P3 and P4.
2. Glue, then pocket-screw P1 and P2 into P3 and P4 (2 per end, 25 mm): the dashed lines show the screws.
3. P2 is 8 mm in from the rear ends of P3 and P4, so it lies under C3. Frame is 797 wide, 125 high.

> **Check.** Diagonals equal within 1 mm. Frame flat on the floor.

## Step 2: Carcass and plinth

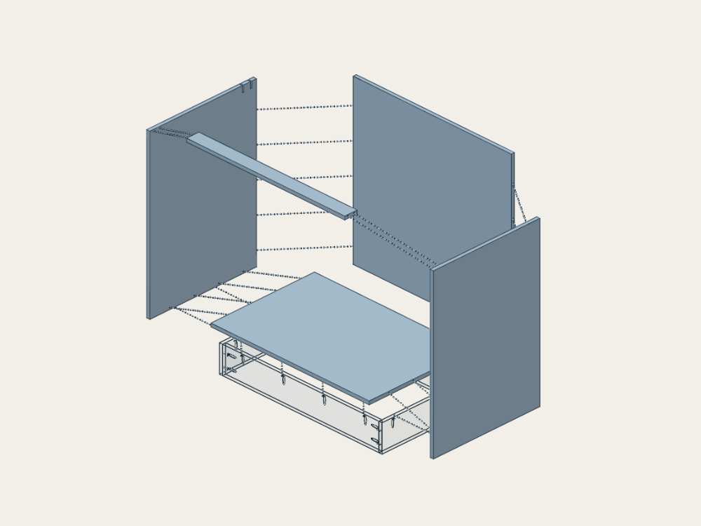
[picture p218: assembly/img/s02_carcass.png]
Carcass and plinth


**Parts:** 1x C1 side, free end  749 x 522; 1x C2 side, joint end  749 x 522 (2 slots); 1x C3 bottom  775 x 507; 1x C4 back  775 x 749; 1x C9 top rail  775 x 60

1. Sides stand on the plinth. The joint-end side C2 has the two 6.5 mm holes.
2. C3 sits between the sides, level with their bottom edges and flush at the front.
3. C4 is full height, between the sides at the rear, standing on the plinth side rails; C3 butts it. C9 goes between the sides at the top front.
4. Glue every joint and pocket-screw it (25 mm) into the faces of the sides.
5. Turn the carcass upside down, set the plinth on it and pocket-screw the rails up into C3 and the sides from inside the frame (12 screws, dashed lines). Then turn it upright.

> **Check.** Opening diagonals equal within 1 mm. Frame set back 54 behind the front of C3.

## Step 3: Runners on the carcass walls

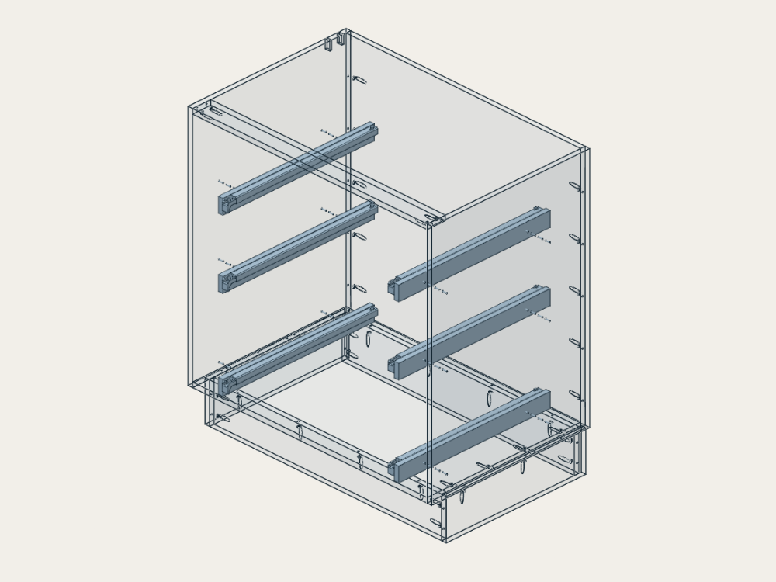
[picture p219: assembly/img/s03_runners.png]
Runners on the carcass walls


**Parts:** 3x Hafele Alto runner pair, drawbars and brackets

**Drawbar plate top above C3:** D1 534, D2 331, D3 50

1. Fix each runner to the wall with its drawbar plate at the heights below.
2. Measure from the top of C3. Left and right must match within 1 mm.
3. Runner front end 2 mm behind the back face of the drawer front.

> **Check.** Level across both drawbars. Each runner slides freely.

> **Warning.** Follow the Hafele fixing instructions for the runner holes.

## Step 4: Drawer box parts (D1 shown)

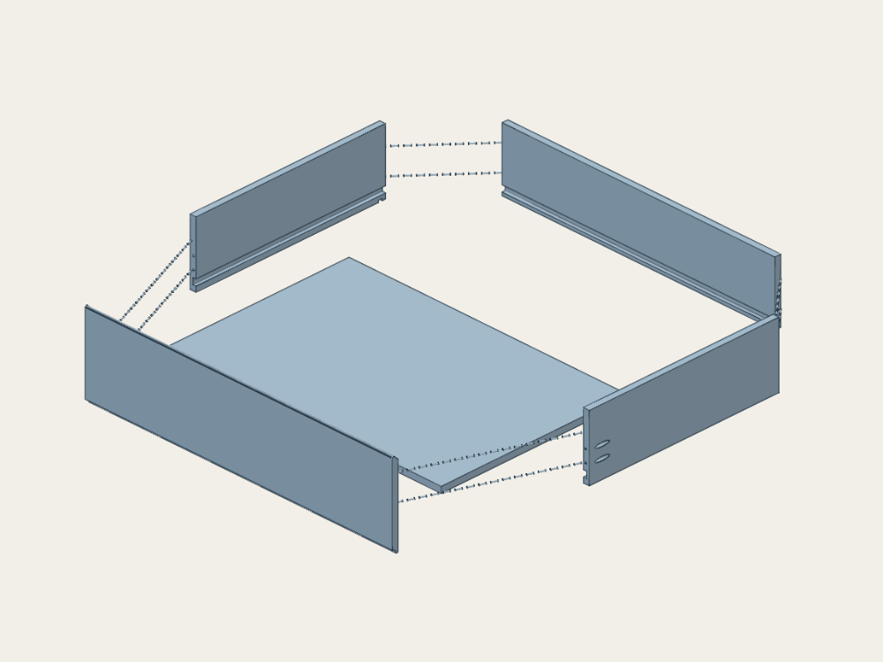
[picture p220: assembly/img/s04_box_parts.png]
Drawer box parts (D1 shown)


**Parts:** 1x front, plain; 2x sides 495 x 153 (D3: 231); 1x back 713 x 148 (D3: 226); 1x base 728.5 x 487.5

1. Rout the base groove first: 15.5 wide, 8 deep, in both sides and across the back.
2. Drill the pocket holes (15 degrees) and the clip pilots, then assemble.
3. Order: back between the sides, slide the base in from the front, fit the front last.

> **Check.** Box square within 1 mm, outside width 743.

> **Warning.** Rout and drill every part before any gluing.

## Step 5: Box onto the drawbars

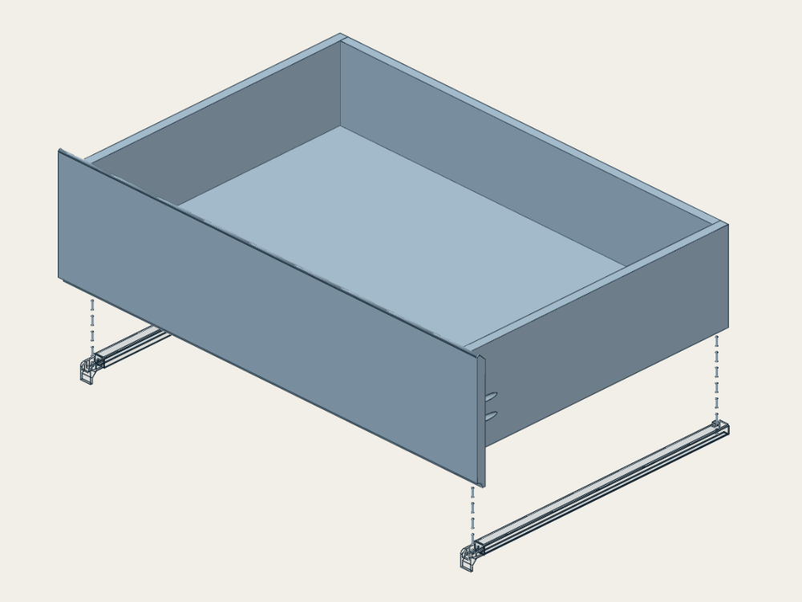
[picture p221: assembly/img/s05_box_on_drawbars.png]
Box onto the drawbars


**Parts:** 2x snap clip per drawer; 2x No.6 x 12 screw per drawer

1. Screw each snap clip up into the bottom edge of its side.
2. Pull the runners out. Lower the box so the clips drop into the brackets.
3. The rear tabs go into the notches. Push the drawer home.

> **Check.** Box does not lift when pulled hard. 16 mm clear to each wall.

## Step 6: Drawer 1 in the carcass

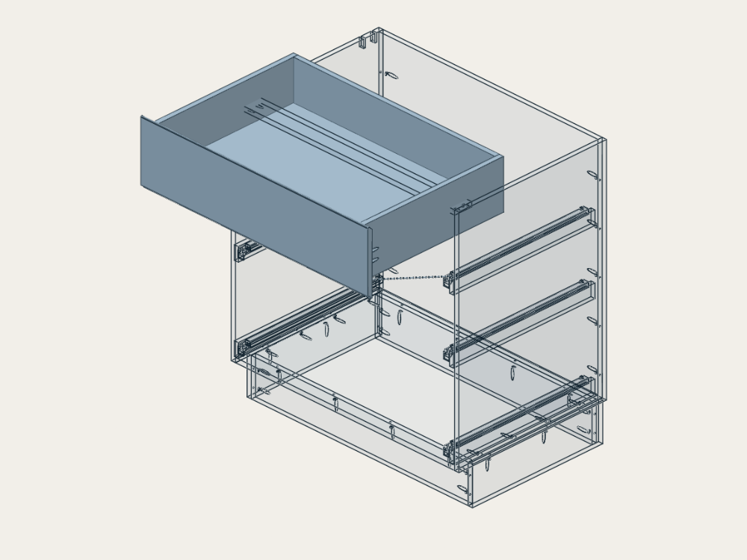
[picture p222: assembly/img/s06_box_into_carcass.png]
Drawer 1 in the carcass


**Parts:** 1x drawer 1 box on its drawbars

1. Lower the box onto the drawbars so the clips drop into the brackets.
2. Push the drawer home and run it in and out.
3. 18 mm is free behind the box.

> **Check.** Runs freely on its runners, no rattle.

## Step 7: Cut the pulls on the fronts

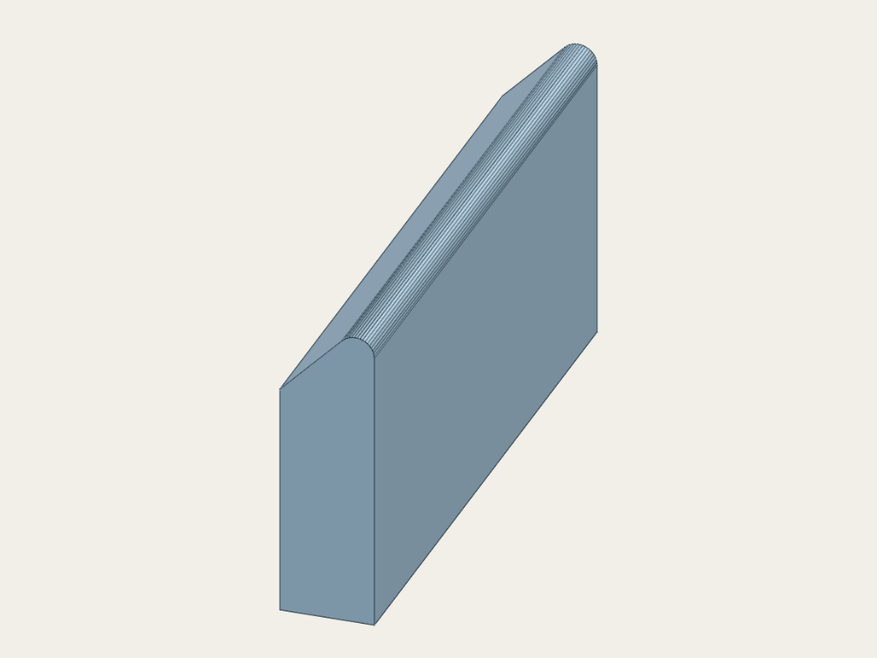
[picture p223: assembly/img/s07_pull_mitre.png]
45 degree mitre top


**Parts:** 3x drawer front: D1, D2 212.7 high, D3 326.3

1. Top edge of D1, D2, D3: rebate from the back (7.5 wide) to the shelf, 45 degree wall on the front lip, R3 on the nose, R1 sanded by hand. The fingertip hooks the 7.5 mm catch wall.
2. Bottom mitre: full 45 degree mitre, 15 mm high on the face, on the bottom edge of D1 and D2; round the thin back edge to R2 and the arris to R3, no sharp edge (pinch point as the runners self-close).
3. Each nose stays about 5 mm below the lowest point of the front above (10 mm overlap).

> **Check.** Test the mitres on an offcut. Finish the fronts before fitting.

## Step 8: Fit all fronts and drawers

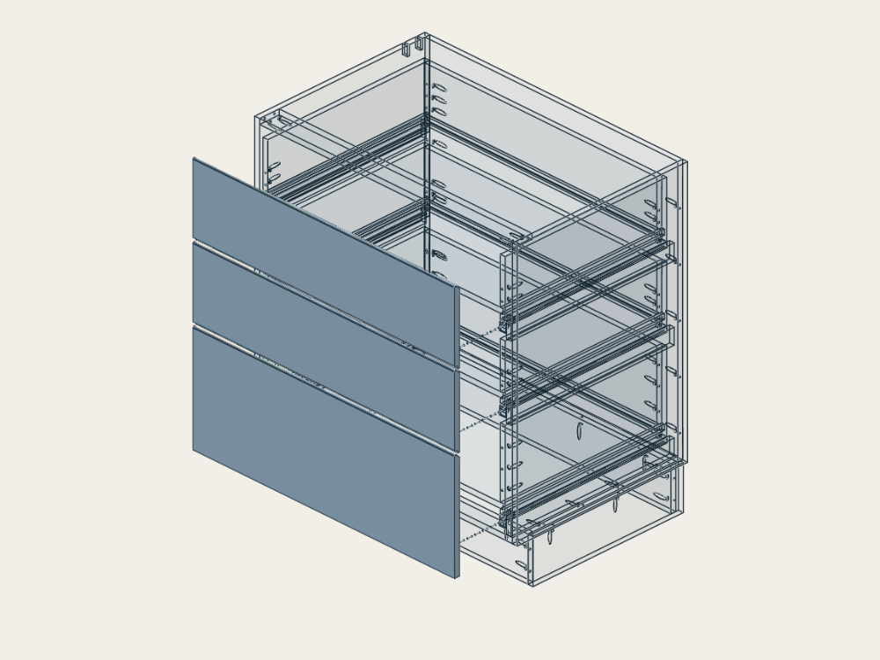
[picture p224: assembly/img/s08_fronts.png]
Fit all fronts and drawers


**Parts:** 2x box D2, D3 (build as step 4 and 5); 3x finished front; 1x top strip 802 x 32.3 + 6 mm packer 775 x 15

1. Boxes go in from the bottom up, D3 first.
2. Each nose stays about 5 mm below the lowest point of the front above. Fronts fix through 6 mm oversize holes. D1 (212.7 high) has its mitre plane 15 mm below a parallel plane through the back-bottom edge of the hem. D3 ends level with the doors and hangs 5 mm below C3.
3. Fronts are 802 wide, 1.5 in from each end of the carcass.
4. Top strip: glue the 20 high packer to the strip and to C9, clamp. Same bottom mitre as D1/D2; it closes the gap above D1.

> **Check.** Five full open/close cycles per drawer, overlaps even.

## Step 9: Kickboard, benchtop and link bolts

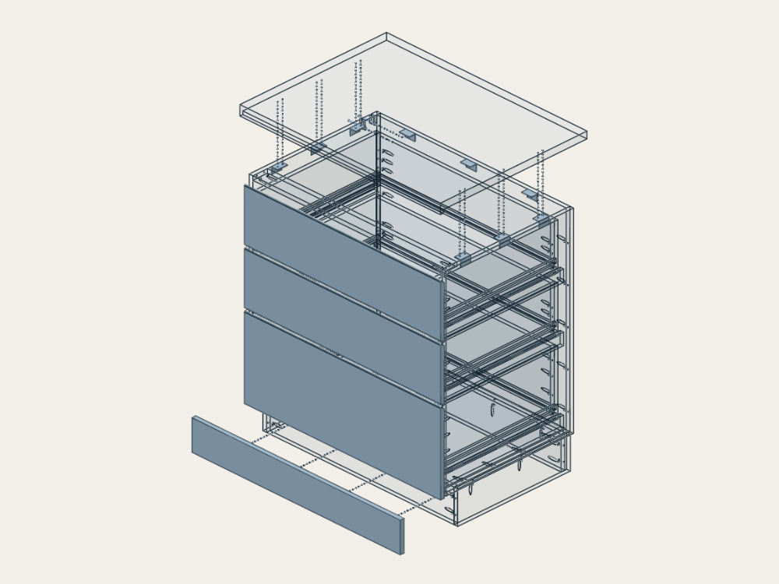
[picture p225: assembly/img/s09_kickboard_top.png]
Kickboard, benchtop and link bolts

Finished

**Parts:** 1x Kb kickboard 852 x 115; 4x No.8 x 25 screw; 9x angle bracket 25 x 25 x 2, 40 long; 2x M6 x 65 bolt with washers

1. Kickboard: 4 screws from inside the plinth through P1. It carries no load.
2. Brackets: 3 per side wall at 96, 256, 416 from the front, 3 on the back panel.
3. Benchtop onto the brackets, butt joint to the main top, then caulk.
4. Link bolts through the two slots in C2 into the main run's rail: fit them before the benchtop goes on.

> **Check.** Brackets tight, joint closed, bolts tight.

---

# Written guide: details, dimensions and checks

Companion to the shop drawings (extension_unit_shop_drawings.pdf, sheet numbers are quoted as 'sheet N'). Based on the CAD model (run v165) and not yet proven by building it: where the model assumes something, the step says so. All dimensions are in millimetres. Part references (C1 to C4, C9, P1 to P4, Kb, D1 to D3) are those on sheet 1.

## 1. Build sequence

| Stage | What | Sheets |
|---|---|---|
| 1 | Cut and label the parts | 1, 10 |
| 2 | Rout and drill the carcass-independent parts (sides, backs, bases) | 6, 7, 8 |
| 3 | Plinth frame | 5 |
| 4 | Carcass on the plinth | 4 |
| 5 | Fit the runners at the three heights | 2, 8 |
| 6 | Build drawer 1 and fit it | 7, 8, 9 |
| 7 | Rout the pulls on the fronts, finish the fronts | 9 |
| 8 | Build drawers 2 and 3, fit all fronts | 7, 8 |
| 9 | Kickboard, benchtop brackets, link bolts, caulk | 2, 3, 4 |
| 10 | Final checks. Removal procedure at the end |  |

## 2. Before you start

### Materials and hardware (sheet 1)

- 15 mm structural ply, 2 sheets of 2400 x 1200 (sheet 10 nests every part on two sheets, about 92% and 75% full, allowing a 3 mm kerf; sheet 11 is a three-sheet layout for a panel saw that only cuts on 100 mm multiples). All parts are 15 mm. Grain runs along the length of each part.
- Hafele Alto 86 x 500 mm drawer sets, 3 off. Only the runners, drawbars, front brackets and snap clips are used; the steel sides are not.
- Snap clips (6, two per drawer, in the Alto sets) with 6 No.6 x 12 pan-head screws: this is the main fixing (option 1). Only if you choose the alternative (option 2, tabs ground off, screws from below) you need 12 No.6 x 12 screws instead (two per drawbar).
- Pocket-hole screws, 25 mm, coarse thread: 70 (drawer boxes 28: D1 and D2 take 8 each, D3 takes 12; carcass and plinth 42: C3 8, C4 10, C9 4, plinth rail joints 8, plinth to carcass 12). Pocket jig set for 15 mm stock.
- Steel angle brackets 25 x 25 x 2, 40 long: 9. M6 x 65 bolts with washers: 2. No.8 x 25 screws: 4. Bracket screws: 18 No.8 x 12 (into the carcass) and 18 No.8 x 16 (up into the benchtop).
- PVA glue, finish for the fronts, caulk for the benchtop joint.

### Tools

- Hand router with a fence or edge guide, straight bits, a 3 mm roundover bit, and a table saw or circular saw tilted to 45 degrees (or a large 45 degree chamfer bit with a fence) for the mitre.
- Pocket-hole jig set for 15 mm stock at 15 degrees, with a stepped drill; drill/driver, 3.5 mm and 4.2 mm drills, countersink.
- Saw or track saw, clamps, square, long straight edge, spirit level, tape, offcuts of 3 mm and 5 mm for spacers.
- For fixing option 2 only: angle grinder to take off the drawbar tabs, a centre punch and a metal drill; touch-up paint.

> **CHECK BEFORE CUTTING.** 1) Measure the real Alto drawbar, bracket and snap clip against the STEP files you supplied. Every dimension on sheet 8 comes from those files. 2) Measure your ply: the base grooves are 15.5 wide for a 15 mm base. Cut a test groove in an offcut. 3) The Hafele front-bracket hole pattern and the runner setback are not dimensioned in the model. Keep the instruction sheet from the Alto sets to hand. 4) The carcass and plinth stop 40 mm short of the wall to clear a skirting board that projects 20 to 25 mm. Measure the real skirting projection and height before cutting; the benchtop keeps its full 600 depth and overhangs the back of the carcass by 40.

## 3. Stage 1: cut and label the parts

Cut to the cutting diagrams on sheet 10 (exact sizes, two sheets) or sheet 11 (every store cut on a multiple of 100, blanks trimmed at home; three sheets). Squareness within 0.5 mm matters most on the drawer parts. Label every part with its reference and mark the front edge and the show face, then lay out the parts as below.

| Ref | Part | Qty | Length x Width |
|---|---|---|---|
| C1 | Side, free end | 1 | 749 x 522 |
| C2 | Side, joint end (two 6.5 holes) | 1 | 749 x 522 |
| C3 | Carcass bottom | 1 | 775 x 507 |
| C4 | Carcass back | 1 | 775 x 749 |
| C9 | Top rail, front | 1 | 775 x 60 |
| P1, P2 | Plinth rails, front and rear | 2 | 767 x 125 |
| P3, P4 | Plinth rails, side (free end, joint end) | 2 | 461 x 125 |
| Kb | Kickboard cover | 1 | 852 x 115 |
| D1, D2 | Drawer front | 2 | 802 x 212.7 |
| D3 | Drawer front | 1 | 802 x 326.3 |
| D1, D2 | Drawer side | 4 | 495 x 153 |
| D3 | Drawer side | 2 | 495 x 231 |
| D1, D2 | Drawer back | 2 | 713 x 148 |
| D3 | Drawer back | 1 | 713 x 226 |
| TS | Top strip (false front above D1) | 1 | 802 x 32.3 |
| TP | Strip packer, 6 mm ply or hardwood (offcut) | 1 | 775 x 20 |
| D1 to D3 | Drawer base | 3 | 728.5 x 487.5 |

> **FRONTS.** Leave the fronts plain for now. The mitres are cut in stage 7. Do not finish them yet.

## 4. Stage 2: rout and drill the drawer parts

Do all routing and drilling before any gluing. Hand router with a fence; test every set-up on an offcut first. Sand the inside faces now.

### Drawer sides (6 off, mirrored pairs; sheets 6 and 8)

1. Base groove on the INSIDE face of each side: 15.5 wide x 8 deep, running the full 495 length (open at both ends). The groove runs from 12.75 to 28.25 above the bottom edge (lower edge about 13 above the bottom edge). Make it in two or three passes against the fence rather than one.
2. Pocket holes in the OUTER face at the front end, 15 degrees, exiting the end grain 9 mm in from the outer face (they screw into the back of the front panel). Heights above the bottom edge: D1 and D2 at 45 and 75; D3 at 60, 118 and 176. Keep clear of the groove.
3. Snap clip fixing (main path): pilot hole 3.5 dia x 11.4 deep up into the bottom edge, 10.7 from the front end, for the clip screw; and a notch in the inner bottom edge for the drawbar's rear tab (about 10 long, 4.6 deep, centred 481.9 from the front end). Mark both from the real clip and drawbar, not from the drawing alone.
4. ALTERNATIVE, fixing option 2 (screws from below), instead of the previous step: drill two 3.5 dia x 10.5 deep pilots up into the bottom edge, 36.5 and 456.5 from the front end, 3.3 mm from the inner face. No tab notch.

### Drawer backs (3 off; sheet 7)

1. Base groove across the whole inside face, 15.5 x 8, running from end to end. The groove sits 7.75 above the back's bottom edge to 23.25, so it lines up with the side grooves once the back is fitted 5 above the bottom of the sides.
2. Pocket holes in the REAR face of the back, 15 degrees, exiting the end grain 9 mm in from the rear face. Heights above the back's bottom edge: D1 and D2 at 40 and 70; D3 at 55, 123 and 181.

### Bases (3 off) and fronts

- Bases are plain rectangles, 728.5 x 487.5. They need no routing.
- Fronts are plain 15 mm panels with no base groove. Their pull is cut in stage 7.

## 5. Stage 3: plinth frame (sheet 5)

1. Build the frame flat on the floor: side rails P3 (free end) and P4 (joint end), 461 long, on the outside, front rail P1 and rear rail P2 (767) between them. The overall frame is 797 wide and 125 high. Glue, then pocket-screw (25 mm, 2 per end at 30 and 85 above the floor, holes in the inner faces of P1 and P2) into P3 and P4. Screws into the end grain of plywood hold poorly, so do not screw through P3 and P4 into the ends.
2. Set P2 8 mm in from the rear ends of P3 and P4, so it lies fully under C3 with its rear face level with C3's rear edge. P3 and P4 run on under the back panel C4, which stands on their ends.
3. The frame sits 54 mm behind the front edge of the carcass bottom (C3), 6 mm in from the outside face of the free-end side C1 and 2 mm in from the outside face of the joint-end side C2. The plinth is fixed to the carcass in the next stage, with the carcass upside down, so do not fit the kickboard yet.
4. Check the frame is square (diagonals within 1 mm) and flat. Shim or scribe under it for an uneven floor; do not pack under the carcass.

## 6. Stage 4: carcass on the plinth (sheet 4)

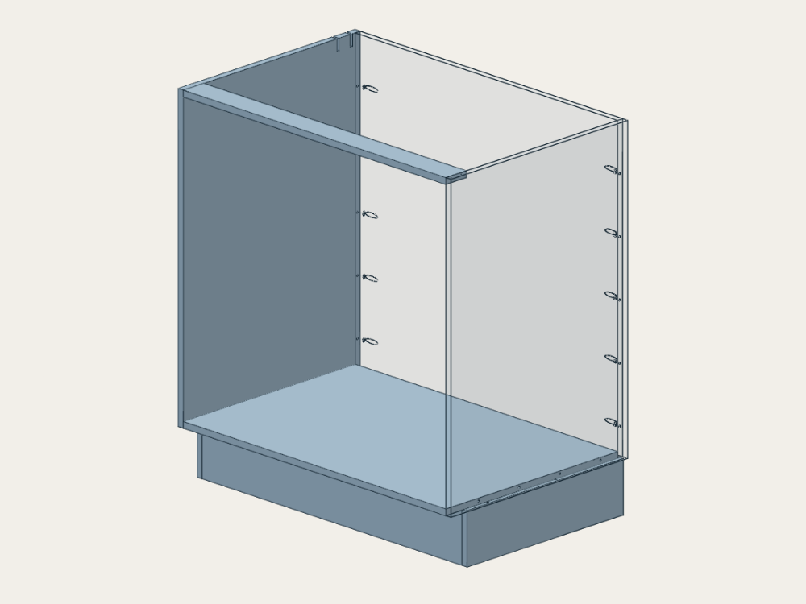
[picture p226: assembly/img/s_carcass.png]
Carcass sides, bottom and back on the plinth frame (kickboard not yet fitted).

*Carcass sides, bottom and back on the plinth frame (kickboard not yet fitted).*

1. Stand C1 and C2 on the plinth on their bottom edges. C2 is the joint end: its two link-bolt slots (6.5 wide, 27.4 deep from the top edge) are centred 456.1 and 496.1 back from the front edge. They open to the top edge and are deep enough to let the unit sit 20 mm or so higher or lower on the bolts. Check they are on the outside, towards the main run.
2. Fit C3 (bottom) between the sides, its lower face level with the bottom edges of the sides and its front edge flush with the front edges. The clear width between the sides is 775 and the inside depth is 507.
3. Fit C4 (back), full height (749), between the sides at the rear, standing on the ends of the plinth side rails (8 mm bearing), its rear face flush with the rear edges of the sides. C3 butts its front face. Fit the front top rail C9 (775 x 60) between the sides at the top, its front edge flush with the front edges of the sides.
4. Glue every joint and pocket-screw it (25 mm): C3 into the sides, 4 per side at 96, 216, 336 and 456 back from the front edge, holes in the underside of C3 (clear of the plinth rails); C4 into the sides, 5 per side at 70, 210, 350, 490 and 630 above its bottom edge, holes in the rear face of C4; C9 into the sides, 2 per end at 15 and 45 back from the front edge, holes in the underside of C9. The screws go into the face grain of the sides. Check the diagonals of the carcass and of the opening at the front: within 1 mm. Then, with the carcass upside down on the bench, set the plinth frame on it (P1 and P2 across C3, P3 and P4 under the bottom edges of the sides) and pocket-screw it on from inside the frame: 4 screws from P1 and 4 from P2 up into the underside of C3, at 100 and 300 either side of the centre line, and 2 from each of P3 and P4 up into the bottom edges of the sides, 159 and 359 back from the front edge of the benchtop. Glue the contact faces first. Turn the unit upright when the glue has set.
5. C9 ties the front of the sides together and the benchtop brackets in stage 9 tie the rest. Do not move the carcass until the brackets are fitted.

## 7. Stage 5: fit the runners (sheets 2, 3 and 8)

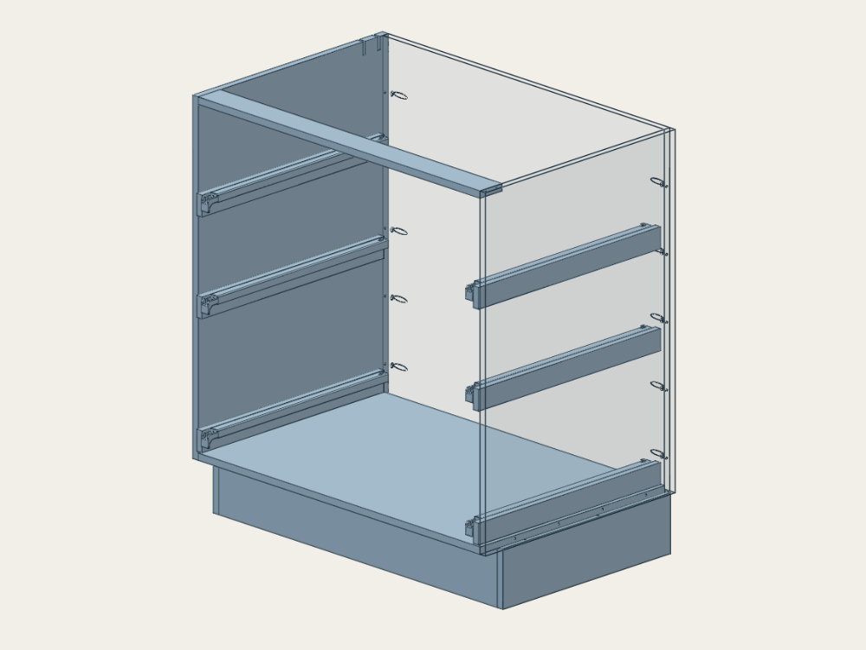
[picture p227: assembly/img/s_runners.png]
Runners and drawbars at the three heights, on the carcass walls (near side hidden).

*Runners and drawbars at the three heights, on the carcass walls (near side hidden).*

Each Alto runner is a telescoping steel stack that hangs 45 below its drawbar plate, with the fixing plates against the wall. The drawbar's outer face is 14 from the cabinet wall (11 to the fixing plates plus the 3 mm plate) and the 8 mm underside opening faces away from the wall.

| Drawer | Top of drawbar plate above top of C3 | Underside of runner above C3 |
|---|---|---|
| D1 (top) | 534 | 489 |
| D2 (middle) | 331 | 286 |
| D3 (bottom) | 50 | 5 |

1. Cut a story stick or three spacer blocks to the heights above. Measure from the TOP of C3 (the floor of the carcass), not from the plinth.
2. Fix each left and right runner to the carcass wall with its drawbar plate at that height. Pairs must be level with each other within 1 mm across the carcass; check with a level across both drawbars.
3. Set the front end of each runner 2 mm behind where the back face of the drawer front will be. That puts the runner front about 4 mm forward of the front edge of the carcass sides. This follows the model; check it against the setback in the Hafele instructions before drilling.
4. Use the fixing screws and holes the Hafele instructions give. The model does not draw the plates or the hole pattern.
5. Pull each runner out and slide it back: it should run freely and the three left-hand drawbars should line up above each other when looked at from the front.

> **ASSUMPTION.** The fixed runner is modelled as a 14 x 45 block (500 long). The real section is not modelled. Check on the first fitted runner that nothing clashes, in particular the bottom runner's 5 mm clearance above C3 and the 5 mm clearance between each box and the runner above it.

## 8. Stage 6: build drawer 1 and fit it

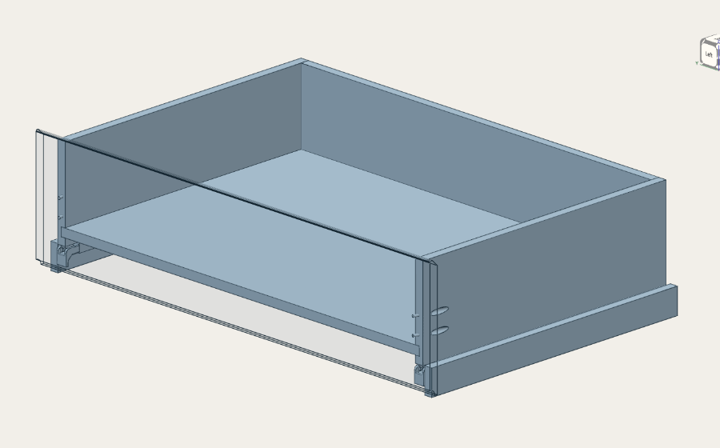
[picture p228: assembly/img/s_box.png]
One drawer box with the drawbars and snap clips (front panel at the left, rear panel at the right).

*One drawer box with the drawbars and snap clips (front panel at the left, rear panel at the right).*

Build D1 first and prove it before cutting the pulls. The box is assembled front-last: sides and back first, the base is slid in from the front, then the front is fitted.

1. Dry-fit: sides, back, base and front, with the base in the three grooves. The base should slide in with a hair of play (the groove has 0.25 clearance each side). Adjust now, not after gluing.
2. Glue and screw the back between the sides: pocket screws from the rear face of the back into the sides. The back's bottom edge is 5 above the bottom edge of the sides.
3. Check the frame is square: diagonals within 1 mm, outside width 743 (16 clear of each wall).
4. Slide the base in from the front until it sits in the back groove and its front edge is level with the front ends of the sides. The base is 728.5 x 487.5; its rear edge ends 0.5 short of the bottom of the back groove. Do not glue it at the sides or back (it floats in the grooves), but when the front is finally fitted glue a thin bead along the front edge of the base to the front panel: the base is otherwise unsupported at the front, and a loaded D3 would sag there.
5. Fit the front last, and only after stage 7 (cut the pulls and finish the fronts first). Dry-fit it with the pocket screws through the sides into the front, glue nothing yet: glue only after the open-and-close test in stage 8. Drill the front's screw holes 6 mm oversize with washers so the front can move about 1 mm each way, and set it on 2 mm spacers when fixing. The front overhangs the box by 29.5 each side (802 against 743) and sits 1.5 in from each end of the carcass.
6. Fit the snap clips: screw each clip up into the bottom edge of its side (No.6 x 12, 10.7 from the front end) and check the clip ears bite lightly into the ply. ALTERNATIVE (option 2, instead of the clips): grind the rear tab flush, drill 4.2 holes through the drawbar plate at the centre of the 8 mm opening (36.5 behind the bracket and 38 from the rear end), deburr and touch up the steel, then screw up through the opening into the pilots (two 12 mm screws per side).
7. Pull the runners out fully. Lower the box onto the drawbars: the clips drop into the bracket pockets from above and the rear tabs enter the notches. Push the drawer home. The back of the front panel should sit 6 mm in front of the carcass front edge, and the front of D1 level with the others (its mitre plane 15 mm below a parallel plane through the back-bottom edge of the benchtop hem). Adjust the box on the drawbars until the gaps are even.

## 9. Stage 7: cut the pulls and finish the fronts

Do this stage BEFORE fitting any front to its box (before stage 6 step 5 and stage 8). Cut and finish all three fronts and the top strip first, then dry-fit them with screws only.

| Pull | Where | How | Sheet 9 |
|---|---|---|---|
| 45 degree mitre with catch wall | Top edge of D1, D2 and D3 | Profile on sheet 9, A. (1) Rout a rebate from the BACK face with a straight bit: 7.5 mm wide (half the thickness) down to a shelf 24.7 mm below the top edge. That leaves a front lip 7.5 mm thick with a vertical catch wall 7.5 mm high behind it (optional: one pass of the 14 degree dovetail bit into the catch wall for a slight undercut). (2) Cut the 45 degree wall on the front lip only with the 45 degree chamfer cutter: the sharp apex is 9.7 mm below the original top edge on the face, and the wall runs back 7.5 mm to the top of the catch wall. (3) Run a 3 mm roundover bit (R3, bearing on the face) along the nose, set so the arc starts 14.9 mm down the face; the arc meets the 45 degree wall at an edge: sand an R1 there by hand. The nose top ends about 12 mm below the original top edge. The fingertip hooks the catch wall. | A |
| Bottom mitre | Bottom edge of D1 and D2 | 45 degree mitre on the front-bottom edge, 15 mm high on the face, so it is about 15 mm clear to the mitre of the front below (the width of a finger to past the first knuckle). Cut it with the saw tilted to 45 degrees against a fence, or a chamfer bit in several passes, full 802 width, as a full mitre through the whole thickness. Then round the thin back edge to about R2 and the arris where the mitre meets the face to R3 (roundover bits, then sand): there must be no sharp edge, because the runners pull the drawer shut for the last bit and could trap fingers. Rounding the back edge lifts the lowest point of the front by 2.8 mm, so the closed gap to the nose below is about 5 mm. The nose of the front below stays 2 mm clear of it. | A2 |

1. Test the mitres on an offcut first. The mitre leaves a 45 degree wedge at the nose: hand sand an R1 on the edge where the R3 meets the mitre face, and ease the other arrises lightly.
2. Sand, then finish the fronts on both faces (paint or clear finish) before fitting. Keep finish off the faces that get glued and screwed.

## 10. Stage 8: drawers 2 and 3, and all the fronts

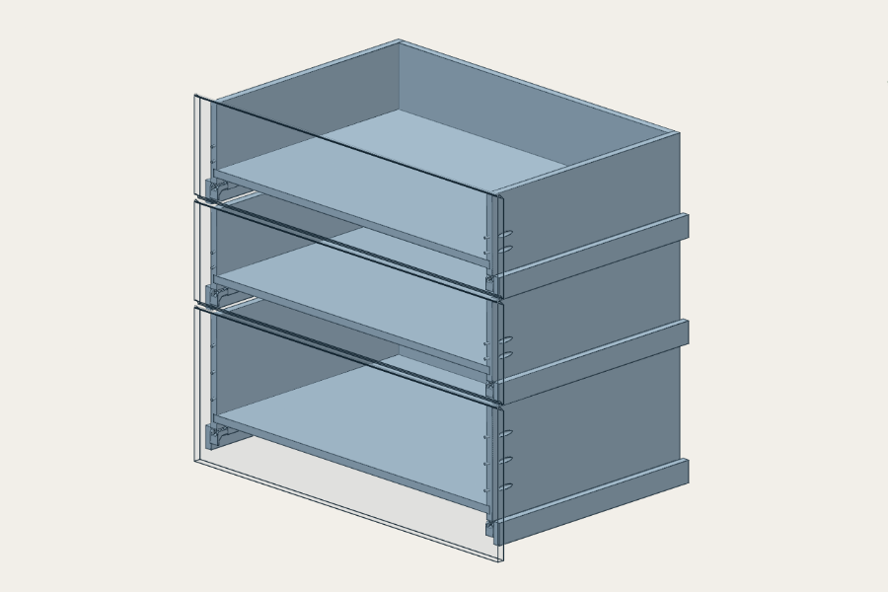
[picture p229: assembly/img/s_boxes.png]
All three boxes on their drawbars (fronts and near side removed for clarity).

*All three boxes on their drawbars (fronts and near side removed for clarity).*

1. Build D2 (same as D1) and D3 (taller: 231 sides, 226 back, 3 pocket holes per joint) exactly as in stage 6, with the finished fronts fitted last.
2. Before the boxes go in, fit the benchtop brackets and the link bolts (stage 9 steps 2 and 3): there is almost no room to drive screws beside the boxes afterwards. Keep the benchtop itself off until the boxes are in. Fit the boxes from the bottom up, D3 first, then D2, then D1.
3. Fronts overlap vertically: the nose of each mitre stays about 5 mm below the lowest point of the front above it, the rounded thin edge of its bottom mitre (a 10 mm overlap between the front panels; the clearance was 2 mm before that edge was rounded). It must not rise above that edge, or the upper front would catch it and pull the drawer below open. D1 and D2 are both 212.7 high, which puts D1's top edge where its mitre plane is 15 mm (vertically) below a parallel 45 degree plane through the back-bottom edge of the benchtop hem: that is the fingertip gap for opening D1. The bottom of D3's front hangs 5 below the underside of C3 and ends level with the bottom of the existing doors. Use 2 mm spacers between the fronts while you adjust.
4. Front heights: D1 and D2 are both 212.7, D3 is 326.3. The fronts are 802 wide, 1.5 in from each end of the carcass.
5. Fit the Hafele front-bracket fixings to the fronts as the Alto instructions describe. The model does not dimension these holes: mark them from the real brackets with the drawer seated.
6. Run each drawer in and out five times; check it closes against its soft-close, that the fronts are parallel and that the gaps hold.
7. Top strip (false front above D1): 802 x 32.3 x 15 ply, plain top, the same bottom mitre as D1 and D2 (15 high on the face, R2 back edge, R3 arris), with a 6 mm packer (775 x 20) behind it. Glue the packer to the back of the strip and to the front of the top rail C9, clamp, and let it set; it carries no load. To fix it mechanically as well, drive 4 No.8 x 75 screws forward from the back edge of C9 through the packer into the strip (counterbore the C9 end). It closes the open carcass top above D1 and makes the gap above D1 look like the gaps between the drawers.

## 11. Stage 9: kickboard, benchtop and joint to the main run

Finished unit with the benchtop extension and kickboard.
*Finished unit with the benchtop extension and kickboard.*

1. Kickboard Kb (852 x 115): hold it against the front of the plinth (it is 115 high, level with the existing kickboard, so the 5 mm gap under the doors matches), its face 60 behind the drawer fronts and its ends meeting the existing kickboard at the joint end. Fix it from inside the plinth with 4 No.8 x 25 screws through the front rail P1, 57.5 above the floor, at 100 and 300 either side of the centre line. It carries no load and can come off.
2. Benchtop brackets: 9 off, 25 x 25 x 2, 40 long. Three on the inside face of each side wall, centred 96, 256 and 416 back from the front edge of the carcass (clear of C9, the link bolts and the back panel), and three on the back panel, at the centre line and 250 either side. Fix the vertical leg to the carcass with two No.8 x 12 screws and the top leg up into the benchtop with two No.8 x 16 screws, so nothing comes through the 25 mm benchtop. The 2 mm vertical legs sit in the 16 mm gap beside the drawer boxes, so nothing blocks the top drawer.
3. Link bolts: two M6 x 65 bolts with washers through the two slots in C2 (fit them before the drawer boxes go in and before the benchtop goes on; the slots open to the top edge) into the main run's front framing rail. In the model that rail is moved back 14 mm so the bolts reach it. Check the bolt length and the rail position on site.
4. Place the existing benchtop extension (your 26 mm timber top, 820 x 600, with a 12 mm hem under the front edge only: 38 front overhang, 15 free-end overhang; the finished top surface is 900 above the floor) on the carcass, butt it to the main benchtop at the joint and fix it from below through the brackets.
5. Caulk the benchtop joint and finish.

## 12. Final checks

- Carcass: no rocking, sides vertical, diagonals equal, plinth hard on the floor.
- Each drawer: full extension, soft-close works, no rubbing against the walls (16 clear each side), front square and gap even.
- Snap clips seated in the brackets and the rear tabs in their notches; the box does not lift when you pull it out hard. (Option 2 alternative: both screws per side tight.)
- Pulls: you can get fingers behind each nose and into the funnel under each bottom mitre, and each drawer opens evenly.
- Benchtop: brackets tight, joint closed, link bolts tight.

## 13. Removal (semi-freestanding unit)

1. Empty and remove the drawers: pull each out, release the snap clips (or undo the screws from below if you used option 2), and lift the box off the drawbars.
2. Remove the kickboard Kb if it is in the way. Cut the caulk line at the benchtop joint, undo the bracket screws up into the benchtop and lift the benchtop extension off.
3. With the benchtop off, undo the two link bolts from inside the carcass and lift them out of the slots in C2.
4. Lift or slide the carcass and plinth out. The unit stands on its own plinth and is not fixed to the floor or to the main run except by the two bolts.

## 14. Things to confirm (open points)

- Front top rail C9 and the full-height back C4 stiffen the carcass; there is no rear top rail. The brackets and the benchtop complete the tie.
- Hafele load rating of the Alto 86 mm set against a loaded 15 mm ply bottom drawer is not checked: confirm it with Hafele before buying.
- The fronts are fixed rigidly to the boxes, so there is no front adjustment; the Hafele runner fixing screws and front-bracket fixings are not modelled.
- The Hafele front-bracket hole pattern and runner setback are not dimensioned (see the instruction sheet in the Alto set).
- The fixed runner is a 14 x 45 block in the model; the real section and its fixing plates are not modelled. The bracket outline on sheet 8 is approximate.
- The clip/bracket snap interference cannot be measured in the model; the clip position is an estimate. Test on the first drawer.
- The carcass and plinth joints are glued pocket-screw butt joints in 15 mm ply, a common cabinet-maker detail, not an engineered one. Add a rear top rail if the unit will be lifted by its sides.
- The mitre pull is the design for this build; test it on an offcut and on the first drawer before cutting the rest.
- Not covered here: the bin drawer, bay and sliding door that share the model, which are separate from this unit.
