tom-ainc/kitchen_bench_extension/assembly/img/pack_hero.png

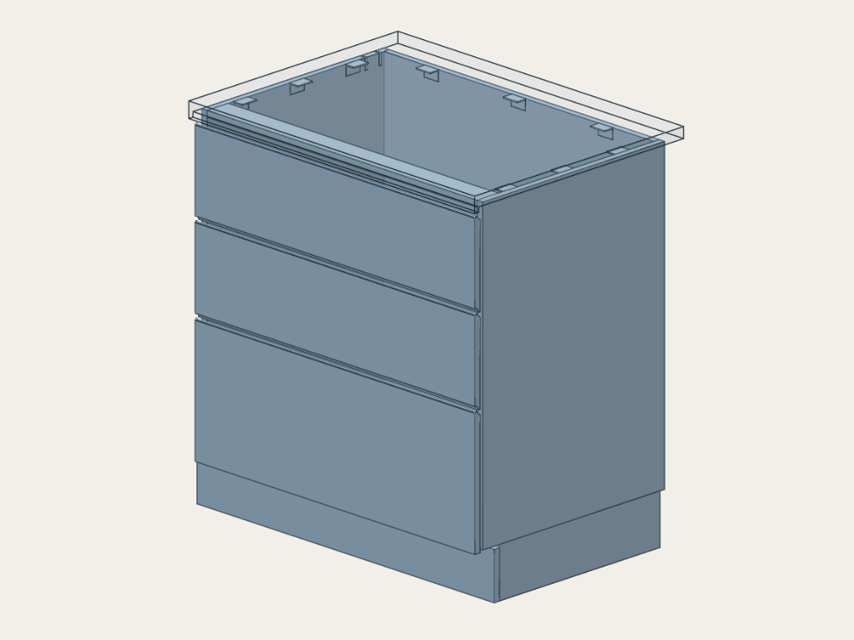
assembly/img/pack_hero.png
