tom-ainc/kitchen_bench_extension/golf_project/golf_out/v0037_assembly_guide_base/renders/r001/view_1_iso.png

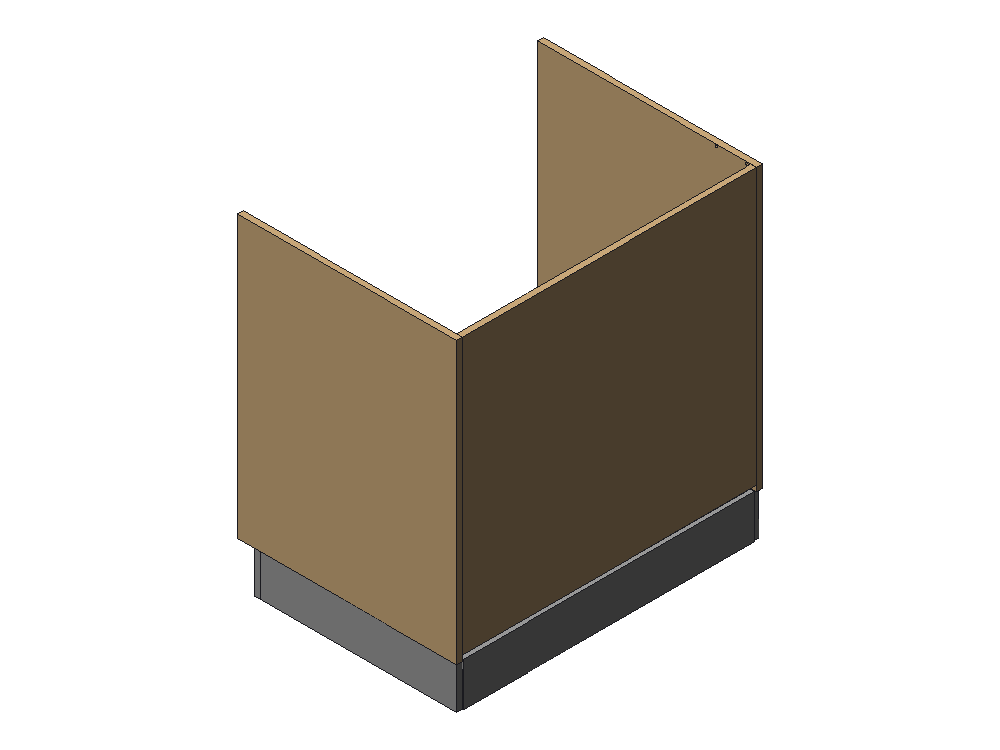
golf_project/golf_out/v0037_assembly_guide_base/renders/r001/view_1_iso.png
