tom-ainc/kitchen_bench_extension/golf_project/golf_out/v0037_assembly_guide_base/renders/r005/view_1__1.0__1.0__-0.8_.png

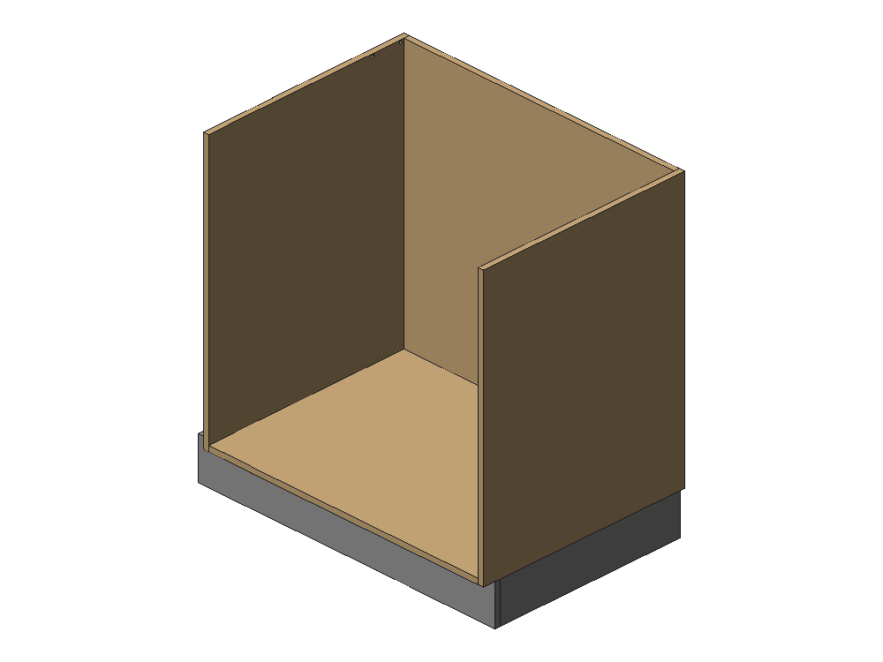
golf_project/golf_out/v0037_assembly_guide_base/renders/r005/view_1__1.0__1.0__-0.8_.png
