tom-ainc/kitchen_bench_extension/golf_project/golf_projects/kitchen_bench_extension-1/golf_out/v0009_step1_plinth/preview.png

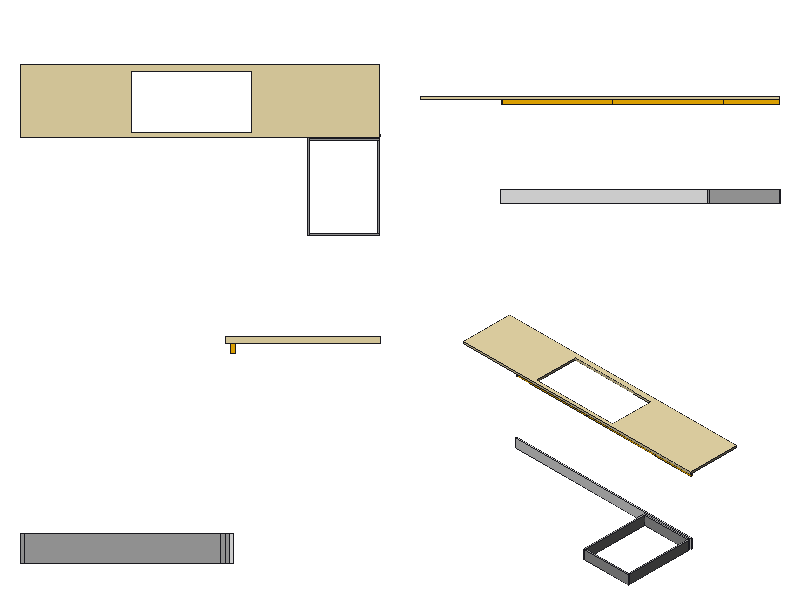
golf_project/golf_projects/kitchen_bench_extension-1/golf_out/v0009_step1_plinth/preview.png
