tom-ainc/kitchen_bench_extension/golf_project/golf_projects/kitchen_bench_extension-1/golf_out/v0010_step2_carcass/preview.png

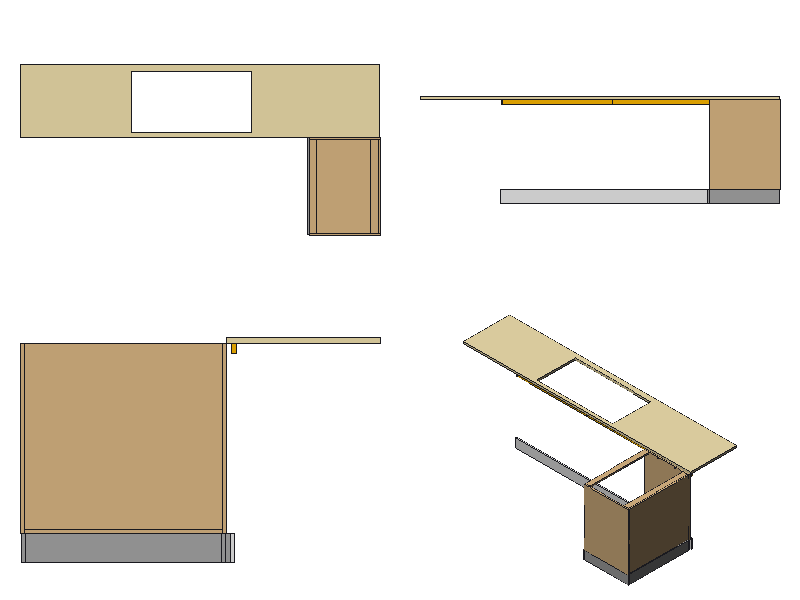
golf_project/golf_projects/kitchen_bench_extension-1/golf_out/v0010_step2_carcass/preview.png
