tom-ainc/kitchen_bench_extension/golf_project/golf_projects/kitchen_bench_extension-1/golf_out/v0019_step10_link_bolts_final/preview.png

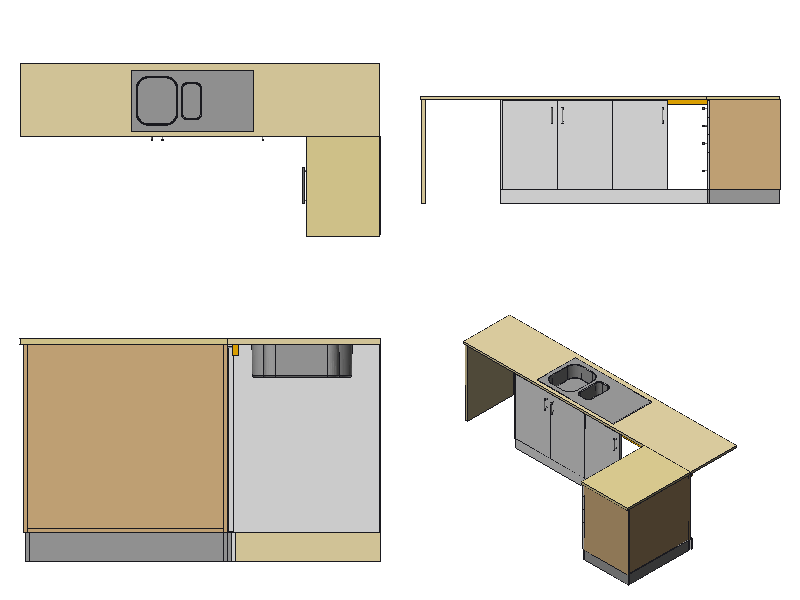
golf_project/golf_projects/kitchen_bench_extension-1/golf_out/v0019_step10_link_bolts_final/preview.png
