tom-ainc/kitchen_bench_extension/media/4.0 plinth_assembled.jpg

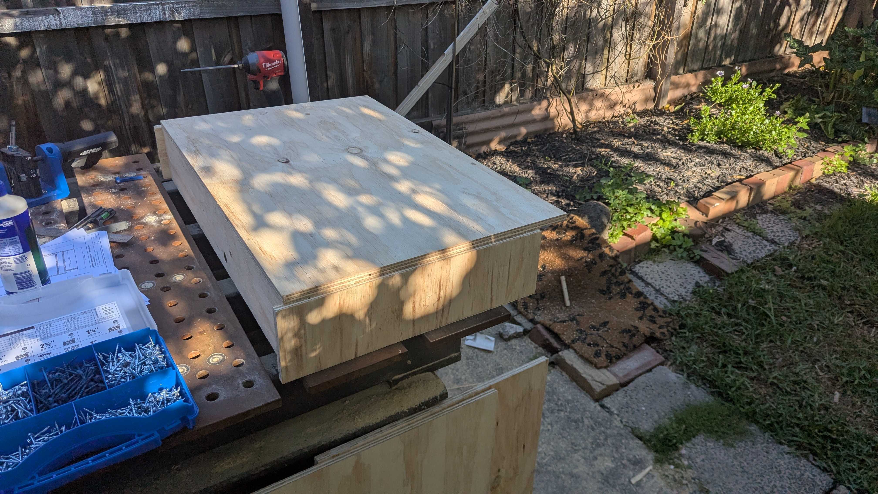
media/4.0 plinth_assembled.jpg
