tom-ainc/kitchen_bench_extension/media/5.0 carcass_assembled.jpg

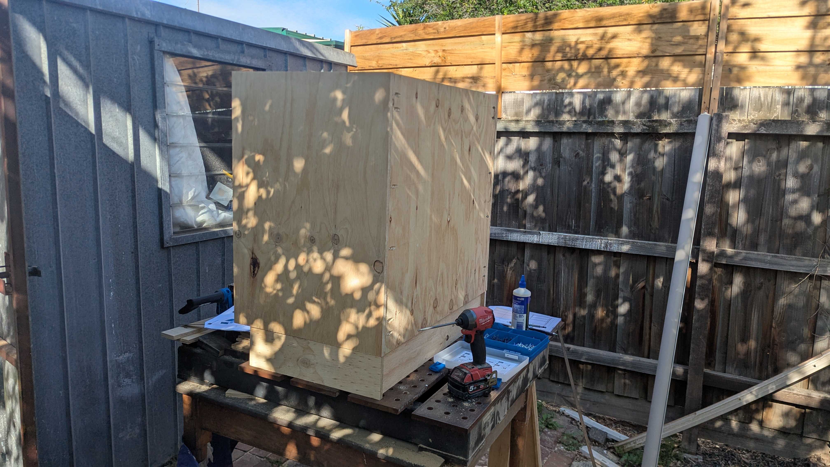
media/5.0 carcass_assembled.jpg
