tom-ainc/kitchen_bench_extension/media/5.1 carcass_assembled.jpg

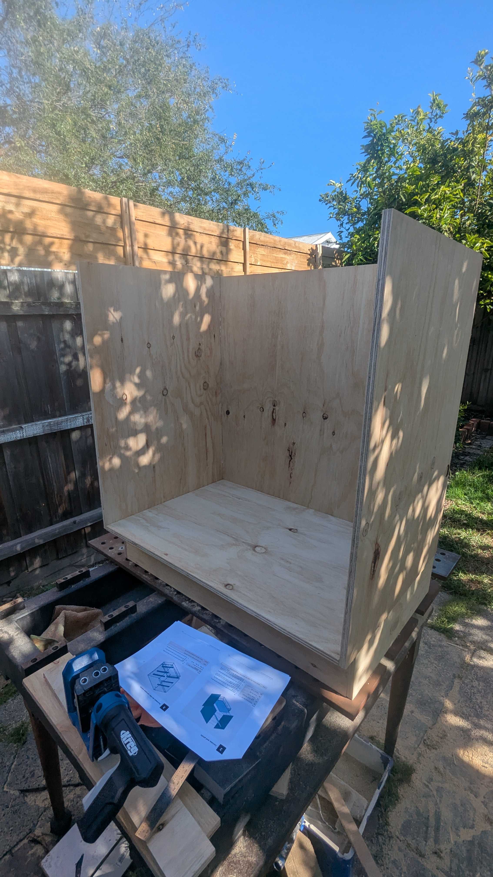
media/5.1 carcass_assembled.jpg
