tom-ainc/kitchen_bench_extension/media/10.0 assembled_drawers_in.jpg

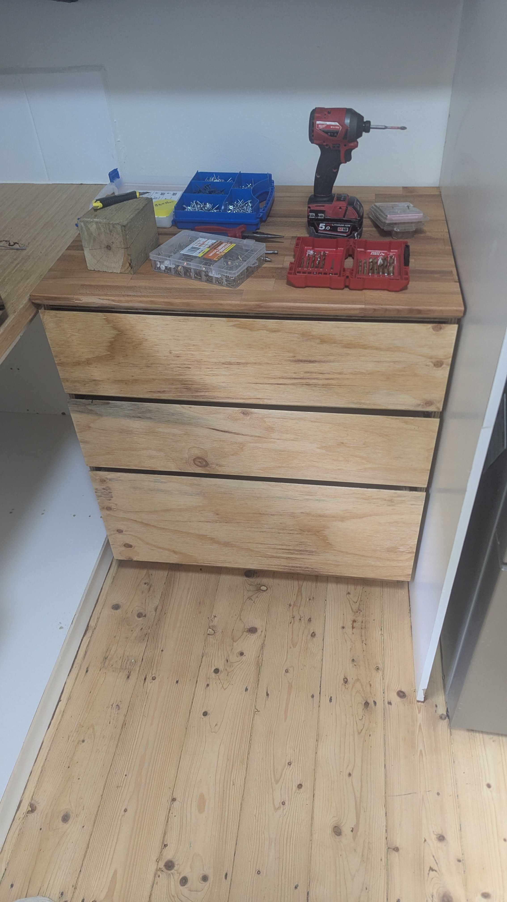
media/10.0 assembled_drawers_in.jpg
